osprey-dcs/Quartz/Quartz Design.xlsx

Boost Supply +12V -> +15V
Vin | 12
Vout | 15
Fosc | 1500000
DC |  | 0.2302631579
L1 | Ltyp | 1.796052632e-06 | Picked 6.8uH
 | Lmin | -3.215686275e-06 | 6.8e-06
 | Lmax | 9.978070175e-06
I ripple |  |  | 0.26413
I_OUT |  |  | 2.207557006
D1 |  |  | Using PDS360Q-13; 60V 3A
Cout | 2.400509402e-06 | Using 10uF | RDSon for PMOS is 8mOhm
Cin | 5.203495872e-07 | Using 10uF
Rfbx | 165618.2473 | Using 165kOhm
Rt | 53.4 | Using 53.6kOhm
Inverting Supply +12V -> -15V
Vin | 12
Vout | -15
Fosc | 1500000
DC |  | 0.5698529412
L1 | Ltyp | 4.444852941e-06 | Picked 15uH
 | Lmin | 1.490196078e-06 | 1.5e-05
 | Lmax | 2.469362745e-05
I ripple |  |  | 0.29632
I_OUT |  |  | 1.226709829
D1 |  |  | Using PD3S230H; 30V 2A
C1 |  |  | Using 2.2uF ; 50V | GCJ31CR71H225KA12L
Cout | 3.29248366e-07 | Using 10uF
Cin | 7.914624183e-07 | Using 10uF
Rfbx | 180156.0624 | Using 180kOhm
Rt | 53.4 | Using 53.6kOhm
