osprey-dcs/Quartz/Models/3dModels/c-5747847-06-o-3d.igs

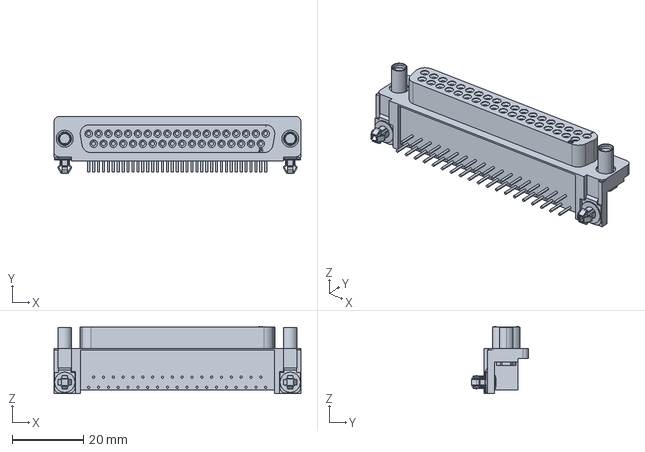
[picture p1: CAD file, 2024-01-31]
Models/3dModels/c-5747847-06-o-3d.igs
69.5 x 16.1 x 18.9 mm
