osprey-dcs/Quartz/Models/3dModels/EE2-3TNU-L.stp

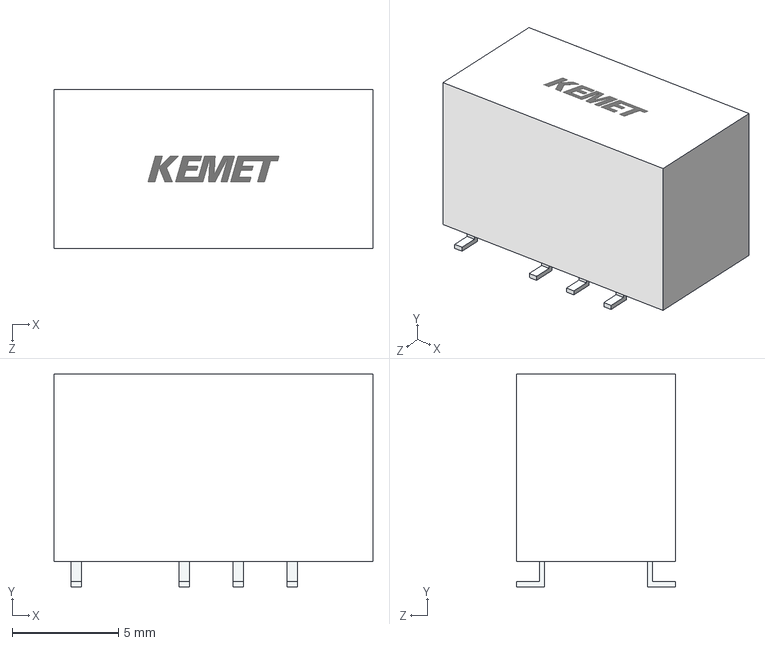
[picture p2: CAD file, 2024-01-31]
Models/3dModels/EE2-3TNU-L.stp
15.0 x 10.0 x 7.50 mm
