osprey-dcs/Quartz/Models/3dModels/901-144-8RFX.stp

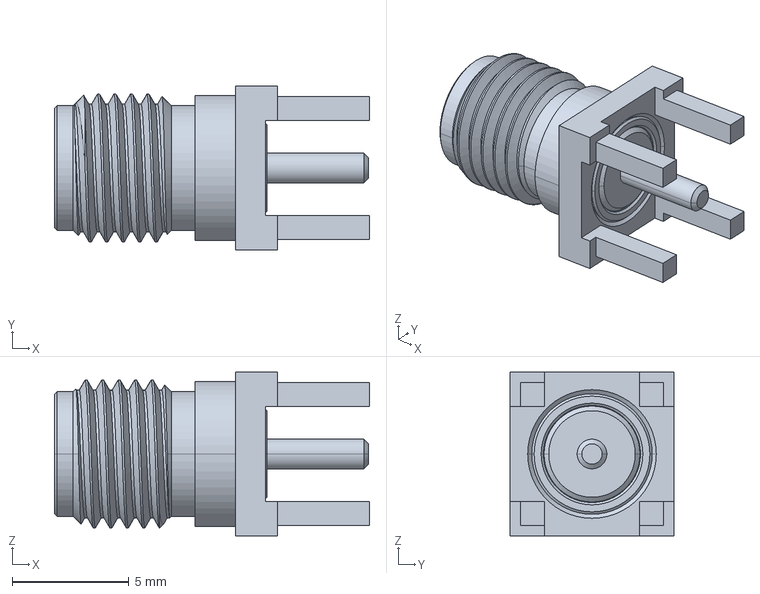
[picture p3: CAD file, 2024-01-31]
Models/3dModels/901-144-8RFX.stp
13.5 x 7.00 x 7.00 mm
