osprey-dcs/Quartz/Models/3dModels/EE2-12TNU-L.step

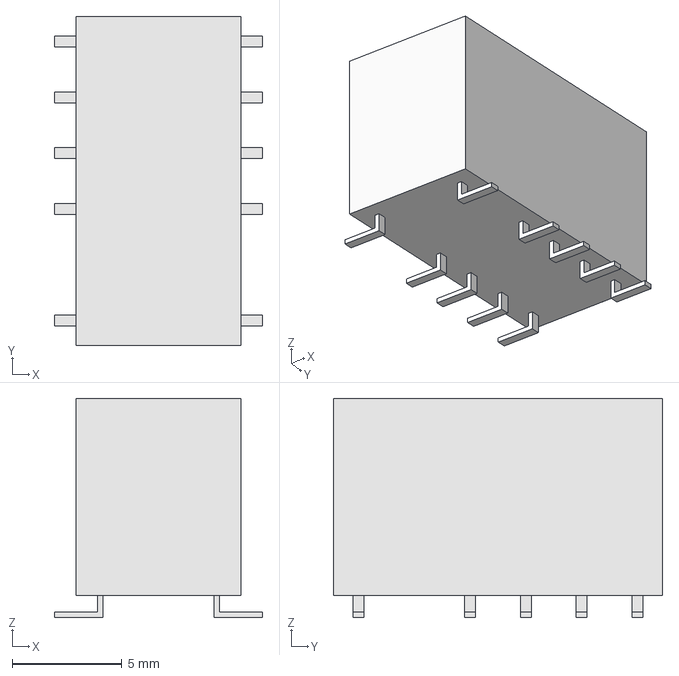
[picture p4: CAD file, 2024-01-31]
Models/3dModels/EE2-12TNU-L.step
9.50 x 15.0 x 10.0 mm
