osprey-dcs/Quartz/Models/3dModels/FDMC510P.stp

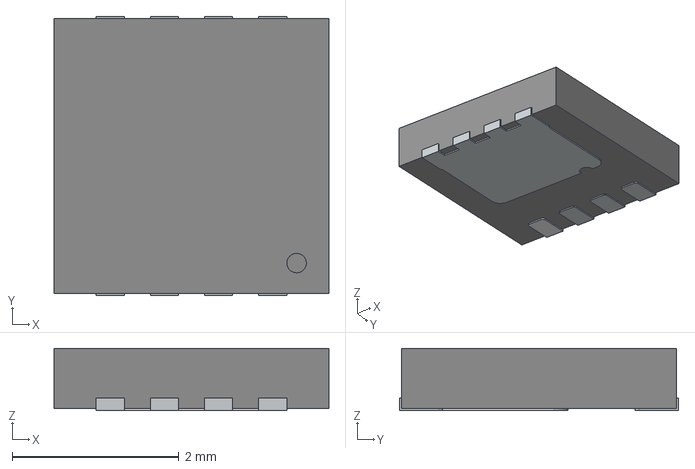
[picture p5: CAD file, 2024-01-31]
Models/3dModels/FDMC510P.stp
3.30 x 3.35 x 0.75 mm
