osprey-dcs/Quartz/Models/3dModels/Coilcraft-MSD1260-DEFAULT.IGS

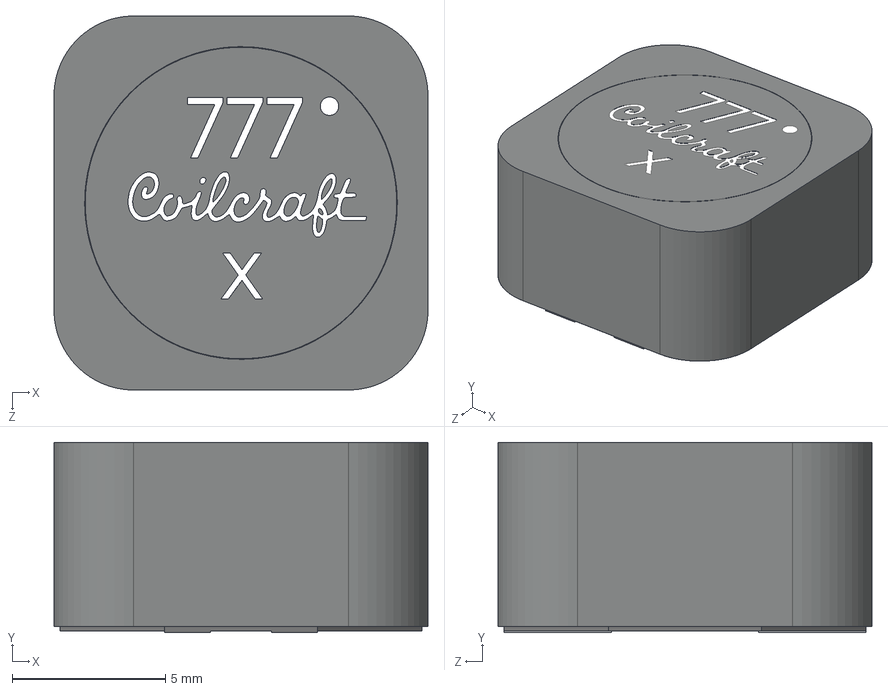
[picture p6: CAD file, 2024-01-31]
Models/3dModels/Coilcraft-MSD1260-DEFAULT.IGS
12.2 x 6.20 x 12.2 mm
