osprey-dcs/Quartz/Models/3dModels/LT3097ADJC.step

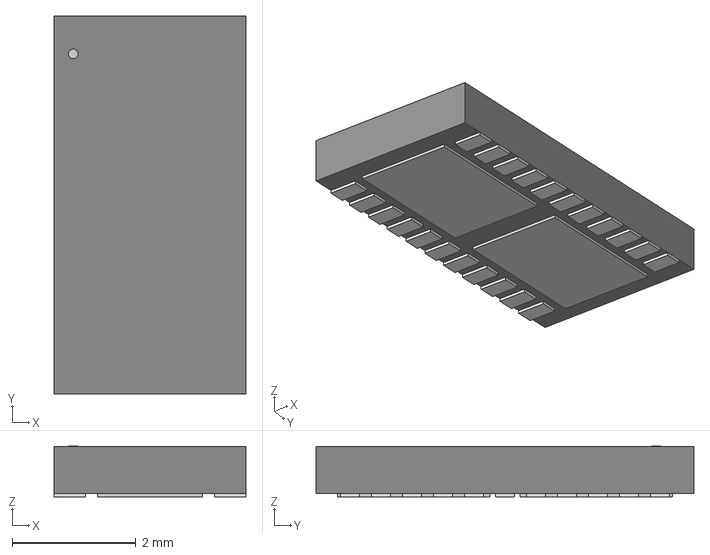
[picture p7: CAD file, 2024-01-31]
Models/3dModels/LT3097ADJC.step
3.10 x 6.10 x 0.815 mm
