osprey-dcs/Quartz/Models/3dModels/SIL0008D.stp

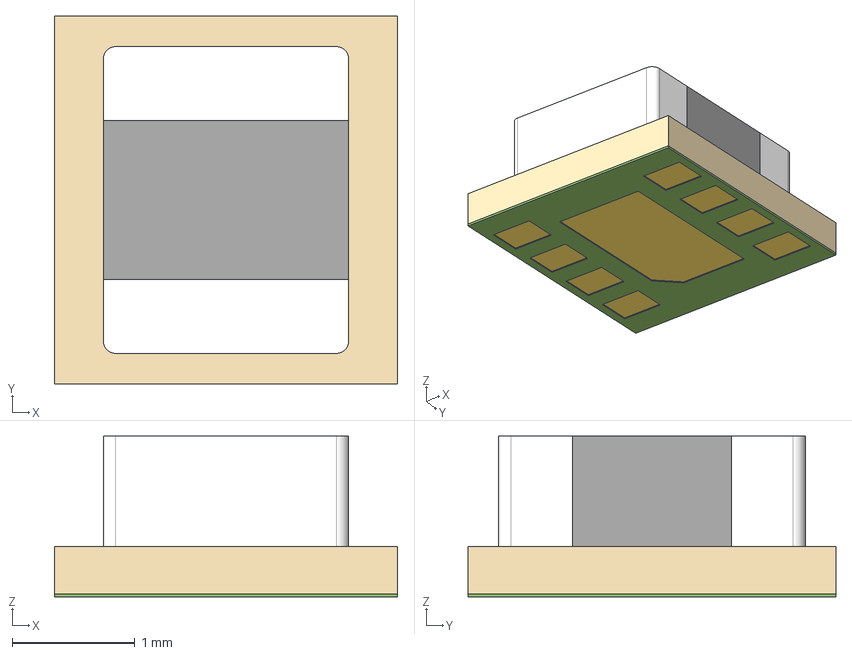
[picture p8: CAD file, 2024-01-31]
Models/3dModels/SIL0008D.stp
2.80 x 3.00 x 1.31 mm
SOLDERMASK-SIP
METAL-SIL0008D
SUBSTRATE-SIP
INDUCTOR-BODY-MLV
INDUCTOR-TERMNL-MLV x 2
