osprey-dcs/Quartz/Models/3dModels/PDS360Q-13.stp

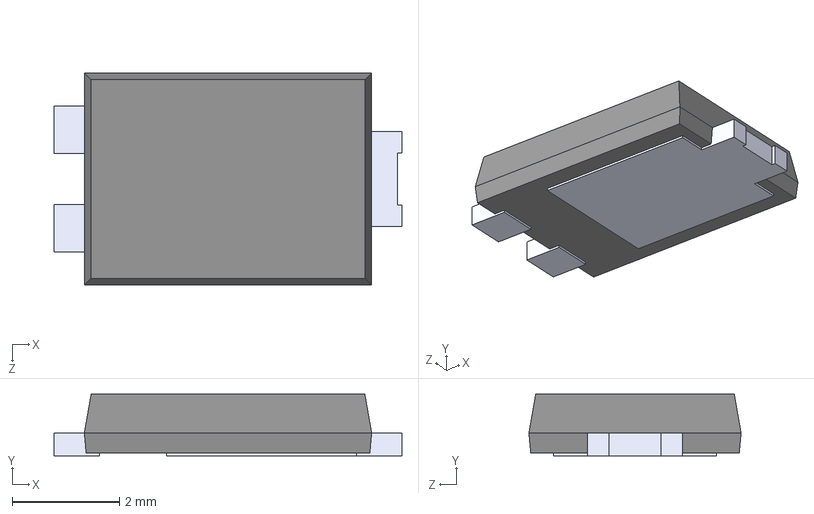
[picture p9: CAD file, 2024-01-31]
Models/3dModels/PDS360Q-13.stp
6.50 x 1.15 x 3.97 mm
