osprey-dcs/Quartz/Models/3dModels/ASP-134604-01.stp

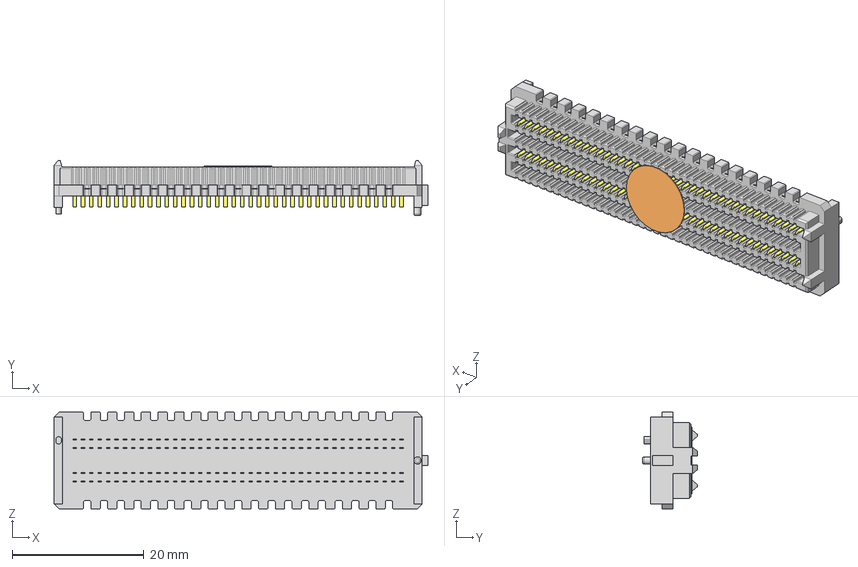
[picture p10: CAD file, 2024-01-31]
Models/3dModels/ASP-134604-01.stp
56.7 x 8.38 x 14.7 mm
K_Pad_0.404
SEAM-LPC-40-03.5-S-10-1-A_PINS
SEAM-40-03.5-10-A_BODY_
