osprey-dcs/Quartz/Models/3dModels/Coilcraft-XAL6060.IGS

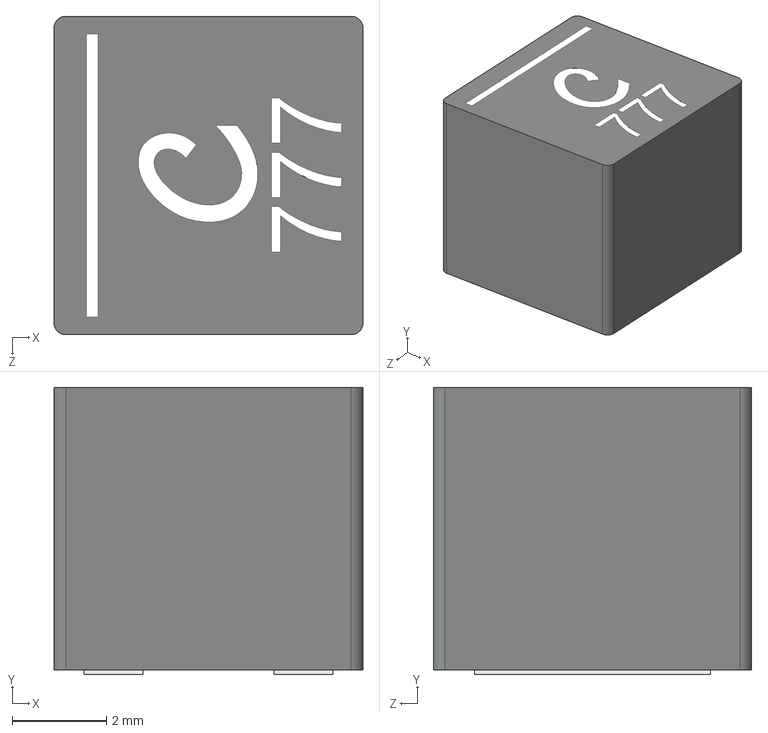
[picture p11: CAD file, 2024-01-31]
Models/3dModels/Coilcraft-XAL6060.IGS
6.56 x 6.10 x 6.76 mm
