osprey-dcs/Quartz/Models/3dModels/MSD1260-153MLD.stp

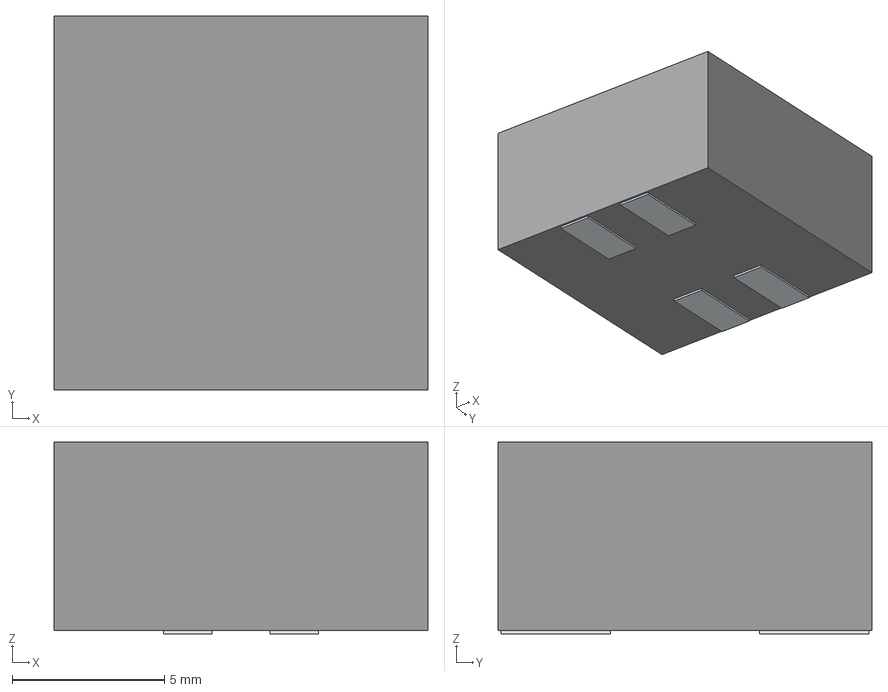
[picture p12: CAD file, 2024-01-31]
Models/3dModels/MSD1260-153MLD.stp
12.3 x 12.3 x 6.30 mm
Pins
