osprey-dcs/Quartz/(list of files, cad)

Other CAD files:
Models/3dModels/5747847-06-o-3d.stp
Models/3dModels/ASP-134604-01.stl
Models/3dModels/LT3097ADJC.iges
Models/3dModels/LT3097ADJC.stl
