osprey-dcs/Quartz/Documentation/Quartz Test Points.pdf

# Quartz Testing Points

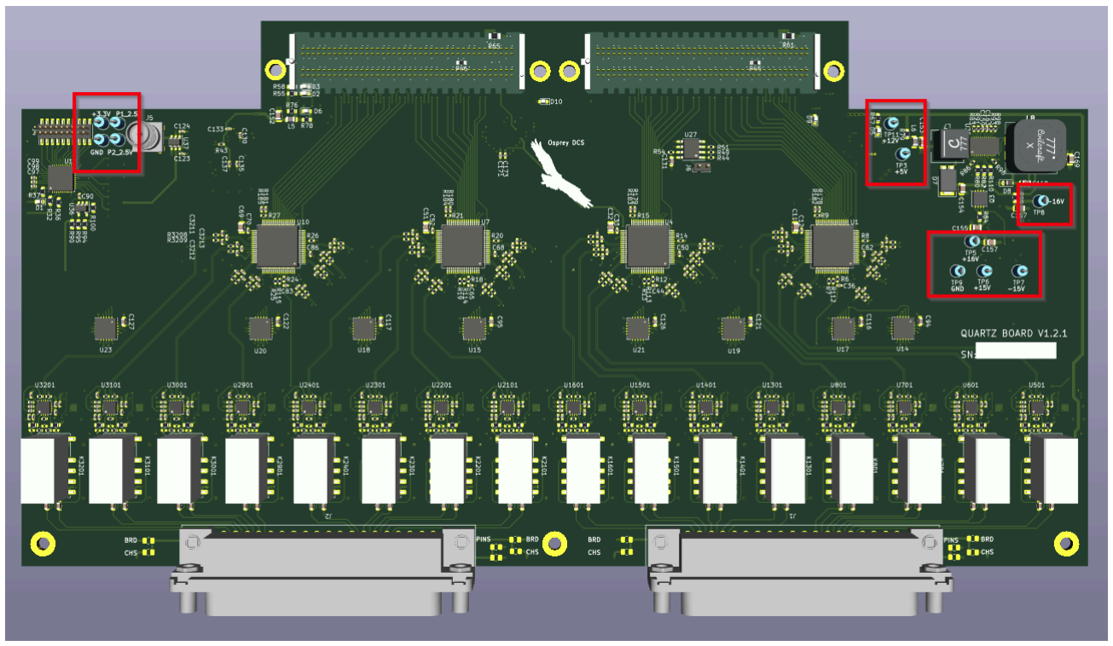
[picture p13: figure]

Image 1: 3D render of Quartz Boards with test points called out

Test Point Reference | Silkscreened Label | Nominal Voltage
TP 1 | P1_2P5V | +2.5V
TP 2 | P2_2P5V | +2.5V
TP 3 | +5V | +5V
TP 4 | +3.3V | +3.3V
TP 5 | +16V | +16V
TP 6 | +15V | +15V
TP 7 | -15V | -15V
TP 8 | -16V | -16V
TP 9 | GND | 0V
TP 10 | GND | 0V
TP 11 | +12V | +12V
Table 1:Test Point Names
