osprey-dcs/Quartz/Quartz.kicad_pcb

## KiCad design Quartz.kicad_pcb (2025-04-18)

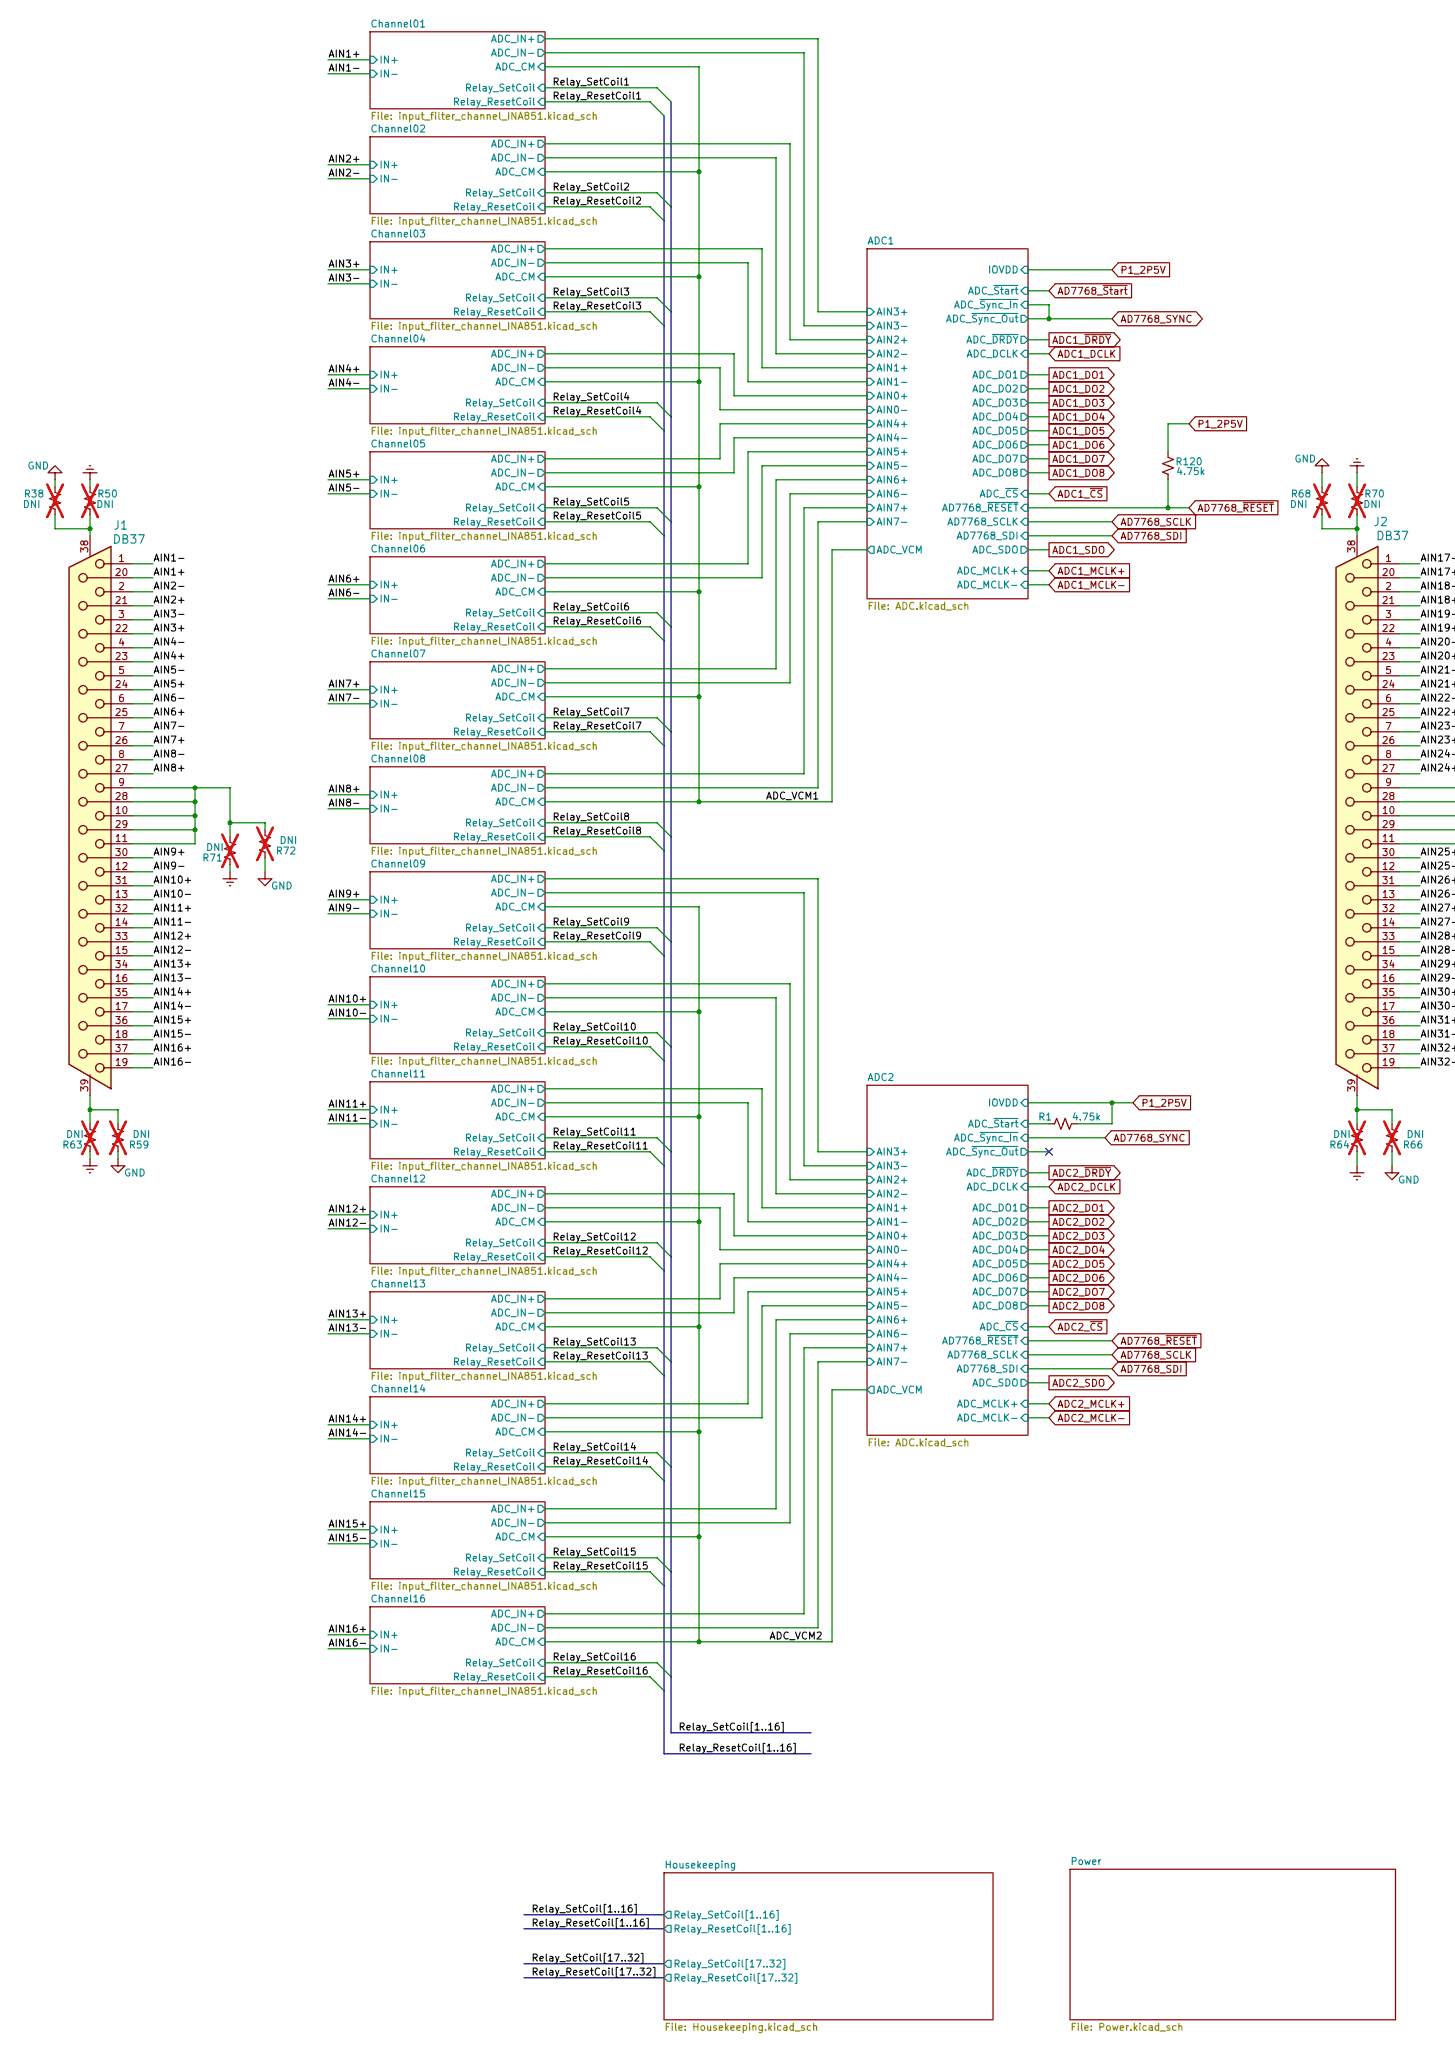
[picture p14: schematic Quartz.kicad_sch, part in row 1, column 1]

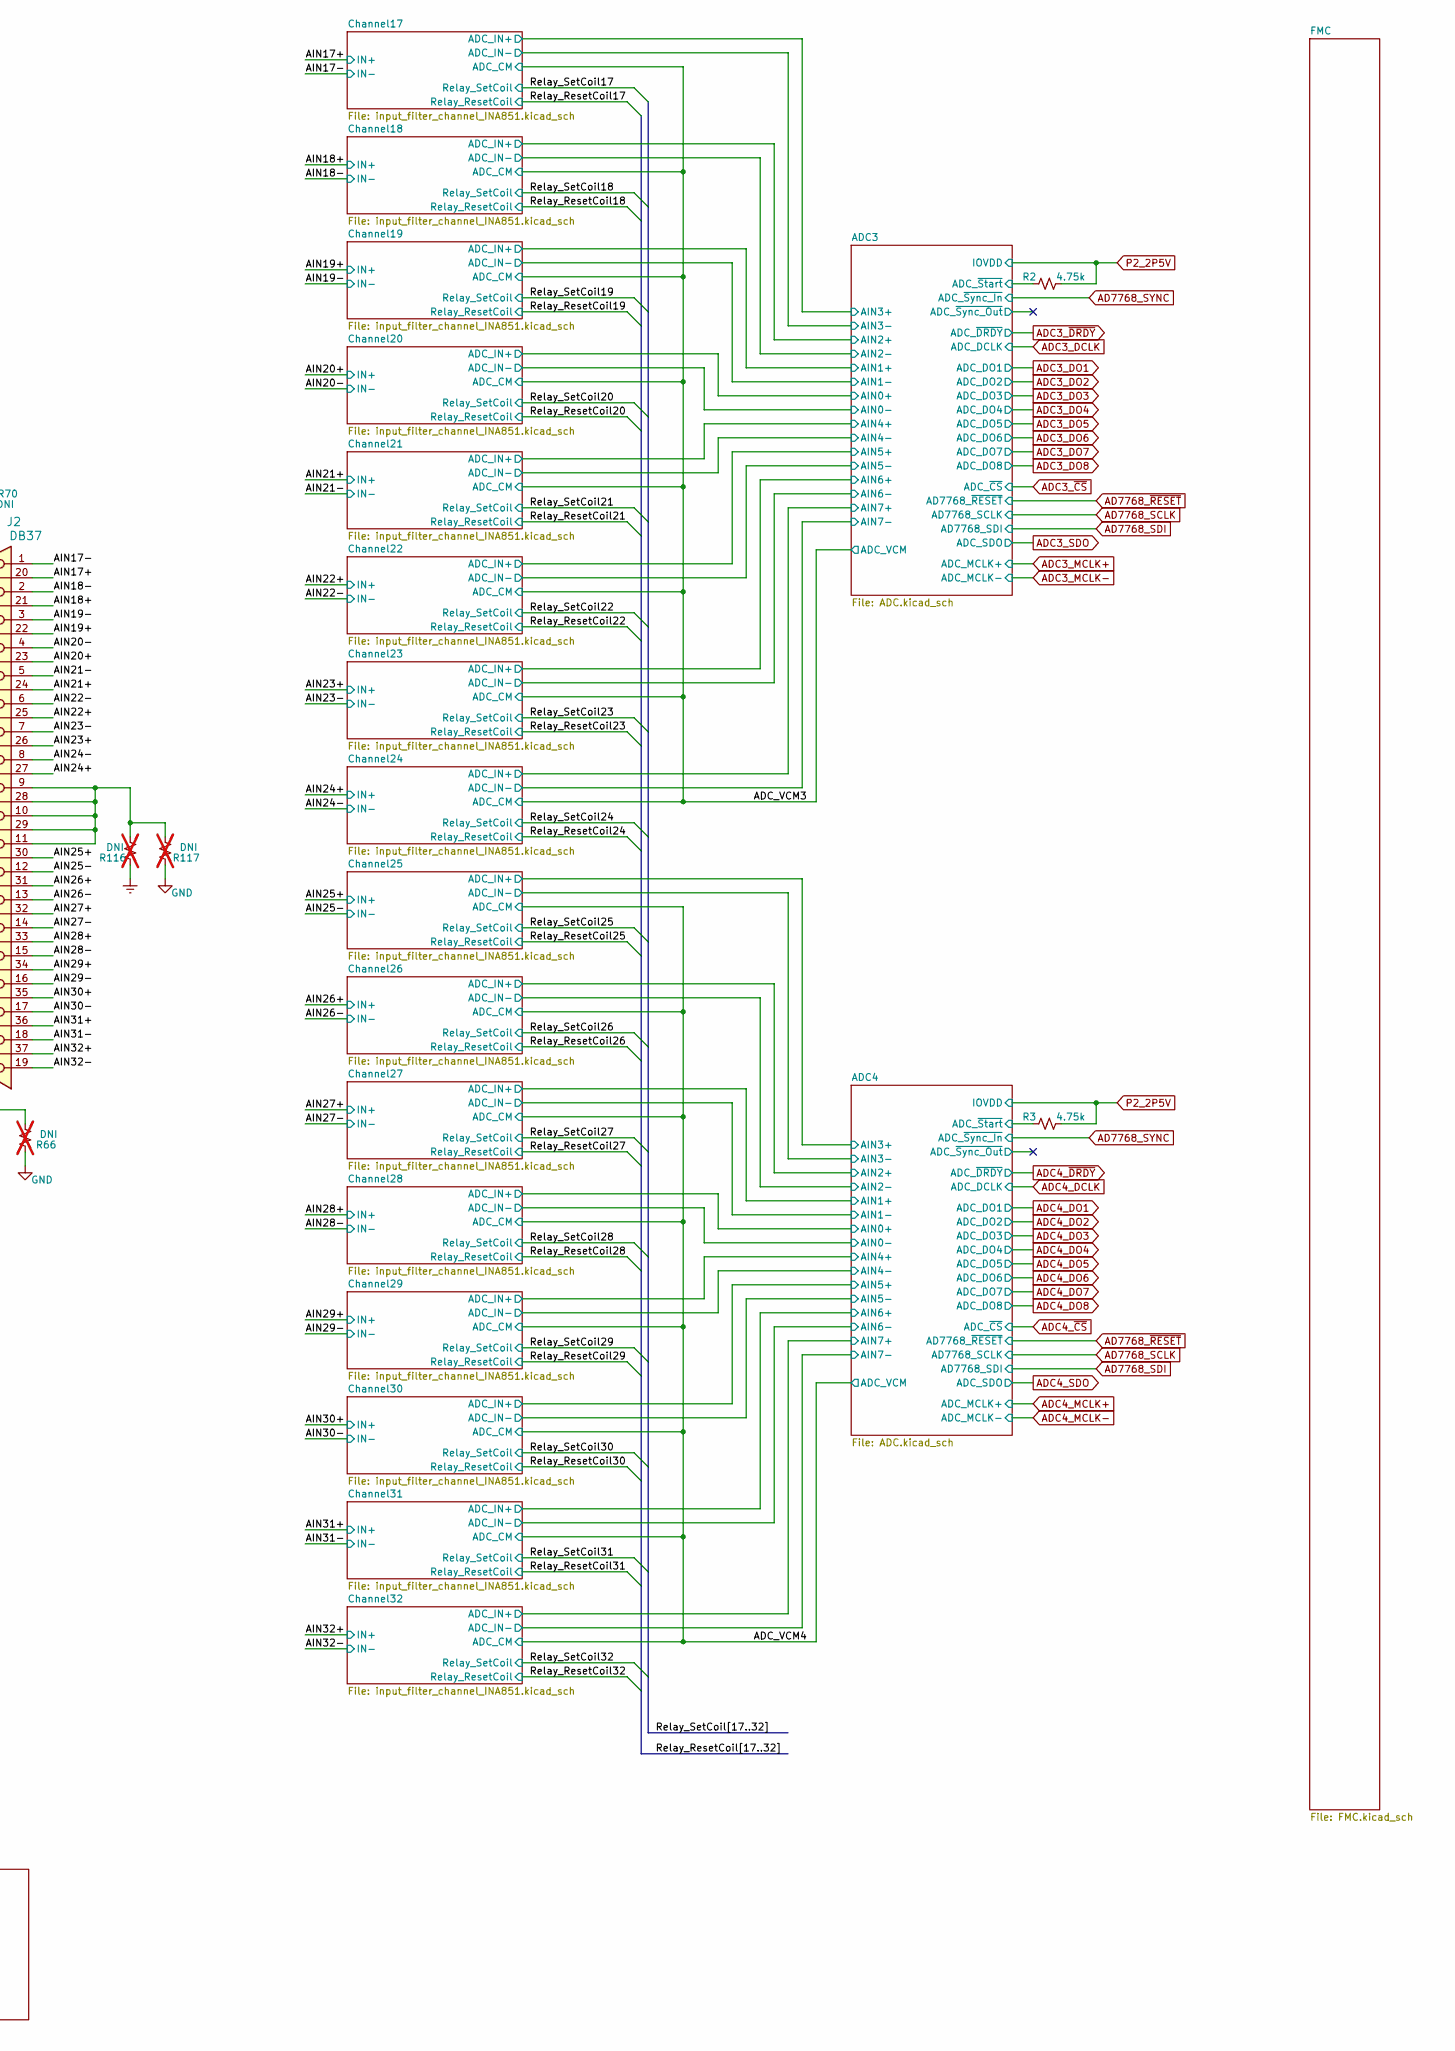
[picture p15: schematic Quartz.kicad_sch, part in row 1, column 2]

Parts:
J1, J2: DB37; CONN_5747847-6_TYC; MPN 5747847-6
R1, R2, R3, R120: 4.75k; R_0402_1005Metric; MPN RC0402FR-074K75L
R38, R50, R59, R63, R64, R66, R68, R70, R71, R72, R116, R117: DNI; R_0805_2012Metric; MPN DNI; not fitted

Connections:
/ADC2/ADC_~Start: R1.1; also elsewhere on the board
/ADC3/ADC_~Start: R2.1; also elsewhere on the board
/ADC4/ADC_~Start: R3.1; also elsewhere on the board
/AIN1+: J1.20; also elsewhere on the board
/AIN1-: J1.1; also elsewhere on the board
/AIN2+: J1.21; also elsewhere on the board
/AIN2-: J1.2; also elsewhere on the board
/AIN3+: J1.22; also elsewhere on the board
/AIN3-: J1.3; also elsewhere on the board
/AIN4+: J1.23; also elsewhere on the board
/AIN4-: J1.4; also elsewhere on the board
/AIN5+: J1.24; also elsewhere on the board
/AIN5-: J1.5; also elsewhere on the board
/AIN6+: J1.25; also elsewhere on the board
/AIN6-: J1.6; also elsewhere on the board
/AIN7+: J1.26; also elsewhere on the board
/AIN7-: J1.7; also elsewhere on the board
/AIN8+: J1.27; also elsewhere on the board
/AIN8-: J1.8; also elsewhere on the board
/AIN9+: J1.30; also elsewhere on the board
/AIN9-: J1.12; also elsewhere on the board
/AIN10+: J1.31; also elsewhere on the board
/AIN10-: J1.13; also elsewhere on the board
/AIN11+: J1.32; also elsewhere on the board
/AIN11-: J1.14; also elsewhere on the board
/AIN12+: J1.33; also elsewhere on the board
/AIN12-: J1.15; also elsewhere on the board
/AIN13+: J1.34; also elsewhere on the board
/AIN13-: J1.16; also elsewhere on the board
/AIN14+: J1.35; also elsewhere on the board
/AIN14-: J1.17; also elsewhere on the board
/AIN15+: J1.36; also elsewhere on the board
/AIN15-: J1.18; also elsewhere on the board
/AIN16+: J1.37; also elsewhere on the board
/AIN16-: J1.19; also elsewhere on the board
/AIN17+: J2.20; also elsewhere on the board
/AIN17-: J2.1; also elsewhere on the board
/AIN18+: J2.21; also elsewhere on the board
/AIN18-: J2.2; also elsewhere on the board
/AIN19+: J2.22; also elsewhere on the board
/AIN19-: J2.3; also elsewhere on the board
/AIN20+: J2.23; also elsewhere on the board
/AIN20-: J2.4; also elsewhere on the board
/AIN21+: J2.24; also elsewhere on the board
/AIN21-: J2.5; also elsewhere on the board
/AIN22+: J2.25; also elsewhere on the board
/AIN22-: J2.6; also elsewhere on the board
/AIN23+: J2.26; also elsewhere on the board
/AIN23-: J2.7; also elsewhere on the board
/AIN24+: J2.27; also elsewhere on the board
/AIN24-: J2.8; also elsewhere on the board
/AIN25+: J2.30; also elsewhere on the board
/AIN25-: J2.12; also elsewhere on the board
/AIN26+: J2.31; also elsewhere on the board
/AIN26-: J2.13; also elsewhere on the board
/AIN27+: J2.32; also elsewhere on the board
/AIN27-: J2.14; also elsewhere on the board
/AIN28+: J2.33; also elsewhere on the board
/AIN28-: J2.15; also elsewhere on the board
/AIN29+: J2.34; also elsewhere on the board
/AIN29-: J2.16; also elsewhere on the board
/AIN30+: J2.35; also elsewhere on the board
/AIN30-: J2.17; also elsewhere on the board
/AIN31+: J2.36; also elsewhere on the board
/AIN31-: J2.18; also elsewhere on the board
/AIN32+: J2.37; also elsewhere on the board
/AIN32-: J2.19; also elsewhere on the board
AD7768_~RESET: R120.1; also elsewhere on the board
Earth: R50.1, R63.1, R64.1, R70.1, R71.1, R116.1; also elsewhere on the board
GND: R38.1, R59.1, R66.1, R68.1, R72.1, R117.1; also elsewhere on the board
unnamed: J1.9, J1.10, J1.11, J1.28, J1.29, R71.2, R72.2
unnamed: J1.38, R38.2, R50.2
unnamed: J1.39, R59.2, R63.2
unnamed: J2.9, J2.10, J2.11, J2.28, J2.29, R116.2, R117.2
unnamed: J2.38, R68.2, R70.2
unnamed: J2.39, R64.2, R66.2
P1_2P5V: R1.2, R120.2; also elsewhere on the board
P2_2P5V: R2.2, R3.2; also elsewhere on the board
