osprey-dcs/Quartz/Quartz.kicad_pcb

## KiCad design Quartz.kicad_pcb (continued)

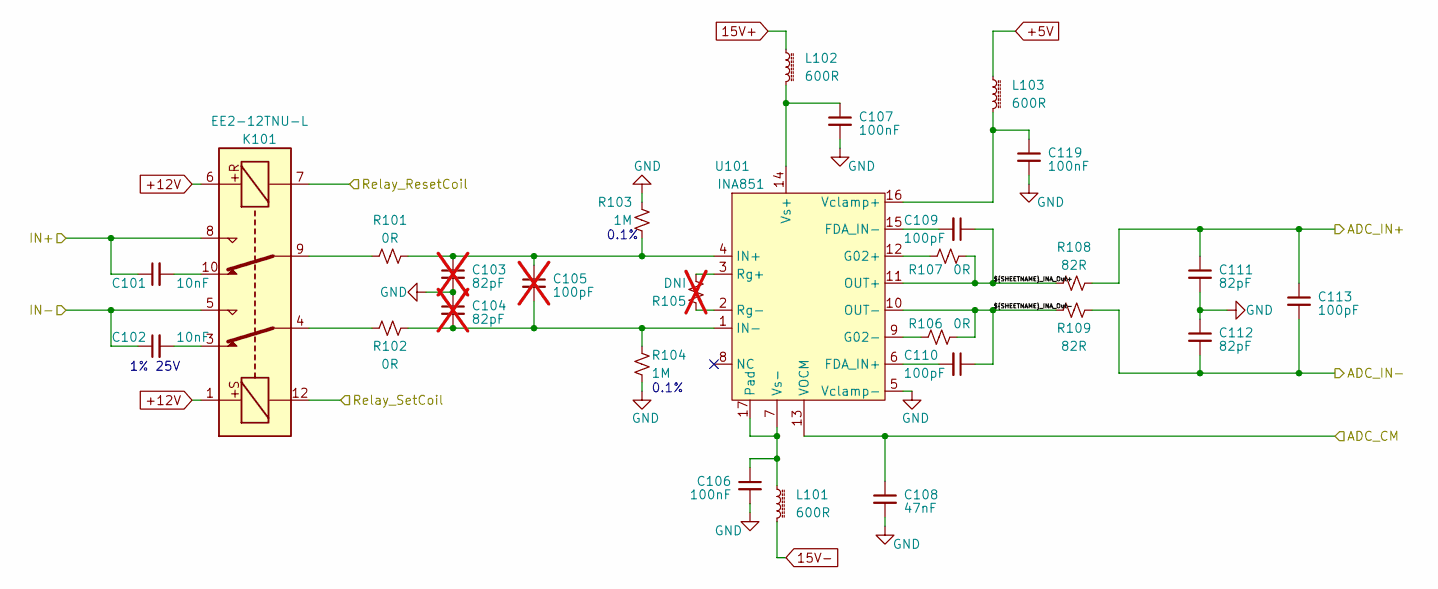
[picture p16: schematic input_filter_channel_INA851.kicad_sch, Quartz]

Parts:
C101, C102: 10nF; C_0603_1608Metric; MPN C0603C103F3GAC7867
C103, C104: 82pF; C_0402_1005Metric; MPN DNI; not fitted
C105: 100pF; C_0402_1005Metric; MPN DNI; not fitted
C106, C107, C119: 100nF; C_0402_1005Metric; MPN CL05A104KA5NNNC
C108: 47nF; C_0402_1005Metric; MPN CGA2B3X7R1H473K050BB
C109, C110, C113: 100pF; C_0402_1005Metric; MPN GRM1555C1H101JA01D
C111, C112: 82pF; C_0402_1005Metric; MPN CC0402JRNPO9BN820
K101: EE2-12TNU-L; Relay_DPDT_Kemet_EE2_NU_DoubleCoil; MPN EE2-12TNU-L
L101, L102, L103: 600R; L_0402_1005Metric; MPN BLM15AX601SN1D
R101, R102, R106, R107: 0R; R_0603_1608Metric; MPN ERJ-2GE0R00X
R103, R104: 1M; R_0603_1608Metric; MPN CPF0603B1M0E1
R105: DNI; R_0402_1005Metric; MPN TNPW040211K8BEED; not fitted
R108, R109: 82R; R_0402_1005Metric; MPN RC0402FR-0782RL
U101: INA851; QFN-16-1EP_3x3mm_P0.5mm_EP1.75x1.75mm_ThermalVias; MPN INA851RGTR

Connections:
15V+: L102.1; also elsewhere on the board
15V-: L101.2; also elsewhere on the board
+5V: L103.1; also elsewhere on the board
+12V: K101.1, K101.6; also elsewhere on the board
/ADC1/AIN3+: C111.1, C113.1, R108.2; also elsewhere on the board
/ADC1/AIN3-: C112.2, C113.2, R109.2; also elsewhere on the board
/ADC_VCM1: C108.1, U101.13 (VOCM); also elsewhere on the board
/AIN1+: C101.1, K101.8; also elsewhere on the board
/AIN1-: C102.1, K101.5; also elsewhere on the board
/Channel01/Channel01_INA_Out+: C109.1, R107.2, R108.1, U101.11 (OUT+)
/Channel01/Channel01_INA_Out-: C110.1, R106.2, R109.1, U101.10 (OUT-)
/Relay_ResetCoil1: K101.7; also elsewhere on the board
/Relay_SetCoil1: K101.12; also elsewhere on the board
GND: C103.2, C104.1, C106.2, C107.2, C108.2, C111.2, C112.1, C119.2, R103.1, R104.1, U101.5 (Vclamp-); also elsewhere on the board
unnamed: C101.2, K101.10
unnamed: C102.2, K101.3
unnamed: K101.4, R102.1
unnamed: K101.9, R101.1
unnamed: C110.2, U101.6 (FDA_IN+)
unnamed: C109.2, U101.15 (FDA_IN-)
unnamed: R107.1, U101.12 (G02+)
unnamed: R106.1, U101.9 (G02-)
unnamed: C103.1, C105.1, R101.2, R103.2, U101.4 (IN+)
unnamed: C104.2, C105.2, R102.2, R104.2, U101.1 (IN-)
unnamed: R105.1, U101.3 (Rg+)
unnamed: R105.2, U101.2 (Rg-)
unnamed: C119.1, L103.2, U101.16 (Vclamp+)
unnamed: C107.1, L102.2, U101.14 (Vs+)
unnamed: C106.1, L101.1, U101.7 (Vs-), U101.17 (Pad)

Parts of its further copies:
C201, C202, C301, C302, C401, C402, C501, C502, C601, C602, C701, C702, C801, C802, C901, C902, C1001, C1002, C1101, C1102, C1201, C1202, C1301, C1302, C1401, C1402, C1501, C1502, C1601, C1602, C1701, C1702, C1801, C1802, C1901, C1902, C2001, C2002, C2101, C2102, C2201, C2202, C2301, C2302, C2401, C2402, C2501, C2502, C2601, C2602, C2701, C2702, C2801, C2802, C2901, C2902, C3001, C3002, C3101, C3102, C3201, C3202: 10nF; C_0603_1608Metric; MPN C0603C103F3GAC7867
C203, C204, C303, C304, C403, C404, C503, C504, C603, C604, C703, C704, C803, C804, C903, C904, C1003, C1004, C1103, C1104, C1203, C1204, C1303, C1304, C1403, C1404, C1503, C1504, C1603, C1604, C1703, C1704, C1803, C1804, C1903, C1904, C2003, C2004, C2103, C2104, C2203, C2204, C2303, C2304, C2403, C2404, C2503, C2504, C2603, C2604, C2703, C2704, C2803, C2804, C2903, C2904, C3003, C3004, C3103, C3104, C3203, C3204: 82pF; C_0402_1005Metric; MPN DNI; not fitted
C205, C305, C405, C505, C605, C705, C805, C905, C1005, C1105, C1205, C1305, C1405, C1505, C1605, C1705, C1805, C1905, C2005, C2105, C2205, C2305, C2405, C2505, C2605, C2705, C2805, C2905, C3005, C3105, C3205: 100pF; C_0402_1005Metric; MPN DNI; not fitted
C206, C207, C214, C306, C307, C314, C406, C407, C414, C506, C507, C514, C606, C607, C614, C706, C707, C714, C806, C807, C814, C906, C907, C914, C1006, C1007, C1014, C1106, C1107, C1114, C1206, C1207, C1214, C1306, C1307, C1314, C1406, C1407, C1414, C1506, C1507, C1514, C1606, C1607, C1614, C1706, C1707, C1714, C1806, C1807, C1814, C1906, C1907, C1914, C2006, C2007, C2014, C2106, C2107, C2114, C2206, C2207, C2214, C2306, C2307, C2314, C2406, C2407, C2414, C2506, C2507, C2514, C2606, C2607, C2614, C2706, C2707, C2714, C2806, C2807, C2814, C2906, C2907, C2914, C3006, C3007, C3014, C3106, C3107, C3114, C3206, C3207, C3214: 100nF; C_0402_1005Metric; MPN CL05A104KA5NNNC
C208, C308, C408, C508, C608, C708, C808, C908, C1008, C1108, C1208, C1308, C1408, C1508, C1608, C1708, C1808, C1908, C2008, C2108, C2208, C2308, C2408, C2508, C2608, C2708, C2808, C2908, C3008, C3108, C3208: 47nF; C_0402_1005Metric; MPN CGA2B3X7R1H473K050BB
C209, C210, C213, C309, C310, C313, C409, C410, C413, C509, C510, C513, C609, C610, C613, C709, C710, C713, C809, C810, C813, C909, C910, C913, C1009, C1010, C1013, C1109, C1110, C1113, C1209, C1210, C1213, C1309, C1310, C1313, C1409, C1410, C1413, C1509, C1510, C1513, C1609, C1610, C1613, C1709, C1710, C1713, C1809, C1810, C1813, C1909, C1910, C1913, C2009, C2010, C2013, C2109, C2110, C2113, C2209, C2210, C2213, C2309, C2310, C2313, C2409, C2410, C2413, C2509, C2510, C2513, C2609, C2610, C2613, C2709, C2710, C2713, C2809, C2810, C2813, C2909, C2910, C2913, C3009, C3010, C3013, C3109, C3110, C3113, C3209, C3210, C3213: 100pF; C_0402_1005Metric; MPN GRM1555C1H101JA01D
C211, C212, C311, C312, C411, C412, C511, C512, C611, C612, C711, C712, C811, C812, C911, C912, C1011, C1012, C1111, C1112, C1211, C1212, C1311, C1312, C1411, C1412, C1511, C1512, C1611, C1612, C1711, C1712, C1811, C1812, C1911, C1912, C2011, C2012, C2111, C2112, C2211, C2212, C2311, C2312, C2411, C2412, C2511, C2512, C2611, C2612, C2711, C2712, C2811, C2812, C2911, C2912, C3011, C3012, C3111, C3112, C3211, C3212: 82pF; C_0402_1005Metric; MPN CC0402JRNPO9BN820
K201, K301, K401, K501, K601, K701, K801, K901, K1001, K1101, K1201, K1301, K1401, K1501, K1601, K1701, K1801, K1901, K2001, K2101, K2201, K2301, K2401, K2501, K2601, K2701, K2801, K2901, K3001, K3101, K3201: EE2-12TNU-L; Relay_DPDT_Kemet_EE2_NU_DoubleCoil; MPN EE2-12TNU-L
L201, L202, L203, L301, L302, L303, L401, L402, L403, L501, L502, L503, L601, L602, L603, L701, L702, L703, L801, L802, L803, L901, L902, L903, L1001, L1002, L1003, L1101, L1102, L1103, L1201, L1202, L1203, L1301, L1302, L1303, L1401, L1402, L1403, L1501, L1502, L1503, L1601, L1602, L1603, L1701, L1702, L1703, L1801, L1802, L1803, L1901, L1902, L1903, L2001, L2002, L2003, L2101, L2102, L2103, L2201, L2202, L2203, L2301, L2302, L2303, L2401, L2402, L2403, L2501, L2502, L2503, L2601, L2602, L2603, L2701, L2702, L2703, L2801, L2802, L2803, L2901, L2902, L2903, L3001, L3002, L3003, L3101, L3102, L3103, L3201, L3202, L3203: 600R; L_0402_1005Metric; MPN BLM15AX601SN1D
R201, R202, R206, R207, R301, R302, R306, R307, R401, R402, R406, R407, R501, R502, R506, R507, R601, R602, R606, R607, R701, R702, R706, R707, R801, R802, R806, R807, R901, R902, R906, R907, R1001, R1002, R1006, R1007, R1101, R1102, R1106, R1107, R1201, R1202, R1206, R1207, R1301, R1302, R1306, R1307, R1401, R1402, R1406, R1407, R1501, R1502, R1506, R1507, R1601, R1602, R1606, R1607, R1701, R1702, R1706, R1707, R1801, R1802, R1806, R1807, R1901, R1902, R1906, R1907, R2001, R2002, R2006, R2007, R2101, R2102, R2106, R2107, R2201, R2202, R2206, R2207, R2301, R2302, R2306, R2307, R2401, R2402, R2406, R2407, R2501, R2502, R2506, R2507, R2601, R2602, R2606, R2607, R2701, R2702, R2706, R2707, R2801, R2802, R2806, R2807, R2901, R2902, R2906, R2907, R3001, R3002, R3006, R3007, R3101, R3102, R3106, R3107, R3201, R3202, R3206, R3207: 0R; R_0603_1608Metric; MPN ERJ-2GE0R00X
R203, R204, R303, R304, R403, R404, R503, R504, R603, R604, R703, R704, R803, R804, R903, R904, R1003, R1004, R1103, R1104, R1203, R1204, R1303, R1304, R1403, R1404, R1503, R1504, R1603, R1604, R1703, R1704, R1803, R1804, R1903, R1904, R2003, R2004, R2103, R2104, R2203, R2204, R2303, R2304, R2403, R2404, R2503, R2504, R2603, R2604, R2703, R2704, R2803, R2804, R2903, R2904, R3003, R3004, R3103, R3104, R3203, R3204: 1M; R_0603_1608Metric; MPN CPF0603B1M0E1
R205, R305, R405, R505, R605, R705, R805, R905, R1005, R1105, R1205, R1305, R1405, R1505, R1605, R1705, R1805, R1905, R2005, R2105, R2205, R2305, R2405, R2505, R2605, R2705, R2805, R2905, R3005, R3105, R3205: DNI; R_0402_1005Metric; MPN TNPW040211K8BEED; not fitted
R208, R209, R308, R309, R408, R409, R508, R509, R608, R609, R708, R709, R808, R809, R908, R909, R1008, R1009, R1108, R1109, R1208, R1209, R1308, R1309, R1408, R1409, R1508, R1509, R1608, R1609, R1708, R1709, R1808, R1809, R1908, R1909, R2008, R2009, R2108, R2109, R2208, R2209, R2308, R2309, R2408, R2409, R2508, R2509, R2608, R2609, R2708, R2709, R2808, R2809, R2908, R2909, R3008, R3009, R3108, R3109, R3208, R3209: 82R; R_0402_1005Metric; MPN RC0402FR-0782RL
U201, U301, U401, U501, U601, U701, U801, U901, U1001, U1101, U1201, U1301, U1401, U1501, U1601, U1701, U1801, U1901, U2001, U2101, U2201, U2301, U2401, U2501, U2601, U2701, U2801, U2901, U3001, U3101, U3201: INA851; QFN-16-1EP_3x3mm_P0.5mm_EP1.75x1.75mm_ThermalVias; MPN INA851RGTR

Connections of its further copies:
15V+: L202.1, L302.1, L402.1, L502.1, L602.1, L702.1, L802.1, L902.1, L1002.1, L1102.1, L1202.1, L1302.1, L1402.1, L1502.1, L1602.1, L1702.1, L1802.1, L1902.1, L2002.1, L2102.1, L2202.1, L2302.1, L2402.1, L2502.1, L2602.1, L2702.1, L2802.1, L2902.1, L3002.1, L3102.1, L3202.1; also elsewhere on the board
15V-: L201.2, L301.2, L401.2, L501.2, L601.2, L701.2, L801.2, L901.2, L1001.2, L1101.2, L1201.2, L1301.2, L1401.2, L1501.2, L1601.2, L1701.2, L1801.2, L1901.2, L2001.2, L2101.2, L2201.2, L2301.2, L2401.2, L2501.2, L2601.2, L2701.2, L2801.2, L2901.2, L3001.2, L3101.2, L3201.2; also elsewhere on the board
+5V: L203.1, L303.1, L403.1, L503.1, L603.1, L703.1, L803.1, L903.1, L1003.1, L1103.1, L1203.1, L1303.1, L1403.1, L1503.1, L1603.1, L1703.1, L1803.1, L1903.1, L2003.1, L2103.1, L2203.1, L2303.1, L2403.1, L2503.1, L2603.1, L2703.1, L2803.1, L2903.1, L3003.1, L3103.1, L3203.1; also elsewhere on the board
+12V: K201.1, K201.6, K301.1, K301.6, K401.1, K401.6, K501.1, K501.6, K601.1, K601.6, K701.1, K701.6, K801.1, K801.6, K901.1, K901.6, K1001.1, K1001.6, K1101.1, K1101.6, K1201.1, K1201.6, K1301.1, K1301.6, K1401.1, K1401.6, K1501.1, K1501.6, K1601.1, K1601.6, K1701.1, K1701.6, K1801.1, K1801.6, K1901.1, K1901.6, K2001.1, K2001.6, K2101.1, K2101.6, K2201.1, K2201.6, K2301.1, K2301.6, K2401.1, K2401.6, K2501.1, K2501.6, K2601.1, K2601.6, K2701.1, K2701.6, K2801.1, K2801.6, K2901.1, K2901.6, K3001.1, K3001.6, K3101.1, K3101.6, K3201.1, K3201.6; also elsewhere on the board
/ADC1/AIN0+: C411.1, C413.1, R408.2; also elsewhere on the board
/ADC1/AIN0-: C412.2, C413.2, R409.2; also elsewhere on the board
/ADC1/AIN1+: C311.1, C313.1, R308.2; also elsewhere on the board
/ADC1/AIN1-: C312.2, C313.2, R309.2; also elsewhere on the board
/ADC1/AIN2+: C211.1, C213.1, R208.2; also elsewhere on the board
/ADC1/AIN2-: C212.2, C213.2, R209.2; also elsewhere on the board
/ADC1/AIN4+: C511.1, C513.1, R508.2; also elsewhere on the board
/ADC1/AIN4-: C512.2, C513.2, R509.2; also elsewhere on the board
/ADC1/AIN5+: C611.1, C613.1, R608.2; also elsewhere on the board
/ADC1/AIN5-: C612.2, C613.2, R609.2; also elsewhere on the board
/ADC1/AIN6+: C711.1, C713.1, R708.2; also elsewhere on the board
/ADC1/AIN6-: C712.2, C713.2, R709.2; also elsewhere on the board
/ADC1/AIN7+: C811.1, C813.1, R808.2; also elsewhere on the board
/ADC1/AIN7-: C812.2, C813.2, R809.2; also elsewhere on the board
/ADC2/AIN0+: C1211.1, C1213.1, R1208.2; also elsewhere on the board
/ADC2/AIN0-: C1212.2, C1213.2, R1209.2; also elsewhere on the board
/ADC2/AIN1+: C1111.1, C1113.1, R1108.2; also elsewhere on the board
/ADC2/AIN1-: C1112.2, C1113.2, R1109.2; also elsewhere on the board
/ADC2/AIN2+: C1011.1, C1013.1, R1008.2; also elsewhere on the board
/ADC2/AIN2-: C1012.2, C1013.2, R1009.2; also elsewhere on the board
/ADC2/AIN3+: C911.1, C913.1, R908.2; also elsewhere on the board
/ADC2/AIN3-: C912.2, C913.2, R909.2; also elsewhere on the board
/ADC2/AIN4+: C1311.1, C1313.1, R1308.2; also elsewhere on the board
/ADC2/AIN4-: C1312.2, C1313.2, R1309.2; also elsewhere on the board
/ADC2/AIN5+: C1411.1, C1413.1, R1408.2; also elsewhere on the board
/ADC2/AIN5-: C1412.2, C1413.2, R1409.2; also elsewhere on the board
/ADC2/AIN6+: C1511.1, C1513.1, R1508.2; also elsewhere on the board
/ADC2/AIN6-: C1512.2, C1513.2, R1509.2; also elsewhere on the board
/ADC2/AIN7+: C1611.1, C1613.1, R1608.2; also elsewhere on the board
/ADC2/AIN7-: C1612.2, C1613.2, R1609.2; also elsewhere on the board
/ADC3/AIN0+: C2011.1, C2013.1, R2008.2; also elsewhere on the board
/ADC3/AIN0-: C2012.2, C2013.2, R2009.2; also elsewhere on the board
/ADC3/AIN1+: C1911.1, C1913.1, R1908.2; also elsewhere on the board
/ADC3/AIN1-: C1912.2, C1913.2, R1909.2; also elsewhere on the board
/ADC3/AIN2+: C1811.1, C1813.1, R1808.2; also elsewhere on the board
/ADC3/AIN2-: C1812.2, C1813.2, R1809.2; also elsewhere on the board
/ADC3/AIN3+: C1711.1, C1713.1, R1708.2; also elsewhere on the board
/ADC3/AIN3-: C1712.2, C1713.2, R1709.2; also elsewhere on the board
/ADC3/AIN4+: C2111.1, C2113.1, R2108.2; also elsewhere on the board
/ADC3/AIN4-: C2112.2, C2113.2, R2109.2; also elsewhere on the board
/ADC3/AIN5+: C2211.1, C2213.1, R2208.2; also elsewhere on the board
/ADC3/AIN5-: C2212.2, C2213.2, R2209.2; also elsewhere on the board
/ADC3/AIN6+: C2311.1, C2313.1, R2308.2; also elsewhere on the board
/ADC3/AIN6-: C2312.2, C2313.2, R2309.2; also elsewhere on the board
/ADC3/AIN7+: C2411.1, C2413.1, R2408.2; also elsewhere on the board
/ADC3/AIN7-: C2412.2, C2413.2, R2409.2; also elsewhere on the board
/ADC4/AIN0+: C2811.1, C2813.1, R2808.2; also elsewhere on the board
/ADC4/AIN0-: C2812.2, C2813.2, R2809.2; also elsewhere on the board
/ADC4/AIN1+: C2711.1, C2713.1, R2708.2; also elsewhere on the board
/ADC4/AIN1-: C2712.2, C2713.2, R2709.2; also elsewhere on the board
/ADC4/AIN2+: C2611.1, C2613.1, R2608.2; also elsewhere on the board
/ADC4/AIN2-: C2612.2, C2613.2, R2609.2; also elsewhere on the board
/ADC4/AIN3+: C2511.1, C2513.1, R2508.2; also elsewhere on the board
/ADC4/AIN3-: C2512.2, C2513.2, R2509.2; also elsewhere on the board
/ADC4/AIN4+: C2911.1, C2913.1, R2908.2; also elsewhere on the board
/ADC4/AIN4-: C2912.2, C2913.2, R2909.2; also elsewhere on the board
/ADC4/AIN5+: C3011.1, C3013.1, R3008.2; also elsewhere on the board
/ADC4/AIN5-: C3012.2, C3013.2, R3009.2; also elsewhere on the board
/ADC4/AIN6+: C3111.1, C3113.1, R3108.2; also elsewhere on the board
/ADC4/AIN6-: C3112.2, C3113.2, R3109.2; also elsewhere on the board
/ADC4/AIN7+: C3211.1, C3213.1, R3208.2; also elsewhere on the board
/ADC4/AIN7-: C3212.2, C3213.2, R3209.2; also elsewhere on the board
/ADC_VCM1: C208.1, C308.1, C408.1, C508.1, C608.1, C708.1, C808.1, U201.13 (VOCM), U301.13 (VOCM), U401.13 (VOCM), U501.13 (VOCM), U601.13 (VOCM), U701.13 (VOCM), U801.13 (VOCM); also elsewhere on the board
/ADC_VCM2: C908.1, C1008.1, C1108.1, C1208.1, C1308.1, C1408.1, C1508.1, C1608.1, U901.13 (VOCM), U1001.13 (VOCM), U1101.13 (VOCM), U1201.13 (VOCM), U1301.13 (VOCM), U1401.13 (VOCM), U1501.13 (VOCM), U1601.13 (VOCM); also elsewhere on the board
/ADC_VCM3: C1708.1, C1808.1, C1908.1, C2008.1, C2108.1, C2208.1, C2308.1, C2408.1, U1701.13 (VOCM), U1801.13 (VOCM), U1901.13 (VOCM), U2001.13 (VOCM), U2101.13 (VOCM), U2201.13 (VOCM), U2301.13 (VOCM), U2401.13 (VOCM); also elsewhere on the board
/ADC_VCM4: C2508.1, C2608.1, C2708.1, C2808.1, C2908.1, C3008.1, C3108.1, C3208.1, U2501.13 (VOCM), U2601.13 (VOCM), U2701.13 (VOCM), U2801.13 (VOCM), U2901.13 (VOCM), U3001.13 (VOCM), U3101.13 (VOCM), U3201.13 (VOCM); also elsewhere on the board
/AIN2+: C201.1, K201.8; also elsewhere on the board
/AIN2-: C202.1, K201.5; also elsewhere on the board
/AIN3+: C301.1, K301.8; also elsewhere on the board
/AIN3-: C302.1, K301.5; also elsewhere on the board
/AIN4+: C401.1, K401.8; also elsewhere on the board
/AIN4-: C402.1, K401.5; also elsewhere on the board
/AIN5+: C501.1, K501.8; also elsewhere on the board
/AIN5-: C502.1, K501.5; also elsewhere on the board
/AIN6+: C601.1, K601.8; also elsewhere on the board
/AIN6-: C602.1, K601.5; also elsewhere on the board
/AIN7+: C701.1, K701.8; also elsewhere on the board
/AIN7-: C702.1, K701.5; also elsewhere on the board
/AIN8+: C801.1, K801.8; also elsewhere on the board
/AIN8-: C802.1, K801.5; also elsewhere on the board
/AIN9+: C901.1, K901.8; also elsewhere on the board
/AIN9-: C902.1, K901.5; also elsewhere on the board
/AIN10+: C1001.1, K1001.8; also elsewhere on the board
/AIN10-: C1002.1, K1001.5; also elsewhere on the board
/AIN11+: C1101.1, K1101.8; also elsewhere on the board
/AIN11-: C1102.1, K1101.5; also elsewhere on the board
/AIN12+: C1201.1, K1201.8; also elsewhere on the board
/AIN12-: C1202.1, K1201.5; also elsewhere on the board
/AIN13+: C1301.1, K1301.8; also elsewhere on the board
/AIN13-: C1302.1, K1301.5; also elsewhere on the board
/AIN14+: C1401.1, K1401.8; also elsewhere on the board
/AIN14-: C1402.1, K1401.5; also elsewhere on the board
/AIN15+: C1501.1, K1501.8; also elsewhere on the board
/AIN15-: C1502.1, K1501.5; also elsewhere on the board
/AIN16+: C1601.1, K1601.8; also elsewhere on the board
/AIN16-: C1602.1, K1601.5; also elsewhere on the board
/AIN17+: C1701.1, K1701.8; also elsewhere on the board
/AIN17-: C1702.1, K1701.5; also elsewhere on the board
/AIN18+: C1801.1, K1801.8; also elsewhere on the board
/AIN18-: C1802.1, K1801.5; also elsewhere on the board
/AIN19+: C1901.1, K1901.8; also elsewhere on the board
/AIN19-: C1902.1, K1901.5; also elsewhere on the board
/AIN20+: C2001.1, K2001.8; also elsewhere on the board
/AIN20-: C2002.1, K2001.5; also elsewhere on the board
/AIN21+: C2101.1, K2101.8; also elsewhere on the board
/AIN21-: C2102.1, K2101.5; also elsewhere on the board
/AIN22+: C2201.1, K2201.8; also elsewhere on the board
/AIN22-: C2202.1, K2201.5; also elsewhere on the board
/AIN23+: C2301.1, K2301.8; also elsewhere on the board
/AIN23-: C2302.1, K2301.5; also elsewhere on the board
/AIN24+: C2401.1, K2401.8; also elsewhere on the board
/AIN24-: C2402.1, K2401.5; also elsewhere on the board
/AIN25+: C2501.1, K2501.8; also elsewhere on the board
/AIN25-: C2502.1, K2501.5; also elsewhere on the board
/AIN26+: C2601.1, K2601.8; also elsewhere on the board
/AIN26-: C2602.1, K2601.5; also elsewhere on the board
/AIN27+: C2701.1, K2701.8; also elsewhere on the board
/AIN27-: C2702.1, K2701.5; also elsewhere on the board
/AIN28+: C2801.1, K2801.8; also elsewhere on the board
/AIN28-: C2802.1, K2801.5; also elsewhere on the board
/AIN29+: C2901.1, K2901.8; also elsewhere on the board
/AIN29-: C2902.1, K2901.5; also elsewhere on the board
/AIN30+: C3001.1, K3001.8; also elsewhere on the board
/AIN30-: C3002.1, K3001.5; also elsewhere on the board
/AIN31+: C3101.1, K3101.8; also elsewhere on the board
/AIN31-: C3102.1, K3101.5; also elsewhere on the board
/AIN32+: C3201.1, K3201.8; also elsewhere on the board
/AIN32-: C3202.1, K3201.5; also elsewhere on the board
/Channel02/Channel02_INA_Out+: C209.1, R207.2, R208.1, U201.11 (OUT+)
/Channel02/Channel02_INA_Out-: C210.1, R206.2, R209.1, U201.10 (OUT-)
/Channel03/Channel03_INA_Out+: C309.1, R307.2, R308.1, U301.11 (OUT+)
/Channel03/Channel03_INA_Out-: C310.1, R306.2, R309.1, U301.10 (OUT-)
/Channel04/Channel04_INA_Out+: C409.1, R407.2, R408.1, U401.11 (OUT+)
/Channel04/Channel04_INA_Out-: C410.1, R406.2, R409.1, U401.10 (OUT-)
/Channel05/Channel05_INA_Out+: C509.1, R507.2, R508.1, U501.11 (OUT+)
/Channel05/Channel05_INA_Out-: C510.1, R506.2, R509.1, U501.10 (OUT-)
/Channel06/Channel06_INA_Out+: C609.1, R607.2, R608.1, U601.11 (OUT+)
/Channel06/Channel06_INA_Out-: C610.1, R606.2, R609.1, U601.10 (OUT-)
/Channel07/Channel07_INA_Out+: C709.1, R707.2, R708.1, U701.11 (OUT+)
/Channel07/Channel07_INA_Out-: C710.1, R706.2, R709.1, U701.10 (OUT-)
/Channel08/Channel08_INA_Out+: C809.1, R807.2, R808.1, U801.11 (OUT+)
/Channel08/Channel08_INA_Out-: C810.1, R806.2, R809.1, U801.10 (OUT-)
/Channel09/Channel09_INA_Out+: C909.1, R907.2, R908.1, U901.11 (OUT+)
/Channel09/Channel09_INA_Out-: C910.1, R906.2, R909.1, U901.10 (OUT-)
/Channel10/Channel10_INA_Out+: C1009.1, R1007.2, R1008.1, U1001.11 (OUT+)
/Channel10/Channel10_INA_Out-: C1010.1, R1006.2, R1009.1, U1001.10 (OUT-)
/Channel11/Channel11_INA_Out+: C1109.1, R1107.2, R1108.1, U1101.11 (OUT+)
/Channel11/Channel11_INA_Out-: C1110.1, R1106.2, R1109.1, U1101.10 (OUT-)
/Channel12/Channel12_INA_Out+: C1209.1, R1207.2, R1208.1, U1201.11 (OUT+)
/Channel12/Channel12_INA_Out-: C1210.1, R1206.2, R1209.1, U1201.10 (OUT-)
/Channel13/Channel13_INA_Out+: C1309.1, R1307.2, R1308.1, U1301.11 (OUT+)
/Channel13/Channel13_INA_Out-: C1310.1, R1306.2, R1309.1, U1301.10 (OUT-)
/Channel14/Channel14_INA_Out+: C1409.1, R1407.2, R1408.1, U1401.11 (OUT+)
/Channel14/Channel14_INA_Out-: C1410.1, R1406.2, R1409.1, U1401.10 (OUT-)
/Channel15/Channel15_INA_Out+: C1509.1, R1507.2, R1508.1, U1501.11 (OUT+)
/Channel15/Channel15_INA_Out-: C1510.1, R1506.2, R1509.1, U1501.10 (OUT-)
/Channel16/Channel16_INA_Out+: C1609.1, R1607.2, R1608.1, U1601.11 (OUT+)
/Channel16/Channel16_INA_Out-: C1610.1, R1606.2, R1609.1, U1601.10 (OUT-)
/Channel17/Channel17_INA_Out+: C1709.1, R1707.2, R1708.1, U1701.11 (OUT+)
/Channel17/Channel17_INA_Out-: C1710.1, R1706.2, R1709.1, U1701.10 (OUT-)
/Channel18/Channel18_INA_Out+: C1809.1, R1807.2, R1808.1, U1801.11 (OUT+)
/Channel18/Channel18_INA_Out-: C1810.1, R1806.2, R1809.1, U1801.10 (OUT-)
/Channel19/Channel19_INA_Out+: C1909.1, R1907.2, R1908.1, U1901.11 (OUT+)
/Channel19/Channel19_INA_Out-: C1910.1, R1906.2, R1909.1, U1901.10 (OUT-)
/Channel20/Channel20_INA_Out+: C2009.1, R2007.2, R2008.1, U2001.11 (OUT+)
/Channel20/Channel20_INA_Out-: C2010.1, R2006.2, R2009.1, U2001.10 (OUT-)
/Channel21/Channel21_INA_Out+: C2109.1, R2107.2, R2108.1, U2101.11 (OUT+)
/Channel21/Channel21_INA_Out-: C2110.1, R2106.2, R2109.1, U2101.10 (OUT-)
/Channel22/Channel22_INA_Out+: C2209.1, R2207.2, R2208.1, U2201.11 (OUT+)
/Channel22/Channel22_INA_Out-: C2210.1, R2206.2, R2209.1, U2201.10 (OUT-)
/Channel23/Channel23_INA_Out+: C2309.1, R2307.2, R2308.1, U2301.11 (OUT+)
/Channel23/Channel23_INA_Out-: C2310.1, R2306.2, R2309.1, U2301.10 (OUT-)
/Channel24/Channel24_INA_Out+: C2409.1, R2407.2, R2408.1, U2401.11 (OUT+)
/Channel24/Channel24_INA_Out-: C2410.1, R2406.2, R2409.1, U2401.10 (OUT-)
/Channel25/Channel25_INA_Out+: C2509.1, R2507.2, R2508.1, U2501.11 (OUT+)
/Channel25/Channel25_INA_Out-: C2510.1, R2506.2, R2509.1, U2501.10 (OUT-)
/Channel26/Channel26_INA_Out+: C2609.1, R2607.2, R2608.1, U2601.11 (OUT+)
/Channel26/Channel26_INA_Out-: C2610.1, R2606.2, R2609.1, U2601.10 (OUT-)
/Channel27/Channel27_INA_Out+: C2709.1, R2707.2, R2708.1, U2701.11 (OUT+)
/Channel27/Channel27_INA_Out-: C2710.1, R2706.2, R2709.1, U2701.10 (OUT-)
/Channel28/Channel28_INA_Out+: C2809.1, R2807.2, R2808.1, U2801.11 (OUT+)
/Channel28/Channel28_INA_Out-: C2810.1, R2806.2, R2809.1, U2801.10 (OUT-)
/Channel29/Channel29_INA_Out+: C2909.1, R2907.2, R2908.1, U2901.11 (OUT+)
/Channel29/Channel29_INA_Out-: C2910.1, R2906.2, R2909.1, U2901.10 (OUT-)
/Channel30/Channel30_INA_Out+: C3009.1, R3007.2, R3008.1, U3001.11 (OUT+)
/Channel30/Channel30_INA_Out-: C3010.1, R3006.2, R3009.1, U3001.10 (OUT-)
/Channel31/Channel31_INA_Out+: C3109.1, R3107.2, R3108.1, U3101.11 (OUT+)
/Channel31/Channel31_INA_Out-: C3110.1, R3106.2, R3109.1, U3101.10 (OUT-)
/Channel32/Channel32_INA_Out+: C3209.1, R3207.2, R3208.1, U3201.11 (OUT+)
/Channel32/Channel32_INA_Out-: C3210.1, R3206.2, R3209.1, U3201.10 (OUT-)
/Relay_ResetCoil2: K201.7; also elsewhere on the board
/Relay_ResetCoil3: K301.7; also elsewhere on the board
/Relay_ResetCoil4: K401.7; also elsewhere on the board
/Relay_ResetCoil5: K501.7; also elsewhere on the board
/Relay_ResetCoil6: K601.7; also elsewhere on the board
/Relay_ResetCoil7: K701.7; also elsewhere on the board
/Relay_ResetCoil8: K801.7; also elsewhere on the board
/Relay_ResetCoil9: K901.7; also elsewhere on the board
/Relay_ResetCoil10: K1001.7; also elsewhere on the board
/Relay_ResetCoil11: K1101.7; also elsewhere on the board
/Relay_ResetCoil12: K1201.7; also elsewhere on the board
/Relay_ResetCoil13: K1301.7; also elsewhere on the board
/Relay_ResetCoil14: K1401.7; also elsewhere on the board
/Relay_ResetCoil15: K1501.7; also elsewhere on the board
/Relay_ResetCoil16: K1601.7; also elsewhere on the board
/Relay_ResetCoil17: K1701.7; also elsewhere on the board
/Relay_ResetCoil18: K1801.7; also elsewhere on the board
/Relay_ResetCoil19: K1901.7; also elsewhere on the board
/Relay_ResetCoil20: K2001.7; also elsewhere on the board
/Relay_ResetCoil21: K2101.7; also elsewhere on the board
/Relay_ResetCoil22: K2201.7; also elsewhere on the board
/Relay_ResetCoil23: K2301.7; also elsewhere on the board
/Relay_ResetCoil24: K2401.7; also elsewhere on the board
/Relay_ResetCoil25: K2501.7; also elsewhere on the board
/Relay_ResetCoil26: K2601.7; also elsewhere on the board
/Relay_ResetCoil27: K2701.7; also elsewhere on the board
/Relay_ResetCoil28: K2801.7; also elsewhere on the board
/Relay_ResetCoil29: K2901.7; also elsewhere on the board
/Relay_ResetCoil30: K3001.7; also elsewhere on the board
/Relay_ResetCoil31: K3101.7; also elsewhere on the board
/Relay_ResetCoil32: K3201.7; also elsewhere on the board
/Relay_SetCoil2: K201.12; also elsewhere on the board
/Relay_SetCoil3: K301.12; also elsewhere on the board
/Relay_SetCoil4: K401.12; also elsewhere on the board
/Relay_SetCoil5: K501.12; also elsewhere on the board
/Relay_SetCoil6: K601.12; also elsewhere on the board
/Relay_SetCoil7: K701.12; also elsewhere on the board
/Relay_SetCoil8: K801.12; also elsewhere on the board
/Relay_SetCoil9: K901.12; also elsewhere on the board
/Relay_SetCoil10: K1001.12; also elsewhere on the board
/Relay_SetCoil11: K1101.12; also elsewhere on the board
/Relay_SetCoil12: K1201.12; also elsewhere on the board
/Relay_SetCoil13: K1301.12; also elsewhere on the board
/Relay_SetCoil14: K1401.12; also elsewhere on the board
/Relay_SetCoil15: K1501.12; also elsewhere on the board
/Relay_SetCoil16: K1601.12; also elsewhere on the board
/Relay_SetCoil17: K1701.12; also elsewhere on the board
/Relay_SetCoil18: K1801.12; also elsewhere on the board
/Relay_SetCoil19: K1901.12; also elsewhere on the board
/Relay_SetCoil20: K2001.12; also elsewhere on the board
/Relay_SetCoil21: K2101.12; also elsewhere on the board
/Relay_SetCoil22: K2201.12; also elsewhere on the board
/Relay_SetCoil23: K2301.12; also elsewhere on the board
/Relay_SetCoil24: K2401.12; also elsewhere on the board
/Relay_SetCoil25: K2501.12; also elsewhere on the board
/Relay_SetCoil26: K2601.12; also elsewhere on the board
/Relay_SetCoil27: K2701.12; also elsewhere on the board
/Relay_SetCoil28: K2801.12; also elsewhere on the board
/Relay_SetCoil29: K2901.12; also elsewhere on the board
/Relay_SetCoil30: K3001.12; also elsewhere on the board
/Relay_SetCoil31: K3101.12; also elsewhere on the board
/Relay_SetCoil32: K3201.12; also elsewhere on the board
GND: C203.2, C204.1, C206.2, C207.2, C208.2, C211.2, C212.1, C214.2, C303.2, C304.1, C306.2, C307.2, C308.2, C311.2, C312.1, C314.2, C403.2, C404.1, C406.2, C407.2, C408.2, C411.2, C412.1, C414.2, C503.2, C504.1, C506.2, C507.2, C508.2, C511.2, C512.1, C514.2, C603.2, C604.1, C606.2, C607.2, C608.2, C611.2, C612.1, C614.2, C703.2, C704.1, C706.2, C707.2, C708.2, C711.2, C712.1, C714.2, C803.2, C804.1, C806.2, C807.2, C808.2, C811.2, C812.1, C814.2, C903.2, C904.1, C906.2, C907.2, C908.2, C911.2, C912.1, C914.2, C1003.2, C1004.1, C1006.2, C1007.2, C1008.2, C1011.2, C1012.1, C1014.2, C1103.2, C1104.1, C1106.2, C1107.2, C1108.2, C1111.2, C1112.1, C1114.2, C1203.2, C1204.1, C1206.2, C1207.2, C1208.2, C1211.2, C1212.1, C1214.2, C1303.2, C1304.1, C1306.2, C1307.2, C1308.2, C1311.2, C1312.1, C1314.2, C1403.2, C1404.1, C1406.2, C1407.2, C1408.2, C1411.2, C1412.1, C1414.2, C1503.2, C1504.1, C1506.2, C1507.2, C1508.2, C1511.2, C1512.1, C1514.2, C1603.2, C1604.1, C1606.2, C1607.2, C1608.2, C1611.2, C1612.1, C1614.2, C1703.2, C1704.1, C1706.2, C1707.2, C1708.2, C1711.2, C1712.1, C1714.2, C1803.2, C1804.1, C1806.2, C1807.2, C1808.2, C1811.2, C1812.1, C1814.2, C1903.2, C1904.1, C1906.2, C1907.2, C1908.2, C1911.2, C1912.1, C1914.2, C2003.2, C2004.1, C2006.2, C2007.2, C2008.2, C2011.2, C2012.1, C2014.2, C2103.2, C2104.1, C2106.2, C2107.2, C2108.2, C2111.2, C2112.1, C2114.2, C2203.2, C2204.1, C2206.2, C2207.2, C2208.2, C2211.2, C2212.1, C2214.2, C2303.2, C2304.1, C2306.2, C2307.2, C2308.2, C2311.2, C2312.1, C2314.2, C2403.2, C2404.1, C2406.2, C2407.2, C2408.2, C2411.2, C2412.1, C2414.2, C2503.2, C2504.1, C2506.2, C2507.2, C2508.2, C2511.2, C2512.1, C2514.2, C2603.2, C2604.1, C2606.2, C2607.2, C2608.2, C2611.2, C2612.1, C2614.2, C2703.2, C2704.1, C2706.2, C2707.2, C2708.2, C2711.2, C2712.1, C2714.2, C2803.2, C2804.1, C2806.2, C2807.2, C2808.2, C2811.2, C2812.1, C2814.2, C2903.2, C2904.1, C2906.2, C2907.2, C2908.2, C2911.2, C2912.1, C2914.2, C3003.2, C3004.1, C3006.2, C3007.2, C3008.2, C3011.2, C3012.1, C3014.2, C3103.2, C3104.1, C3106.2, C3107.2, C3108.2, C3111.2, C3112.1, C3114.2, C3203.2, C3204.1, C3206.2, C3207.2, C3208.2, C3211.2, C3212.1, C3214.2, R203.1, R204.1, R303.1, R304.1, R403.1, R404.1, R503.1, R504.1, R603.1, R604.1, R703.1, R704.1, R803.1, R804.1, R903.1, R904.1, R1003.1, R1004.1, R1103.1, R1104.1, R1203.1, R1204.1, R1303.1, R1304.1, R1403.1, R1404.1, R1503.1, R1504.1, R1603.1, R1604.1, R1703.1, R1704.1, R1803.1, R1804.1, R1903.1, R1904.1, R2003.1, R2004.1, R2103.1, R2104.1, R2203.1, R2204.1, R2303.1, R2304.1, R2403.1, R2404.1, R2503.1, R2504.1, R2603.1, R2604.1, R2703.1, R2704.1, R2803.1, R2804.1, R2903.1, R2904.1, R3003.1, R3004.1, R3103.1, R3104.1, R3203.1, R3204.1, U201.5 (Vclamp-), U301.5 (Vclamp-), U401.5 (Vclamp-), U501.5 (Vclamp-), U601.5 (Vclamp-), U701.5 (Vclamp-), U801.5 (Vclamp-), U901.5 (Vclamp-), U1001.5 (Vclamp-), U1101.5 (Vclamp-), U1201.5 (Vclamp-), U1301.5 (Vclamp-), U1401.5 (Vclamp-), U1501.5 (Vclamp-), U1601.5 (Vclamp-), U1701.5 (Vclamp-), U1801.5 (Vclamp-), U1901.5 (Vclamp-), U2001.5 (Vclamp-), U2101.5 (Vclamp-), U2201.5 (Vclamp-), U2301.5 (Vclamp-), U2401.5 (Vclamp-), U2501.5 (Vclamp-), U2601.5 (Vclamp-), U2701.5 (Vclamp-), U2801.5 (Vclamp-), U2901.5 (Vclamp-), U3001.5 (Vclamp-), U3101.5 (Vclamp-), U3201.5 (Vclamp-); also elsewhere on the board
unnamed: C201.2, K201.10
unnamed: C202.2, K201.3
unnamed: C301.2, K301.10
unnamed: C302.2, K301.3
unnamed: C401.2, K401.10
unnamed: C402.2, K401.3
unnamed: C501.2, K501.10
unnamed: C502.2, K501.3
unnamed: C601.2, K601.10
unnamed: C602.2, K601.3
unnamed: C701.2, K701.10
unnamed: C702.2, K701.3
unnamed: C801.2, K801.10
unnamed: C802.2, K801.3
unnamed: C901.2, K901.10
unnamed: C902.2, K901.3
unnamed: C1001.2, K1001.10
unnamed: C1002.2, K1001.3
unnamed: C1101.2, K1101.10
unnamed: C1102.2, K1101.3
unnamed: C1201.2, K1201.10
unnamed: C1202.2, K1201.3
unnamed: C1301.2, K1301.10
unnamed: C1302.2, K1301.3
unnamed: C1401.2, K1401.10
unnamed: C1402.2, K1401.3
unnamed: C1501.2, K1501.10
unnamed: C1502.2, K1501.3
unnamed: C1601.2, K1601.10
unnamed: C1602.2, K1601.3
unnamed: C1701.2, K1701.10
unnamed: C1702.2, K1701.3
unnamed: C1801.2, K1801.10
unnamed: C1802.2, K1801.3
unnamed: C1901.2, K1901.10
unnamed: C1902.2, K1901.3
unnamed: C2001.2, K2001.10
unnamed: C2002.2, K2001.3
unnamed: C2101.2, K2101.10
unnamed: C2102.2, K2101.3
unnamed: C2201.2, K2201.10
unnamed: C2202.2, K2201.3
unnamed: C2301.2, K2301.10
unnamed: C2302.2, K2301.3
unnamed: C2401.2, K2401.10
unnamed: C2402.2, K2401.3
unnamed: C2501.2, K2501.10
unnamed: C2502.2, K2501.3
unnamed: C2601.2, K2601.10
unnamed: C2602.2, K2601.3
unnamed: C2701.2, K2701.10
unnamed: C2702.2, K2701.3
unnamed: C2801.2, K2801.10
unnamed: C2802.2, K2801.3
unnamed: C2901.2, K2901.10
unnamed: C2902.2, K2901.3
unnamed: C3001.2, K3001.10
unnamed: C3002.2, K3001.3
unnamed: C3101.2, K3101.10
unnamed: C3102.2, K3101.3
unnamed: C3201.2, K3201.10
unnamed: C3202.2, K3201.3
unnamed: K201.4, R202.1
unnamed: K201.9, R201.1
unnamed: K301.4, R302.1
unnamed: K301.9, R301.1
unnamed: K401.4, R402.1
unnamed: K401.9, R401.1
unnamed: K501.4, R502.1
unnamed: K501.9, R501.1
unnamed: K601.4, R602.1
unnamed: K601.9, R601.1
unnamed: K701.4, R702.1
unnamed: K701.9, R701.1
unnamed: K801.4, R802.1
unnamed: K801.9, R801.1
unnamed: K901.4, R902.1
unnamed: K901.9, R901.1
unnamed: K1001.4, R1002.1
unnamed: K1001.9, R1001.1
unnamed: K1101.4, R1102.1
unnamed: K1101.9, R1101.1
unnamed: K1201.4, R1202.1
unnamed: K1201.9, R1201.1
unnamed: K1301.4, R1302.1
unnamed: K1301.9, R1301.1
unnamed: K1401.4, R1402.1
unnamed: K1401.9, R1401.1
unnamed: K1501.4, R1502.1
unnamed: K1501.9, R1501.1
unnamed: K1601.4, R1602.1
unnamed: K1601.9, R1601.1
unnamed: K1701.4, R1702.1
unnamed: K1701.9, R1701.1
unnamed: K1801.4, R1802.1
unnamed: K1801.9, R1801.1
unnamed: K1901.4, R1902.1
unnamed: K1901.9, R1901.1
unnamed: K2001.4, R2002.1
unnamed: K2001.9, R2001.1
unnamed: K2101.4, R2102.1
unnamed: K2101.9, R2101.1
unnamed: K2201.4, R2202.1
unnamed: K2201.9, R2201.1
unnamed: K2301.4, R2302.1
unnamed: K2301.9, R2301.1
unnamed: K2401.4, R2402.1
unnamed: K2401.9, R2401.1
unnamed: K2501.4, R2502.1
unnamed: K2501.9, R2501.1
unnamed: K2601.4, R2602.1
unnamed: K2601.9, R2601.1
unnamed: K2701.4, R2702.1
unnamed: K2701.9, R2701.1
unnamed: K2801.4, R2802.1
unnamed: K2801.9, R2801.1
unnamed: K2901.4, R2902.1
unnamed: K2901.9, R2901.1
unnamed: K3001.4, R3002.1
unnamed: K3001.9, R3001.1
unnamed: K3101.4, R3102.1
unnamed: K3101.9, R3101.1
unnamed: K3201.4, R3202.1
unnamed: K3201.9, R3201.1
unnamed: C210.2, U201.6 (FDA_IN+)
unnamed: C209.2, U201.15 (FDA_IN-)
unnamed: R207.1, U201.12 (G02+)
unnamed: R206.1, U201.9 (G02-)
unnamed: C203.1, C205.1, R201.2, R203.2, U201.4 (IN+)
unnamed: C204.2, C205.2, R202.2, R204.2, U201.1 (IN-)
unnamed: R205.1, U201.3 (Rg+)
unnamed: R205.2, U201.2 (Rg-)
unnamed: C214.1, L203.2, U201.16 (Vclamp+)
unnamed: C207.1, L202.2, U201.14 (Vs+)
unnamed: C206.1, L201.1, U201.7 (Vs-), U201.17 (Pad)
unnamed: C310.2, U301.6 (FDA_IN+)
unnamed: C309.2, U301.15 (FDA_IN-)
unnamed: R307.1, U301.12 (G02+)
unnamed: R306.1, U301.9 (G02-)
unnamed: C303.1, C305.1, R301.2, R303.2, U301.4 (IN+)
unnamed: C304.2, C305.2, R302.2, R304.2, U301.1 (IN-)
unnamed: R305.1, U301.3 (Rg+)
unnamed: R305.2, U301.2 (Rg-)
unnamed: C314.1, L303.2, U301.16 (Vclamp+)
unnamed: C307.1, L302.2, U301.14 (Vs+)
unnamed: C306.1, L301.1, U301.7 (Vs-), U301.17 (Pad)
unnamed: C410.2, U401.6 (FDA_IN+)
unnamed: C409.2, U401.15 (FDA_IN-)
unnamed: R407.1, U401.12 (G02+)
unnamed: R406.1, U401.9 (G02-)
unnamed: C403.1, C405.1, R401.2, R403.2, U401.4 (IN+)
unnamed: C404.2, C405.2, R402.2, R404.2, U401.1 (IN-)
unnamed: R405.1, U401.3 (Rg+)
unnamed: R405.2, U401.2 (Rg-)
unnamed: C414.1, L403.2, U401.16 (Vclamp+)
unnamed: C407.1, L402.2, U401.14 (Vs+)
unnamed: C406.1, L401.1, U401.7 (Vs-), U401.17 (Pad)
unnamed: C510.2, U501.6 (FDA_IN+)
unnamed: C509.2, U501.15 (FDA_IN-)
unnamed: R507.1, U501.12 (G02+)
unnamed: R506.1, U501.9 (G02-)
unnamed: C503.1, C505.1, R501.2, R503.2, U501.4 (IN+)
unnamed: C504.2, C505.2, R502.2, R504.2, U501.1 (IN-)
unnamed: R505.1, U501.3 (Rg+)
unnamed: R505.2, U501.2 (Rg-)
unnamed: C514.1, L503.2, U501.16 (Vclamp+)
unnamed: C507.1, L502.2, U501.14 (Vs+)
unnamed: C506.1, L501.1, U501.7 (Vs-), U501.17 (Pad)
unnamed: C610.2, U601.6 (FDA_IN+)
unnamed: C609.2, U601.15 (FDA_IN-)
unnamed: R607.1, U601.12 (G02+)
unnamed: R606.1, U601.9 (G02-)
unnamed: C603.1, C605.1, R601.2, R603.2, U601.4 (IN+)
unnamed: C604.2, C605.2, R602.2, R604.2, U601.1 (IN-)
unnamed: R605.1, U601.3 (Rg+)
unnamed: R605.2, U601.2 (Rg-)
unnamed: C614.1, L603.2, U601.16 (Vclamp+)
unnamed: C607.1, L602.2, U601.14 (Vs+)
unnamed: C606.1, L601.1, U601.7 (Vs-), U601.17 (Pad)
unnamed: C710.2, U701.6 (FDA_IN+)
unnamed: C709.2, U701.15 (FDA_IN-)
unnamed: R707.1, U701.12 (G02+)
unnamed: R706.1, U701.9 (G02-)
unnamed: C703.1, C705.1, R701.2, R703.2, U701.4 (IN+)
unnamed: C704.2, C705.2, R702.2, R704.2, U701.1 (IN-)
unnamed: R705.1, U701.3 (Rg+)
unnamed: R705.2, U701.2 (Rg-)
unnamed: C714.1, L703.2, U701.16 (Vclamp+)
unnamed: C707.1, L702.2, U701.14 (Vs+)
unnamed: C706.1, L701.1, U701.7 (Vs-), U701.17 (Pad)
unnamed: C810.2, U801.6 (FDA_IN+)
unnamed: C809.2, U801.15 (FDA_IN-)
unnamed: R807.1, U801.12 (G02+)
unnamed: R806.1, U801.9 (G02-)
unnamed: C803.1, C805.1, R801.2, R803.2, U801.4 (IN+)
unnamed: C804.2, C805.2, R802.2, R804.2, U801.1 (IN-)
unnamed: R805.1, U801.3 (Rg+)
unnamed: R805.2, U801.2 (Rg-)
unnamed: C814.1, L803.2, U801.16 (Vclamp+)
unnamed: C807.1, L802.2, U801.14 (Vs+)
unnamed: C806.1, L801.1, U801.7 (Vs-), U801.17 (Pad)
unnamed: C910.2, U901.6 (FDA_IN+)
unnamed: C909.2, U901.15 (FDA_IN-)
unnamed: R907.1, U901.12 (G02+)
unnamed: R906.1, U901.9 (G02-)
unnamed: C903.1, C905.1, R901.2, R903.2, U901.4 (IN+)
unnamed: C904.2, C905.2, R902.2, R904.2, U901.1 (IN-)
unnamed: R905.1, U901.3 (Rg+)
unnamed: R905.2, U901.2 (Rg-)
unnamed: C914.1, L903.2, U901.16 (Vclamp+)
unnamed: C907.1, L902.2, U901.14 (Vs+)
unnamed: C906.1, L901.1, U901.7 (Vs-), U901.17 (Pad)
unnamed: C1010.2, U1001.6 (FDA_IN+)
unnamed: C1009.2, U1001.15 (FDA_IN-)
unnamed: R1007.1, U1001.12 (G02+)
unnamed: R1006.1, U1001.9 (G02-)
unnamed: C1003.1, C1005.1, R1001.2, R1003.2, U1001.4 (IN+)
unnamed: C1004.2, C1005.2, R1002.2, R1004.2, U1001.1 (IN-)
unnamed: R1005.1, U1001.3 (Rg+)
unnamed: R1005.2, U1001.2 (Rg-)
unnamed: C1014.1, L1003.2, U1001.16 (Vclamp+)
unnamed: C1007.1, L1002.2, U1001.14 (Vs+)
unnamed: C1006.1, L1001.1, U1001.7 (Vs-), U1001.17 (Pad)
unnamed: C1110.2, U1101.6 (FDA_IN+)
unnamed: C1109.2, U1101.15 (FDA_IN-)
unnamed: R1107.1, U1101.12 (G02+)
unnamed: R1106.1, U1101.9 (G02-)
unnamed: C1103.1, C1105.1, R1101.2, R1103.2, U1101.4 (IN+)
unnamed: C1104.2, C1105.2, R1102.2, R1104.2, U1101.1 (IN-)
unnamed: R1105.1, U1101.3 (Rg+)
unnamed: R1105.2, U1101.2 (Rg-)
unnamed: C1114.1, L1103.2, U1101.16 (Vclamp+)
unnamed: C1107.1, L1102.2, U1101.14 (Vs+)
unnamed: C1106.1, L1101.1, U1101.7 (Vs-), U1101.17 (Pad)
unnamed: C1210.2, U1201.6 (FDA_IN+)
unnamed: C1209.2, U1201.15 (FDA_IN-)
unnamed: R1207.1, U1201.12 (G02+)
unnamed: R1206.1, U1201.9 (G02-)
unnamed: C1203.1, C1205.1, R1201.2, R1203.2, U1201.4 (IN+)
unnamed: C1204.2, C1205.2, R1202.2, R1204.2, U1201.1 (IN-)
unnamed: R1205.1, U1201.3 (Rg+)
unnamed: R1205.2, U1201.2 (Rg-)
unnamed: C1214.1, L1203.2, U1201.16 (Vclamp+)
unnamed: C1207.1, L1202.2, U1201.14 (Vs+)
unnamed: C1206.1, L1201.1, U1201.7 (Vs-), U1201.17 (Pad)
unnamed: C1310.2, U1301.6 (FDA_IN+)
unnamed: C1309.2, U1301.15 (FDA_IN-)
unnamed: R1307.1, U1301.12 (G02+)
unnamed: R1306.1, U1301.9 (G02-)
unnamed: C1303.1, C1305.1, R1301.2, R1303.2, U1301.4 (IN+)
unnamed: C1304.2, C1305.2, R1302.2, R1304.2, U1301.1 (IN-)
unnamed: R1305.1, U1301.3 (Rg+)
unnamed: R1305.2, U1301.2 (Rg-)
unnamed: C1314.1, L1303.2, U1301.16 (Vclamp+)
unnamed: C1307.1, L1302.2, U1301.14 (Vs+)
unnamed: C1306.1, L1301.1, U1301.7 (Vs-), U1301.17 (Pad)
unnamed: C1410.2, U1401.6 (FDA_IN+)
unnamed: C1409.2, U1401.15 (FDA_IN-)
unnamed: R1407.1, U1401.12 (G02+)
unnamed: R1406.1, U1401.9 (G02-)
unnamed: C1403.1, C1405.1, R1401.2, R1403.2, U1401.4 (IN+)
unnamed: C1404.2, C1405.2, R1402.2, R1404.2, U1401.1 (IN-)
unnamed: R1405.1, U1401.3 (Rg+)
unnamed: R1405.2, U1401.2 (Rg-)
unnamed: C1414.1, L1403.2, U1401.16 (Vclamp+)
unnamed: C1407.1, L1402.2, U1401.14 (Vs+)
unnamed: C1406.1, L1401.1, U1401.7 (Vs-), U1401.17 (Pad)
unnamed: C1510.2, U1501.6 (FDA_IN+)
unnamed: C1509.2, U1501.15 (FDA_IN-)
unnamed: R1507.1, U1501.12 (G02+)
unnamed: R1506.1, U1501.9 (G02-)
unnamed: C1503.1, C1505.1, R1501.2, R1503.2, U1501.4 (IN+)
unnamed: C1504.2, C1505.2, R1502.2, R1504.2, U1501.1 (IN-)
unnamed: R1505.1, U1501.3 (Rg+)
unnamed: R1505.2, U1501.2 (Rg-)
unnamed: C1514.1, L1503.2, U1501.16 (Vclamp+)
unnamed: C1507.1, L1502.2, U1501.14 (Vs+)
unnamed: C1506.1, L1501.1, U1501.7 (Vs-), U1501.17 (Pad)
unnamed: C1610.2, U1601.6 (FDA_IN+)
unnamed: C1609.2, U1601.15 (FDA_IN-)
unnamed: R1607.1, U1601.12 (G02+)
unnamed: R1606.1, U1601.9 (G02-)
unnamed: C1603.1, C1605.1, R1601.2, R1603.2, U1601.4 (IN+)
unnamed: C1604.2, C1605.2, R1602.2, R1604.2, U1601.1 (IN-)
unnamed: R1605.1, U1601.3 (Rg+)
unnamed: R1605.2, U1601.2 (Rg-)
unnamed: C1614.1, L1603.2, U1601.16 (Vclamp+)
unnamed: C1607.1, L1602.2, U1601.14 (Vs+)
unnamed: C1606.1, L1601.1, U1601.7 (Vs-), U1601.17 (Pad)
unnamed: C1710.2, U1701.6 (FDA_IN+)
unnamed: C1709.2, U1701.15 (FDA_IN-)
unnamed: R1707.1, U1701.12 (G02+)
unnamed: R1706.1, U1701.9 (G02-)
unnamed: C1703.1, C1705.1, R1701.2, R1703.2, U1701.4 (IN+)
unnamed: C1704.2, C1705.2, R1702.2, R1704.2, U1701.1 (IN-)
unnamed: R1705.1, U1701.3 (Rg+)
unnamed: R1705.2, U1701.2 (Rg-)
unnamed: C1714.1, L1703.2, U1701.16 (Vclamp+)
unnamed: C1707.1, L1702.2, U1701.14 (Vs+)
unnamed: C1706.1, L1701.1, U1701.7 (Vs-), U1701.17 (Pad)
unnamed: C1810.2, U1801.6 (FDA_IN+)
unnamed: C1809.2, U1801.15 (FDA_IN-)
unnamed: R1807.1, U1801.12 (G02+)
unnamed: R1806.1, U1801.9 (G02-)
unnamed: C1803.1, C1805.1, R1801.2, R1803.2, U1801.4 (IN+)
unnamed: C1804.2, C1805.2, R1802.2, R1804.2, U1801.1 (IN-)
unnamed: R1805.1, U1801.3 (Rg+)
unnamed: R1805.2, U1801.2 (Rg-)
unnamed: C1814.1, L1803.2, U1801.16 (Vclamp+)
unnamed: C1807.1, L1802.2, U1801.14 (Vs+)
unnamed: C1806.1, L1801.1, U1801.7 (Vs-), U1801.17 (Pad)
unnamed: C1910.2, U1901.6 (FDA_IN+)
unnamed: C1909.2, U1901.15 (FDA_IN-)
unnamed: R1907.1, U1901.12 (G02+)
unnamed: R1906.1, U1901.9 (G02-)
unnamed: C1903.1, C1905.1, R1901.2, R1903.2, U1901.4 (IN+)
unnamed: C1904.2, C1905.2, R1902.2, R1904.2, U1901.1 (IN-)
unnamed: R1905.1, U1901.3 (Rg+)
unnamed: R1905.2, U1901.2 (Rg-)
unnamed: C1914.1, L1903.2, U1901.16 (Vclamp+)
unnamed: C1907.1, L1902.2, U1901.14 (Vs+)
unnamed: C1906.1, L1901.1, U1901.7 (Vs-), U1901.17 (Pad)
unnamed: C2010.2, U2001.6 (FDA_IN+)
unnamed: C2009.2, U2001.15 (FDA_IN-)
unnamed: R2007.1, U2001.12 (G02+)
unnamed: R2006.1, U2001.9 (G02-)
unnamed: C2003.1, C2005.1, R2001.2, R2003.2, U2001.4 (IN+)
unnamed: C2004.2, C2005.2, R2002.2, R2004.2, U2001.1 (IN-)
unnamed: R2005.1, U2001.3 (Rg+)
unnamed: R2005.2, U2001.2 (Rg-)
unnamed: C2014.1, L2003.2, U2001.16 (Vclamp+)
unnamed: C2007.1, L2002.2, U2001.14 (Vs+)
unnamed: C2006.1, L2001.1, U2001.7 (Vs-), U2001.17 (Pad)
unnamed: C2110.2, U2101.6 (FDA_IN+)
unnamed: C2109.2, U2101.15 (FDA_IN-)
unnamed: R2107.1, U2101.12 (G02+)
unnamed: R2106.1, U2101.9 (G02-)
unnamed: C2103.1, C2105.1, R2101.2, R2103.2, U2101.4 (IN+)
unnamed: C2104.2, C2105.2, R2102.2, R2104.2, U2101.1 (IN-)
unnamed: R2105.1, U2101.3 (Rg+)
unnamed: R2105.2, U2101.2 (Rg-)
unnamed: C2114.1, L2103.2, U2101.16 (Vclamp+)
unnamed: C2107.1, L2102.2, U2101.14 (Vs+)
unnamed: C2106.1, L2101.1, U2101.7 (Vs-), U2101.17 (Pad)
unnamed: C2210.2, U2201.6 (FDA_IN+)
unnamed: C2209.2, U2201.15 (FDA_IN-)
unnamed: R2207.1, U2201.12 (G02+)
unnamed: R2206.1, U2201.9 (G02-)
unnamed: C2203.1, C2205.1, R2201.2, R2203.2, U2201.4 (IN+)
unnamed: C2204.2, C2205.2, R2202.2, R2204.2, U2201.1 (IN-)
unnamed: R2205.1, U2201.3 (Rg+)
unnamed: R2205.2, U2201.2 (Rg-)
unnamed: C2214.1, L2203.2, U2201.16 (Vclamp+)
unnamed: C2207.1, L2202.2, U2201.14 (Vs+)
unnamed: C2206.1, L2201.1, U2201.7 (Vs-), U2201.17 (Pad)
unnamed: C2310.2, U2301.6 (FDA_IN+)
unnamed: C2309.2, U2301.15 (FDA_IN-)
unnamed: R2307.1, U2301.12 (G02+)
unnamed: R2306.1, U2301.9 (G02-)
unnamed: C2303.1, C2305.1, R2301.2, R2303.2, U2301.4 (IN+)
unnamed: C2304.2, C2305.2, R2302.2, R2304.2, U2301.1 (IN-)
unnamed: R2305.1, U2301.3 (Rg+)
unnamed: R2305.2, U2301.2 (Rg-)
unnamed: C2314.1, L2303.2, U2301.16 (Vclamp+)
unnamed: C2307.1, L2302.2, U2301.14 (Vs+)
unnamed: C2306.1, L2301.1, U2301.7 (Vs-), U2301.17 (Pad)
unnamed: C2410.2, U2401.6 (FDA_IN+)
unnamed: C2409.2, U2401.15 (FDA_IN-)
unnamed: R2407.1, U2401.12 (G02+)
unnamed: R2406.1, U2401.9 (G02-)
unnamed: C2403.1, C2405.1, R2401.2, R2403.2, U2401.4 (IN+)
unnamed: C2404.2, C2405.2, R2402.2, R2404.2, U2401.1 (IN-)
unnamed: R2405.1, U2401.3 (Rg+)
unnamed: R2405.2, U2401.2 (Rg-)
unnamed: C2414.1, L2403.2, U2401.16 (Vclamp+)
unnamed: C2407.1, L2402.2, U2401.14 (Vs+)
unnamed: C2406.1, L2401.1, U2401.7 (Vs-), U2401.17 (Pad)
unnamed: C2510.2, U2501.6 (FDA_IN+)
unnamed: C2509.2, U2501.15 (FDA_IN-)
unnamed: R2507.1, U2501.12 (G02+)
unnamed: R2506.1, U2501.9 (G02-)
unnamed: C2503.1, C2505.1, R2501.2, R2503.2, U2501.4 (IN+)
unnamed: C2504.2, C2505.2, R2502.2, R2504.2, U2501.1 (IN-)
unnamed: R2505.1, U2501.3 (Rg+)
unnamed: R2505.2, U2501.2 (Rg-)
unnamed: C2514.1, L2503.2, U2501.16 (Vclamp+)
unnamed: C2507.1, L2502.2, U2501.14 (Vs+)
unnamed: C2506.1, L2501.1, U2501.7 (Vs-), U2501.17 (Pad)
unnamed: C2610.2, U2601.6 (FDA_IN+)
unnamed: C2609.2, U2601.15 (FDA_IN-)
unnamed: R2607.1, U2601.12 (G02+)
unnamed: R2606.1, U2601.9 (G02-)
unnamed: C2603.1, C2605.1, R2601.2, R2603.2, U2601.4 (IN+)
unnamed: C2604.2, C2605.2, R2602.2, R2604.2, U2601.1 (IN-)
unnamed: R2605.1, U2601.3 (Rg+)
unnamed: R2605.2, U2601.2 (Rg-)
unnamed: C2614.1, L2603.2, U2601.16 (Vclamp+)
unnamed: C2607.1, L2602.2, U2601.14 (Vs+)
unnamed: C2606.1, L2601.1, U2601.7 (Vs-), U2601.17 (Pad)
unnamed: C2710.2, U2701.6 (FDA_IN+)
unnamed: C2709.2, U2701.15 (FDA_IN-)
unnamed: R2707.1, U2701.12 (G02+)
unnamed: R2706.1, U2701.9 (G02-)
unnamed: C2703.1, C2705.1, R2701.2, R2703.2, U2701.4 (IN+)
unnamed: C2704.2, C2705.2, R2702.2, R2704.2, U2701.1 (IN-)
unnamed: R2705.1, U2701.3 (Rg+)
unnamed: R2705.2, U2701.2 (Rg-)
unnamed: C2714.1, L2703.2, U2701.16 (Vclamp+)
unnamed: C2707.1, L2702.2, U2701.14 (Vs+)
unnamed: C2706.1, L2701.1, U2701.7 (Vs-), U2701.17 (Pad)
unnamed: C2810.2, U2801.6 (FDA_IN+)
unnamed: C2809.2, U2801.15 (FDA_IN-)
unnamed: R2807.1, U2801.12 (G02+)
unnamed: R2806.1, U2801.9 (G02-)
unnamed: C2803.1, C2805.1, R2801.2, R2803.2, U2801.4 (IN+)
unnamed: C2804.2, C2805.2, R2802.2, R2804.2, U2801.1 (IN-)
unnamed: R2805.1, U2801.3 (Rg+)
unnamed: R2805.2, U2801.2 (Rg-)
unnamed: C2814.1, L2803.2, U2801.16 (Vclamp+)
unnamed: C2807.1, L2802.2, U2801.14 (Vs+)
unnamed: C2806.1, L2801.1, U2801.7 (Vs-), U2801.17 (Pad)
unnamed: C2910.2, U2901.6 (FDA_IN+)
unnamed: C2909.2, U2901.15 (FDA_IN-)
unnamed: R2907.1, U2901.12 (G02+)
unnamed: R2906.1, U2901.9 (G02-)
unnamed: C2903.1, C2905.1, R2901.2, R2903.2, U2901.4 (IN+)
unnamed: C2904.2, C2905.2, R2902.2, R2904.2, U2901.1 (IN-)
unnamed: R2905.1, U2901.3 (Rg+)
unnamed: R2905.2, U2901.2 (Rg-)
unnamed: C2914.1, L2903.2, U2901.16 (Vclamp+)
unnamed: C2907.1, L2902.2, U2901.14 (Vs+)
unnamed: C2906.1, L2901.1, U2901.7 (Vs-), U2901.17 (Pad)
unnamed: C3010.2, U3001.6 (FDA_IN+)
unnamed: C3009.2, U3001.15 (FDA_IN-)
unnamed: R3007.1, U3001.12 (G02+)
unnamed: R3006.1, U3001.9 (G02-)
unnamed: C3003.1, C3005.1, R3001.2, R3003.2, U3001.4 (IN+)
unnamed: C3004.2, C3005.2, R3002.2, R3004.2, U3001.1 (IN-)
unnamed: R3005.1, U3001.3 (Rg+)
unnamed: R3005.2, U3001.2 (Rg-)
unnamed: C3014.1, L3003.2, U3001.16 (Vclamp+)
unnamed: C3007.1, L3002.2, U3001.14 (Vs+)
unnamed: C3006.1, L3001.1, U3001.7 (Vs-), U3001.17 (Pad)
unnamed: C3110.2, U3101.6 (FDA_IN+)
unnamed: C3109.2, U3101.15 (FDA_IN-)
unnamed: R3107.1, U3101.12 (G02+)
unnamed: R3106.1, U3101.9 (G02-)
unnamed: C3103.1, C3105.1, R3101.2, R3103.2, U3101.4 (IN+)
unnamed: C3104.2, C3105.2, R3102.2, R3104.2, U3101.1 (IN-)
unnamed: R3105.1, U3101.3 (Rg+)
unnamed: R3105.2, U3101.2 (Rg-)
unnamed: C3114.1, L3103.2, U3101.16 (Vclamp+)
unnamed: C3107.1, L3102.2, U3101.14 (Vs+)
unnamed: C3106.1, L3101.1, U3101.7 (Vs-), U3101.17 (Pad)
unnamed: C3210.2, U3201.6 (FDA_IN+)
unnamed: C3209.2, U3201.15 (FDA_IN-)
unnamed: R3207.1, U3201.12 (G02+)
unnamed: R3206.1, U3201.9 (G02-)
unnamed: C3203.1, C3205.1, R3201.2, R3203.2, U3201.4 (IN+)
unnamed: C3204.2, C3205.2, R3202.2, R3204.2, U3201.1 (IN-)
unnamed: R3205.1, U3201.3 (Rg+)
unnamed: R3205.2, U3201.2 (Rg-)
unnamed: C3214.1, L3203.2, U3201.16 (Vclamp+)
unnamed: C3207.1, L3202.2, U3201.14 (Vs+)
unnamed: C3206.1, L3201.1, U3201.7 (Vs-), U3201.17 (Pad)

Notes on the sheet:
1% 25V
0.1%
