osprey-dcs/Quartz/Quartz.kicad_pcb

## KiCad design Quartz.kicad_pcb (continued)

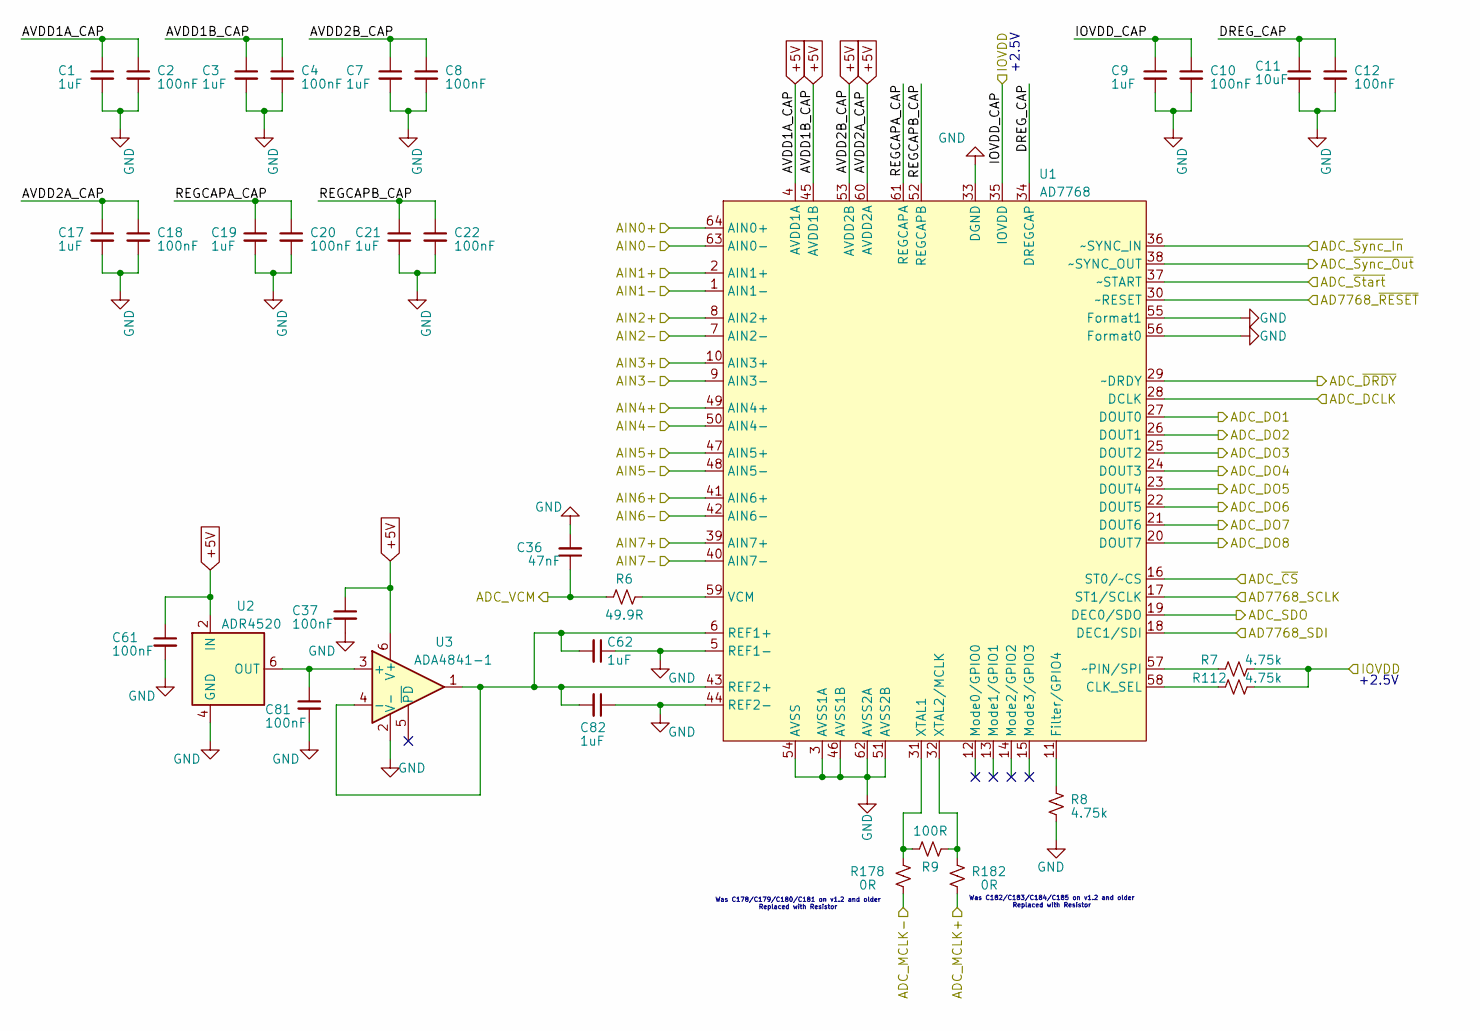
[picture p17: schematic ADC.kicad_sch, Quartz]

Parts:
C1, C3, C7, C9, C17, C19, C21, C62, C82: 1uF; C_0402_1005Metric; MPN CL05X105KP5NNNC
C2, C4, C8, C10, C12, C18, C20, C22, C37, C61, C81: 100nF; C_0402_1005Metric; MPN CL05A104KA5NNNC
C11: 10uF; C_0805_2012Metric; MPN CL21A106KOQNNNE
C36: 47nF; C_0402_1005Metric; MPN CGA2B3X7R1H473K050BB
R6: 49.9R; R_0402_1005Metric; MPN RC0402FR-0749R9L
R7, R8, R112: 4.75k; R_0402_1005Metric; MPN RC0402FR-074K75L
R9: 100R; R_0402_1005Metric; MPN RC0402FR-07100RL
R178, R182: 0R; R_0603_1608Metric; MPN ERJ-2GE0R00X
U1: AD7768; LQFP-64_10x10mm_P0.5mm; MPN AD7768BSTZ
U2: ADR4520; SOIC-8_3.9x4.9mm_P1.27mm; MPN ADR4520BRZ
U3: ADA4841-1; SOT-23-6; MPN ADA4841-1YRJZ-R2

Connections:
+5V: C1.1, C2.1, C3.1, C4.1, C7.1, C8.1, C17.1, C18.1, C37.1, C61.1, U1.4 (AVDD1A), U1.45 (AVDD1B), U1.53 (AVDD2B), U1.60 (AVDD2A), U2.2 (IN), U3.6 (V+); also elsewhere on the board
/ADC1/AIN0+: U1.64 (AIN0+); also elsewhere on the board
/ADC1/AIN0-: U1.63 (AIN0-); also elsewhere on the board
/ADC1/AIN1+: U1.2 (AIN1+); also elsewhere on the board
/ADC1/AIN1-: U1.1 (AIN1-); also elsewhere on the board
/ADC1/AIN2+: U1.8 (AIN2+); also elsewhere on the board
/ADC1/AIN2-: U1.7 (AIN2-); also elsewhere on the board
/ADC1/AIN3+: U1.10 (AIN3+); also elsewhere on the board
/ADC1/AIN3-: U1.9 (AIN3-); also elsewhere on the board
/ADC1/AIN4+: U1.49 (AIN4+); also elsewhere on the board
/ADC1/AIN4-: U1.50 (AIN4-); also elsewhere on the board
/ADC1/AIN5+: U1.47 (AIN5+); also elsewhere on the board
/ADC1/AIN5-: U1.48 (AIN5-); also elsewhere on the board
/ADC1/AIN6+: U1.41 (AIN6+); also elsewhere on the board
/ADC1/AIN6-: U1.42 (AIN6-); also elsewhere on the board
/ADC1/AIN7+: U1.39 (AIN7+); also elsewhere on the board
/ADC1/AIN7-: U1.40 (AIN7-); also elsewhere on the board
/ADC1/DREG_CAP: C11.1, C12.1, U1.34 (DREGCAP)
/ADC1/REGCAPA_CAP: C19.1, C20.1, U1.61 (REGCAPA)
/ADC1/REGCAPB_CAP: C21.1, C22.1, U1.52 (REGCAPB)
/ADC_VCM1: C36.1, R6.1; also elsewhere on the board
AD7768_SCLK: U1.17 (ST1/SCLK); also elsewhere on the board
AD7768_SDI: U1.18 (DEC1/SDI); also elsewhere on the board
AD7768_SYNC: U1.36 (~SYNC_IN), U1.38 (~SYNC_OUT); also elsewhere on the board
AD7768_~RESET: U1.30 (~RESET); also elsewhere on the board
AD7768_~Start: U1.37 (~START); also elsewhere on the board
ADC1_DCLK: U1.28 (DCLK); also elsewhere on the board
ADC1_DO1: U1.27 (DOUT0); also elsewhere on the board
ADC1_DO2: U1.26 (DOUT1); also elsewhere on the board
ADC1_DO3: U1.25 (DOUT2); also elsewhere on the board
ADC1_DO4: U1.24 (DOUT3); also elsewhere on the board
ADC1_DO5: U1.23 (DOUT4); also elsewhere on the board
ADC1_DO6: U1.22 (DOUT5); also elsewhere on the board
ADC1_DO7: U1.21 (DOUT6); also elsewhere on the board
ADC1_DO8: U1.20 (DOUT7); also elsewhere on the board
ADC1_MCLK+: R182.2; also elsewhere on the board
ADC1_MCLK-: R178.2; also elsewhere on the board
ADC1_SDO: U1.19 (DEC0/SDO); also elsewhere on the board
ADC1_~CS: U1.16 (ST0/~CS); also elsewhere on the board
ADC1_~DRDY: U1.29 (~DRDY); also elsewhere on the board
GND: C1.2, C2.2, C3.2, C4.2, C7.2, C8.2, C9.2, C10.2, C11.2, C12.2, C17.2, C18.2, C19.2, C20.2, C21.2, C22.2, C36.2, C37.2, C61.2, C62.1, C81.2, C82.1, R8.2, U1.3 (AVSS1A), U1.5 (REF1-), U1.33 (DGND), U1.44 (REF2-), U1.46 (AVSS1B), U1.51 (AVSS2B), U1.54 (AVSS), U1.55 (Format1), U1.56 (Format0), U1.62 (AVSS2A), U2.4 (GND), U3.2 (V-); also elsewhere on the board
unnamed: R112.2, U1.58 (CLK_SEL)
unnamed: R8.1, U1.11 (Filter/GPIO4)
unnamed: C62.2, C82.2, U1.6 (REF1+), U1.43 (REF2+), U3.1, U3.4 (-)
unnamed: R6.2, U1.59 (VCM)
unnamed: R9.1, R178.1, U1.31 (XTAL1)
unnamed: R9.2, R182.1, U1.32 (XTAL2/MCLK)
unnamed: R7.2, U1.57 (~PIN/SPI)
unnamed: C81.1, U2.6 (OUT), U3.3 (+)
P1_2P5V: C9.1, C10.1, R7.1, R112.1, U1.35 (IOVDD); also elsewhere on the board

Parts of its further copies:
C5, C13, C15, C23, C24, C27, C29, C31, C34, C38, C40, C42, C47, C50, C53, C55, C57, C59, C63, C68, C71, C73, C75, C77, C79, C86, C88: 1uF; C_0402_1005Metric; MPN CL05X105KP5NNNC
C6, C14, C16, C25, C26, C28, C30, C33, C35, C39, C41, C43, C45, C46, C48, C49, C52, C54, C56, C58, C60, C64, C66, C67, C70, C72, C74, C76, C78, C80, C84, C85, C87: 100nF; C_0402_1005Metric; MPN CL05A104KA5NNNC
C32, C51, C69: 10uF; C_0805_2012Metric; MPN CL21A106KOQNNNE
C44, C65, C83: 47nF; C_0402_1005Metric; MPN CGA2B3X7R1H473K050BB
R12, R18, R24: 49.9R; R_0402_1005Metric; MPN RC0402FR-0749R9L
R13, R14, R19, R20, R25, R26, R113, R114, R115: 4.75k; R_0402_1005Metric; MPN RC0402FR-074K75L
R15, R21, R27: 100R; R_0402_1005Metric; MPN RC0402FR-07100RL
R179, R180, R181, R183, R184, R185: 0R; R_0603_1608Metric; MPN ERJ-2GE0R00X
U4, U7, U10: AD7768; LQFP-64_10x10mm_P0.5mm; MPN AD7768BSTZ
U5, U8, U11: ADR4520; SOIC-8_3.9x4.9mm_P1.27mm; MPN ADR4520BRZ
U6, U9, U12: ADA4841-1; SOT-23-6; MPN ADA4841-1YRJZ-R2

Connections of its further copies:
+5V: C5.1, C6.1, C13.1, C14.1, C15.1, C16.1, C23.1, C24.1, C25.1, C26.1, C27.1, C28.1, C31.1, C34.1, C35.1, C38.1, C39.1, C45.1, C46.1, C49.1, C53.1, C54.1, C55.1, C56.1, C66.1, C67.1, C71.1, C72.1, C84.1, C85.1, U4.4 (AVDD1A), U4.45 (AVDD1B), U4.53 (AVDD2B), U4.60 (AVDD2A), U5.2 (IN), U6.6 (V+), U7.4 (AVDD1A), U7.45 (AVDD1B), U7.53 (AVDD2B), U7.60 (AVDD2A), U8.2 (IN), U9.6 (V+), U10.4 (AVDD1A), U10.45 (AVDD1B), U10.53 (AVDD2B), U10.60 (AVDD2A), U11.2 (IN), U12.6 (V+); also elsewhere on the board
/ADC2/ADC_~Start: U4.37 (~START); also elsewhere on the board
/ADC2/ADC_~Sync_Out: U4.38 (~SYNC_OUT)
/ADC2/AIN0+: U4.64 (AIN0+); also elsewhere on the board
/ADC2/AIN0-: U4.63 (AIN0-); also elsewhere on the board
/ADC2/AIN1+: U4.2 (AIN1+); also elsewhere on the board
/ADC2/AIN1-: U4.1 (AIN1-); also elsewhere on the board
/ADC2/AIN2+: U4.8 (AIN2+); also elsewhere on the board
/ADC2/AIN2-: U4.7 (AIN2-); also elsewhere on the board
/ADC2/AIN3+: U4.10 (AIN3+); also elsewhere on the board
/ADC2/AIN3-: U4.9 (AIN3-); also elsewhere on the board
/ADC2/AIN4+: U4.49 (AIN4+); also elsewhere on the board
/ADC2/AIN4-: U4.50 (AIN4-); also elsewhere on the board
/ADC2/AIN5+: U4.47 (AIN5+); also elsewhere on the board
/ADC2/AIN5-: U4.48 (AIN5-); also elsewhere on the board
/ADC2/AIN6+: U4.41 (AIN6+); also elsewhere on the board
/ADC2/AIN6-: U4.42 (AIN6-); also elsewhere on the board
/ADC2/AIN7+: U4.39 (AIN7+); also elsewhere on the board
/ADC2/AIN7-: U4.40 (AIN7-); also elsewhere on the board
/ADC2/DREG_CAP: C32.1, C33.1, U4.34 (DREGCAP)
/ADC2/REGCAPA_CAP: C40.1, C41.1, U4.61 (REGCAPA)
/ADC2/REGCAPB_CAP: C42.1, C43.1, U4.52 (REGCAPB)
/ADC3/ADC_~Start: U7.37 (~START); also elsewhere on the board
/ADC3/ADC_~Sync_Out: U7.38 (~SYNC_OUT)
/ADC3/AIN0+: U7.64 (AIN0+); also elsewhere on the board
/ADC3/AIN0-: U7.63 (AIN0-); also elsewhere on the board
/ADC3/AIN1+: U7.2 (AIN1+); also elsewhere on the board
/ADC3/AIN1-: U7.1 (AIN1-); also elsewhere on the board
/ADC3/AIN2+: U7.8 (AIN2+); also elsewhere on the board
/ADC3/AIN2-: U7.7 (AIN2-); also elsewhere on the board
/ADC3/AIN3+: U7.10 (AIN3+); also elsewhere on the board
/ADC3/AIN3-: U7.9 (AIN3-); also elsewhere on the board
/ADC3/AIN4+: U7.49 (AIN4+); also elsewhere on the board
/ADC3/AIN4-: U7.50 (AIN4-); also elsewhere on the board
/ADC3/AIN5+: U7.47 (AIN5+); also elsewhere on the board
/ADC3/AIN5-: U7.48 (AIN5-); also elsewhere on the board
/ADC3/AIN6+: U7.41 (AIN6+); also elsewhere on the board
/ADC3/AIN6-: U7.42 (AIN6-); also elsewhere on the board
/ADC3/AIN7+: U7.39 (AIN7+); also elsewhere on the board
/ADC3/AIN7-: U7.40 (AIN7-); also elsewhere on the board
/ADC3/DREG_CAP: C51.1, C52.1, U7.34 (DREGCAP)
/ADC3/REGCAPA_CAP: C57.1, C58.1, U7.61 (REGCAPA)
/ADC3/REGCAPB_CAP: C63.1, C64.1, U7.52 (REGCAPB)
/ADC4/ADC_~Start: U10.37 (~START); also elsewhere on the board
/ADC4/ADC_~Sync_Out: U10.38 (~SYNC_OUT)
/ADC4/AIN0+: U10.64 (AIN0+); also elsewhere on the board
/ADC4/AIN0-: U10.63 (AIN0-); also elsewhere on the board
/ADC4/AIN1+: U10.2 (AIN1+); also elsewhere on the board
/ADC4/AIN1-: U10.1 (AIN1-); also elsewhere on the board
/ADC4/AIN2+: U10.8 (AIN2+); also elsewhere on the board
/ADC4/AIN2-: U10.7 (AIN2-); also elsewhere on the board
/ADC4/AIN3+: U10.10 (AIN3+); also elsewhere on the board
/ADC4/AIN3-: U10.9 (AIN3-); also elsewhere on the board
/ADC4/AIN4+: U10.49 (AIN4+); also elsewhere on the board
/ADC4/AIN4-: U10.50 (AIN4-); also elsewhere on the board
/ADC4/AIN5+: U10.47 (AIN5+); also elsewhere on the board
/ADC4/AIN5-: U10.48 (AIN5-); also elsewhere on the board
/ADC4/AIN6+: U10.41 (AIN6+); also elsewhere on the board
/ADC4/AIN6-: U10.42 (AIN6-); also elsewhere on the board
/ADC4/AIN7+: U10.39 (AIN7+); also elsewhere on the board
/ADC4/AIN7-: U10.40 (AIN7-); also elsewhere on the board
/ADC4/DREG_CAP: C69.1, C70.1, U10.34 (DREGCAP)
/ADC4/REGCAPA_CAP: C73.1, C78.1, U10.61 (REGCAPA)
/ADC4/REGCAPB_CAP: C79.1, C80.1, U10.52 (REGCAPB)
/ADC_VCM2: C44.1, R12.1; also elsewhere on the board
/ADC_VCM3: C65.1, R18.1; also elsewhere on the board
/ADC_VCM4: C83.1, R24.1; also elsewhere on the board
AD7768_SCLK: U4.17 (ST1/SCLK), U7.17 (ST1/SCLK), U10.17 (ST1/SCLK); also elsewhere on the board
AD7768_SDI: U4.18 (DEC1/SDI), U7.18 (DEC1/SDI), U10.18 (DEC1/SDI); also elsewhere on the board
AD7768_SYNC: U4.36 (~SYNC_IN), U7.36 (~SYNC_IN), U10.36 (~SYNC_IN); also elsewhere on the board
AD7768_~RESET: U4.30 (~RESET), U7.30 (~RESET), U10.30 (~RESET); also elsewhere on the board
ADC2_DCLK: U4.28 (DCLK); also elsewhere on the board
ADC2_DO1: U4.27 (DOUT0); also elsewhere on the board
ADC2_DO2: U4.26 (DOUT1); also elsewhere on the board
ADC2_DO3: U4.25 (DOUT2); also elsewhere on the board
ADC2_DO4: U4.24 (DOUT3); also elsewhere on the board
ADC2_DO5: U4.23 (DOUT4); also elsewhere on the board
ADC2_DO6: U4.22 (DOUT5); also elsewhere on the board
ADC2_DO7: U4.21 (DOUT6); also elsewhere on the board
ADC2_DO8: U4.20 (DOUT7); also elsewhere on the board
ADC2_MCLK+: R183.2; also elsewhere on the board
ADC2_MCLK-: R179.2; also elsewhere on the board
ADC2_SDO: U4.19 (DEC0/SDO); also elsewhere on the board
ADC2_~CS: U4.16 (ST0/~CS); also elsewhere on the board
ADC2_~DRDY: U4.29 (~DRDY); also elsewhere on the board
ADC3_DCLK: U7.28 (DCLK); also elsewhere on the board
ADC3_DO1: U7.27 (DOUT0); also elsewhere on the board
ADC3_DO2: U7.26 (DOUT1); also elsewhere on the board
ADC3_DO3: U7.25 (DOUT2); also elsewhere on the board
ADC3_DO4: U7.24 (DOUT3); also elsewhere on the board
ADC3_DO5: U7.23 (DOUT4); also elsewhere on the board
ADC3_DO6: U7.22 (DOUT5); also elsewhere on the board
ADC3_DO7: U7.21 (DOUT6); also elsewhere on the board
ADC3_DO8: U7.20 (DOUT7); also elsewhere on the board
ADC3_MCLK+: R184.2; also elsewhere on the board
ADC3_MCLK-: R180.2; also elsewhere on the board
ADC3_SDO: U7.19 (DEC0/SDO); also elsewhere on the board
ADC3_~CS: U7.16 (ST0/~CS); also elsewhere on the board
ADC3_~DRDY: U7.29 (~DRDY); also elsewhere on the board
ADC4_DCLK: U10.28 (DCLK); also elsewhere on the board
ADC4_DO1: U10.27 (DOUT0); also elsewhere on the board
ADC4_DO2: U10.26 (DOUT1); also elsewhere on the board
ADC4_DO3: U10.25 (DOUT2); also elsewhere on the board
ADC4_DO4: U10.24 (DOUT3); also elsewhere on the board
ADC4_DO5: U10.23 (DOUT4); also elsewhere on the board
ADC4_DO6: U10.22 (DOUT5); also elsewhere on the board
ADC4_DO7: U10.21 (DOUT6); also elsewhere on the board
ADC4_DO8: U10.20 (DOUT7); also elsewhere on the board
ADC4_MCLK+: R185.2; also elsewhere on the board
ADC4_MCLK-: R181.2; also elsewhere on the board
ADC4_SDO: U10.19 (DEC0/SDO); also elsewhere on the board
ADC4_~CS: U10.16 (ST0/~CS); also elsewhere on the board
ADC4_~DRDY: U10.29 (~DRDY); also elsewhere on the board
GND: C5.2, C6.2, C13.2, C14.2, C15.2, C16.2, C23.2, C24.2, C25.2, C26.2, C27.2, C28.2, C29.2, C30.2, C31.2, C32.2, C33.2, C34.2, C35.2, C38.2, C39.2, C40.2, C41.2, C42.2, C43.2, C44.2, C45.2, C46.2, C47.2, C48.2, C49.2, C50.1, C51.2, C52.2, C53.2, C54.2, C55.2, C56.2, C57.2, C58.2, C59.2, C60.2, C63.2, C64.2, C65.2, C66.2, C67.2, C68.1, C69.2, C70.2, C71.2, C72.2, C73.2, C74.2, C75.1, C76.2, C77.1, C78.2, C79.2, C80.2, C83.2, C84.2, C85.2, C86.1, C87.2, C88.1, R14.2, R20.2, R26.2, U4.3 (AVSS1A), U4.5 (REF1-), U4.33 (DGND), U4.44 (REF2-), U4.46 (AVSS1B), U4.51 (AVSS2B), U4.54 (AVSS), U4.55 (Format1), U4.56 (Format0), U4.62 (AVSS2A), U5.4 (GND), U6.2 (V-), U7.3 (AVSS1A), U7.5 (REF1-), U7.33 (DGND), U7.44 (REF2-), U7.46 (AVSS1B), U7.51 (AVSS2B), U7.54 (AVSS), U7.55 (Format1), U7.56 (Format0), U7.62 (AVSS2A), U8.4 (GND), U9.2 (V-), U10.3 (AVSS1A), U10.5 (REF1-), U10.33 (DGND), U10.44 (REF2-), U10.46 (AVSS1B), U10.51 (AVSS2B), U10.54 (AVSS), U10.55 (Format1), U10.56 (Format0), U10.62 (AVSS2A), U11.4 (GND), U12.2 (V-); also elsewhere on the board
unnamed: R113.2, U4.58 (CLK_SEL)
unnamed: R14.1, U4.11 (Filter/GPIO4)
unnamed: C50.2, C75.2, U4.6 (REF1+), U4.43 (REF2+), U6.1, U6.4 (-)
unnamed: R12.2, U4.59 (VCM)
unnamed: R15.1, R179.1, U4.31 (XTAL1)
unnamed: R15.2, R183.1, U4.32 (XTAL2/MCLK)
unnamed: R13.2, U4.57 (~PIN/SPI)
unnamed: C74.1, U5.6 (OUT), U6.3 (+)
unnamed: R114.2, U7.58 (CLK_SEL)
unnamed: R20.1, U7.11 (Filter/GPIO4)
unnamed: C68.2, C77.2, U7.6 (REF1+), U7.43 (REF2+), U9.1, U9.4 (-)
unnamed: R18.2, U7.59 (VCM)
unnamed: R21.1, R180.1, U7.31 (XTAL1)
unnamed: R21.2, R184.1, U7.32 (XTAL2/MCLK)
unnamed: R19.2, U7.57 (~PIN/SPI)
unnamed: C76.1, U8.6 (OUT), U9.3 (+)
unnamed: R115.2, U10.58 (CLK_SEL)
unnamed: R26.1, U10.11 (Filter/GPIO4)
unnamed: C86.2, C88.2, U10.6 (REF1+), U10.43 (REF2+), U12.1, U12.4 (-)
unnamed: R24.2, U10.59 (VCM)
unnamed: R27.1, R181.1, U10.31 (XTAL1)
unnamed: R27.2, R185.1, U10.32 (XTAL2/MCLK)
unnamed: R25.2, U10.57 (~PIN/SPI)
unnamed: C87.1, U11.6 (OUT), U12.3 (+)
P1_2P5V: C29.1, C30.1, R13.1, R113.1, U4.35 (IOVDD); also elsewhere on the board
P2_2P5V: C47.1, C48.1, C59.1, C60.1, R19.1, R25.1, R114.1, R115.1, U7.35 (IOVDD), U10.35 (IOVDD); also elsewhere on the board

Notes on the sheet:
+2.5V
Was C178/C179/C180/C181 on v1.2 and older Replaced with Resistor
Was C182/C183/C184/C185 on v1.2 and older Replaced with Resistor

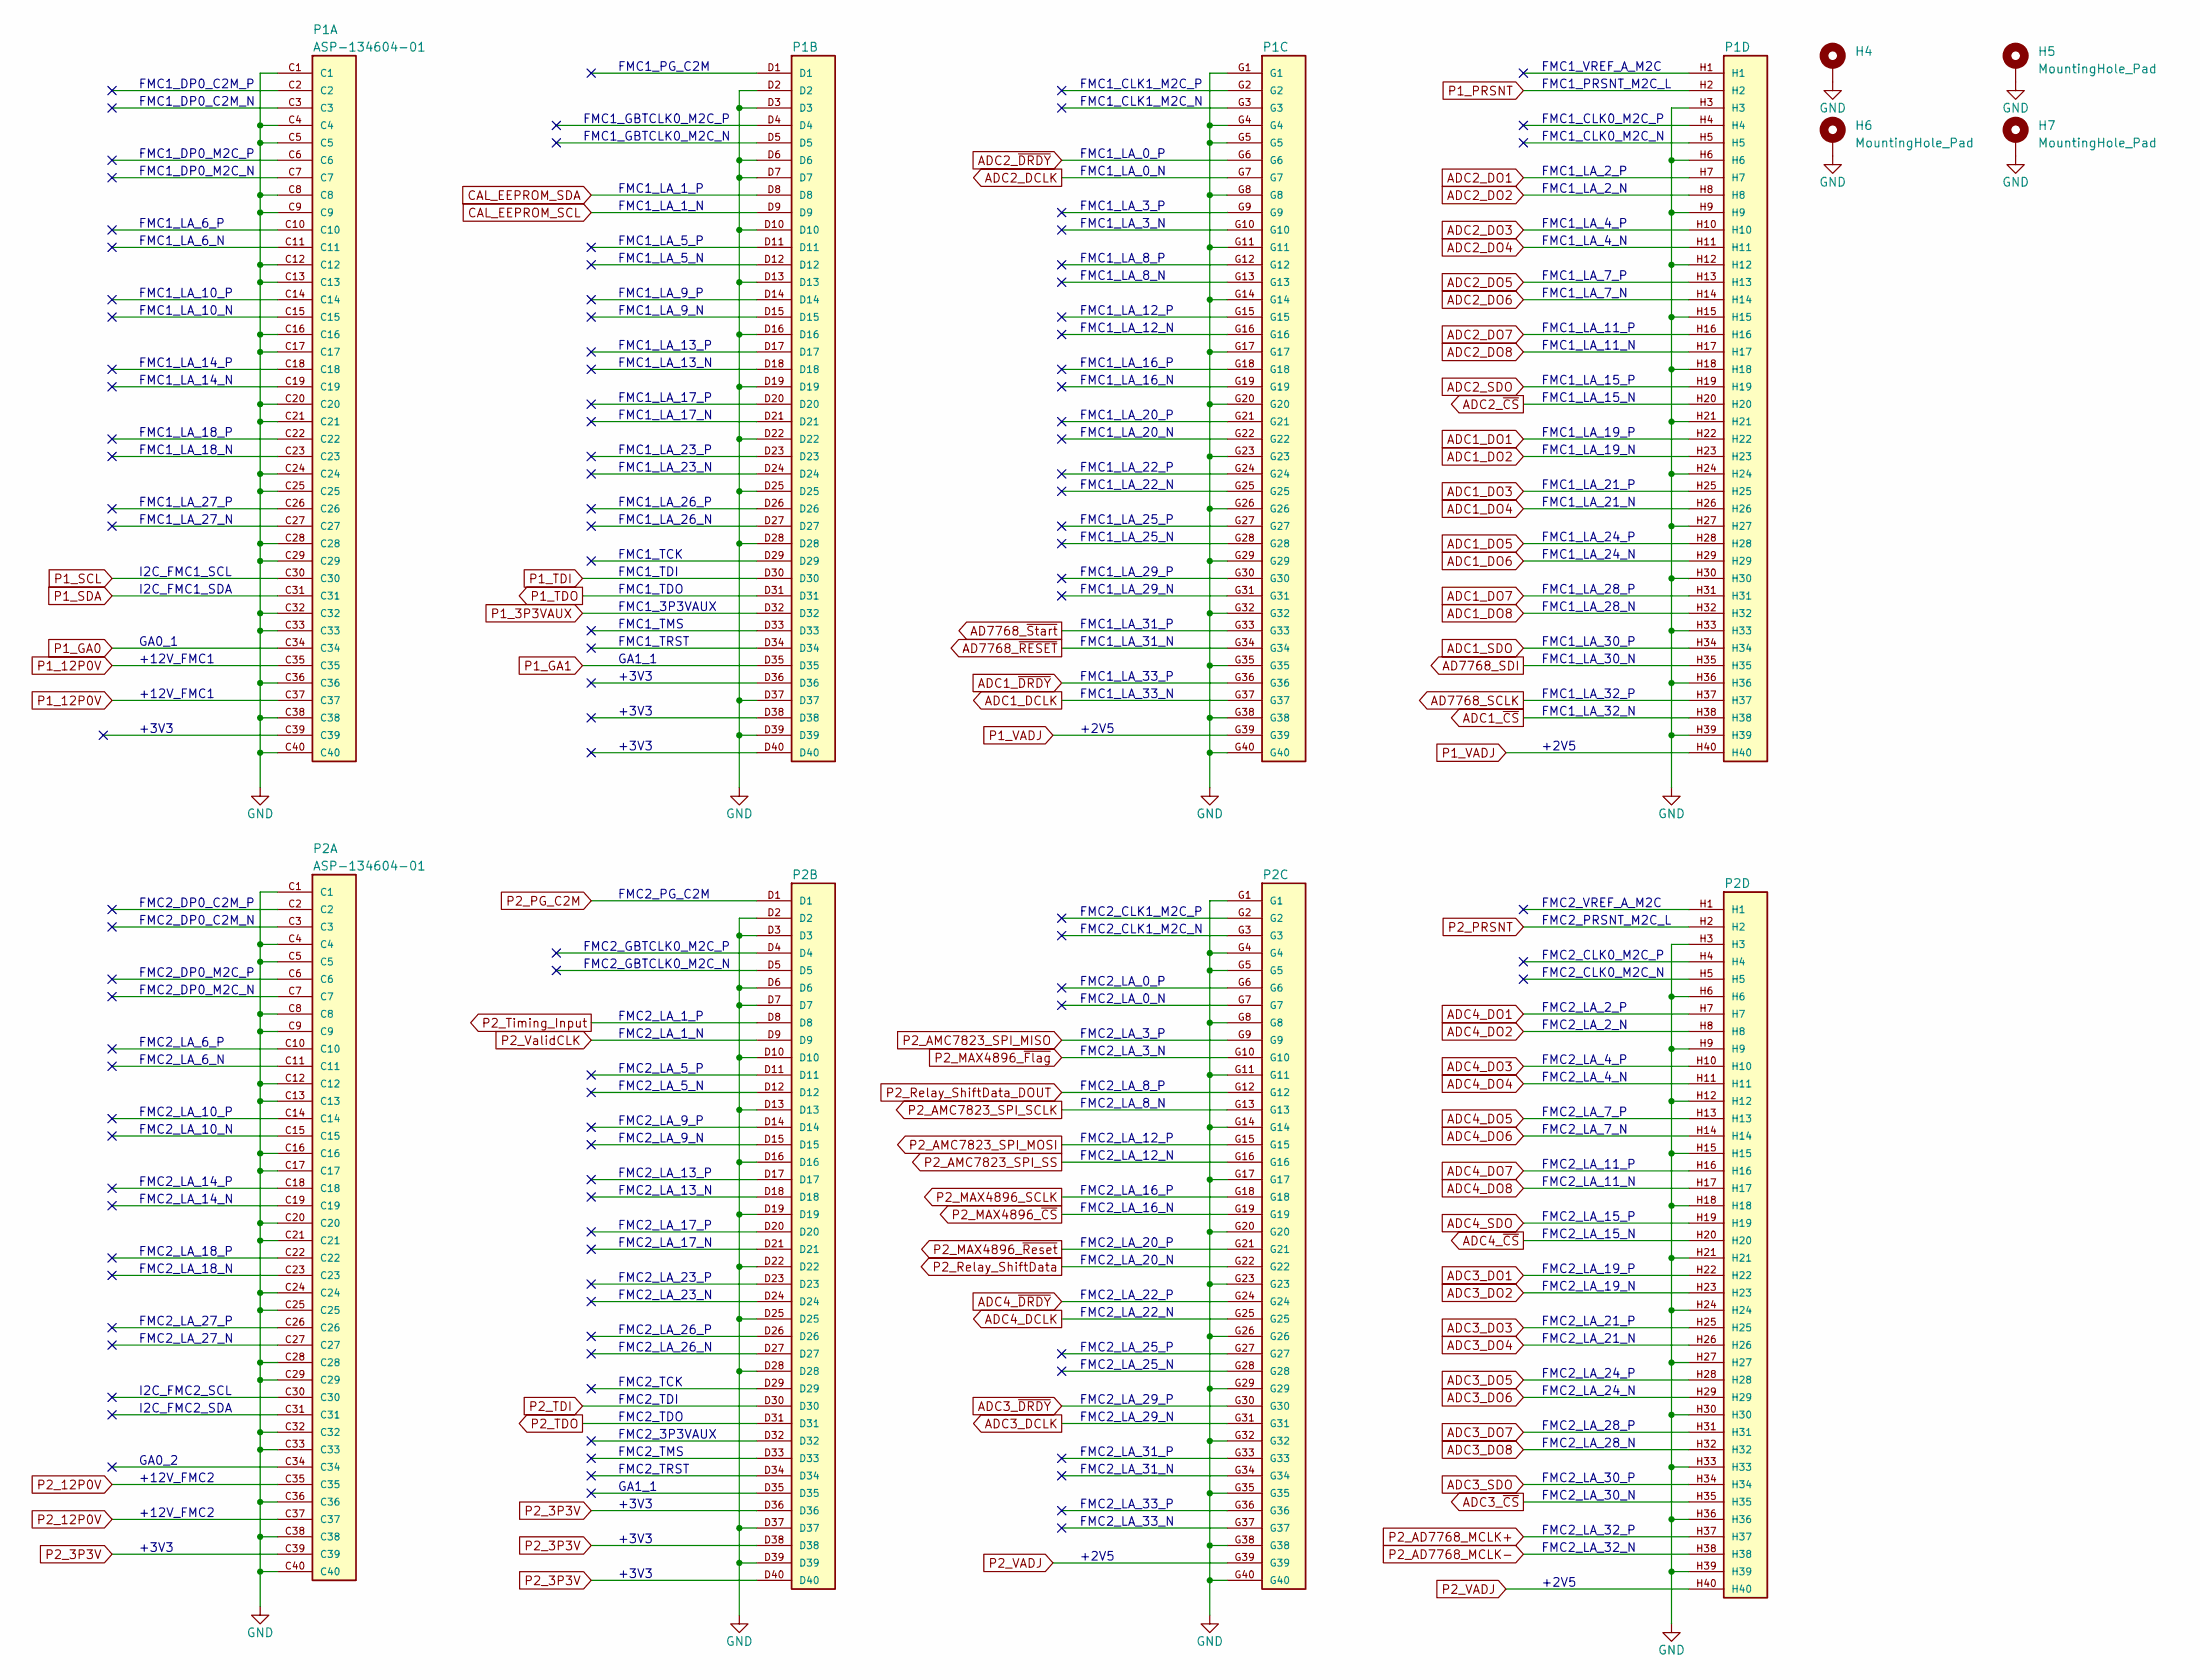
[picture p18: schematic FMC.kicad_sch, Quartz]

Parts:
H4, H5, H6, H7: MountingHole_Pad; Mounting Hole 3mm hole 5mm ring
P1, P2: ASP-134604-01; SAMTEC_ASP-134604-01; MPN ASP-134604-01

Connections:
AD7768_SCLK: P1.H37; also elsewhere on the board
AD7768_SDI: P1.H35; also elsewhere on the board
AD7768_~RESET: P1.G34; also elsewhere on the board
AD7768_~Start: P1.G33; also elsewhere on the board
ADC1_DCLK: P1.G37; also elsewhere on the board
ADC1_DO1: P1.H22; also elsewhere on the board
ADC1_DO2: P1.H23; also elsewhere on the board
ADC1_DO3: P1.H25; also elsewhere on the board
ADC1_DO4: P1.H26; also elsewhere on the board
ADC1_DO5: P1.H28; also elsewhere on the board
ADC1_DO6: P1.H29; also elsewhere on the board
ADC1_DO7: P1.H31; also elsewhere on the board
ADC1_DO8: P1.H32; also elsewhere on the board
ADC1_SDO: P1.H34; also elsewhere on the board
ADC1_~CS: P1.H38; also elsewhere on the board
ADC1_~DRDY: P1.G36; also elsewhere on the board
ADC2_DCLK: P1.G7; also elsewhere on the board
ADC2_DO1: P1.H7; also elsewhere on the board
ADC2_DO2: P1.H8; also elsewhere on the board
ADC2_DO3: P1.H10; also elsewhere on the board
ADC2_DO4: P1.H11; also elsewhere on the board
ADC2_DO5: P1.H13; also elsewhere on the board
ADC2_DO6: P1.H14; also elsewhere on the board
ADC2_DO7: P1.H16; also elsewhere on the board
ADC2_DO8: P1.H17; also elsewhere on the board
ADC2_SDO: P1.H19; also elsewhere on the board
ADC2_~CS: P1.H20; also elsewhere on the board
ADC2_~DRDY: P1.G6; also elsewhere on the board
ADC3_DCLK: P2.G31; also elsewhere on the board
ADC3_DO1: P2.H22; also elsewhere on the board
ADC3_DO2: P2.H23; also elsewhere on the board
ADC3_DO3: P2.H25; also elsewhere on the board
ADC3_DO4: P2.H26; also elsewhere on the board
ADC3_DO5: P2.H28; also elsewhere on the board
ADC3_DO6: P2.H29; also elsewhere on the board
ADC3_DO7: P2.H31; also elsewhere on the board
ADC3_DO8: P2.H32; also elsewhere on the board
ADC3_SDO: P2.H34; also elsewhere on the board
ADC3_~CS: P2.H35; also elsewhere on the board
ADC3_~DRDY: P2.G30; also elsewhere on the board
ADC4_DCLK: P2.G25; also elsewhere on the board
ADC4_DO1: P2.H7; also elsewhere on the board
ADC4_DO2: P2.H8; also elsewhere on the board
ADC4_DO3: P2.H10; also elsewhere on the board
ADC4_DO4: P2.H11; also elsewhere on the board
ADC4_DO5: P2.H13; also elsewhere on the board
ADC4_DO6: P2.H14; also elsewhere on the board
ADC4_DO7: P2.H16; also elsewhere on the board
ADC4_DO8: P2.H17; also elsewhere on the board
ADC4_SDO: P2.H19; also elsewhere on the board
ADC4_~CS: P2.H20; also elsewhere on the board
ADC4_~DRDY: P2.G24; also elsewhere on the board
CAL_EEPROM_SCL: P1.D9; also elsewhere on the board
CAL_EEPROM_SDA: P1.D8; also elsewhere on the board
GND: H4.1, H5.1, H6.1, H7.1, P1.C1, P1.C4, P1.C5, P1.C8, P1.C9, P1.C12, P1.C13, P1.C16, P1.C17, P1.C20, P1.C21, P1.C24, P1.C25, P1.C28, P1.C29, P1.C32, P1.C33, P1.C36, P1.C38, P1.C40, P1.D2, P1.D3, P1.D6, P1.D7, P1.D10, P1.D13, P1.D16, P1.D19, P1.D22, P1.D25, P1.D28, P1.D37, P1.D39, P1.G1, P1.G4, P1.G5, P1.G8, P1.G11, P1.G14, P1.G17, P1.G20, P1.G23, P1.G26, P1.G29, P1.G32, P1.G35, P1.G38, P1.G40, P1.H3, P1.H6, P1.H9, P1.H12, P1.H15, P1.H18, P1.H21, P1.H24, P1.H27, P1.H30, P1.H33, P1.H36, P1.H39, P2.C1, P2.C4, P2.C5, P2.C8, P2.C9, P2.C12, P2.C13, P2.C16, P2.C17, P2.C20, P2.C21, P2.C24, P2.C25, P2.C28, P2.C29, P2.C32, P2.C33, P2.C36, P2.C38, P2.C40, P2.D2, P2.D3, P2.D6, P2.D7, P2.D10, P2.D13, P2.D16, P2.D19, P2.D22, P2.D25, P2.D28, P2.D37, P2.D39, P2.G1, P2.G4, P2.G5, P2.G8, P2.G11, P2.G14, P2.G17, P2.G20, P2.G23, P2.G26, P2.G29, P2.G32, P2.G35, P2.G38, P2.G40, P2.H3, P2.H6, P2.H9, P2.H12, P2.H15, P2.H18, P2.H21, P2.H24, P2.H27, P2.H30, P2.H33, P2.H36, P2.H39; also elsewhere on the board
P1_3P3VAUX: P1.D32; also elsewhere on the board
P1_12P0V: P1.C35, P1.C37; also elsewhere on the board
P1_GA0: P1.C34; also elsewhere on the board
P1_GA1: P1.D35; also elsewhere on the board
P1_PRSNT: P1.H2; also elsewhere on the board
P1_SCL: P1.C30; also elsewhere on the board
P1_SDA: P1.C31; also elsewhere on the board
P1_TDI: P1.D30; also elsewhere on the board
P1_TDO: P1.D31; also elsewhere on the board
P1_VADJ: P1.G39, P1.H40; also elsewhere on the board
P2_3P3V: P2.C39, P2.D36, P2.D38, P2.D40; also elsewhere on the board
P2_12P0V: P2.C35, P2.C37; also elsewhere on the board
P2_AD7768_MCLK+: P2.H37; also elsewhere on the board
P2_AD7768_MCLK-: P2.H38; also elsewhere on the board
P2_AMC7823_SPI_MISO: P2.G9; also elsewhere on the board
P2_AMC7823_SPI_MOSI: P2.G15; also elsewhere on the board
P2_AMC7823_SPI_SCLK: P2.G13; also elsewhere on the board
P2_AMC7823_SPI_SS: P2.G16; also elsewhere on the board
P2_MAX4896_SCLK: P2.G18; also elsewhere on the board
P2_MAX4896_~CS: P2.G19; also elsewhere on the board
P2_MAX4896_~Flag: P2.G10; also elsewhere on the board
P2_MAX4896_~Reset: P2.G21; also elsewhere on the board
P2_PG_C2M: P2.D1; also elsewhere on the board
P2_PRSNT: P2.H2; also elsewhere on the board
P2_Relay_ShiftData: P2.G22; also elsewhere on the board
P2_Relay_ShiftData_DOUT: P2.G12; also elsewhere on the board
P2_TDI: P2.D30; also elsewhere on the board
P2_TDO: P2.D31; also elsewhere on the board
P2_Timing_Input: P2.D8; also elsewhere on the board
P2_VADJ: P2.G39, P2.H40; also elsewhere on the board
P2_ValidCLK: P2.D9; also elsewhere on the board

Notes on the sheet:
FMC1_DP0_C2M_N
FMC1_TDO
FMC2_LA_16_P
FMC2_LA_4_N
FMC2_DP0_M2C_P
FMC1_LA_25_P
FMC2_LA_19_N
FMC1_LA_20_P
FMC2_LA_30_P
FMC1_LA_26_N
FMC1_LA_12_P
FMC1_LA_29_N
FMC1_LA_5_P
FMC1_LA_24_P
FMC1_LA_33_N
FMC2_VREF_A_M2C
FMC2_LA_20_P
FMC1_LA_22_N
FMC2_DP0_M2C_N
FMC1_LA_1_P
+2V5
FMC2_LA_15_P
FMC2_LA_25_P
FMC2_LA_18_N
FMC2_LA_17_P
GA0_1
FMC2_LA_19_P
FMC1_LA_11_N
FMC2_LA_5_P
FMC2_LA_29_N
FMC1_LA_0_P
FMC2_LA_31_N
FMC2_LA_23_P
FMC1_LA_16_N
FMC2_LA_10_P
FMC1_LA_3_N
FMC2_LA_26_P
FMC1_LA_26_P
+3V3
FMC2_LA_14_P
FMC1_LA_22_P
FMC2_DP0_C2M_P
FMC1_LA_12_N
FMC1_LA_7_P
FMC1_LA_30_N
FMC2_LA_28_N
FMC1_LA_6_N
FMC2_LA_31_P
I2C_FMC1_SCL
FMC1_LA_23_N
FMC2_PRSNT_M2C_L
FMC1_LA_0_N
FMC1_GBTCLK0_M2C_P
FMC2_LA_3_P
FMC1_LA_32_P
FMC2_LA_23_N
FMC2_LA_11_N
FMC2_LA_18_P
FMC2_TDI
I2C_FMC1_SDA
FMC1_LA_10_N
FMC2_LA_22_N
FMC1_LA_5_N
FMC1_TMS
FMC1_LA_23_P
FMC2_GBTCLK0_M2C_N
FMC1_LA_15_N
FMC2_LA_9_N
+3V3
FMC1_TRST
FMC1_LA_27_P
FMC1_VREF_A_M2C
FMC1_LA_18_N
+12V_FMC1
+12V_FMC2
FMC2_DP0_C2M_N
FMC2_3P3VAUX
FMC2_LA_2_P
FMC2_LA_0_N
I2C_FMC2_SCL
FMC1_LA_16_P
FMC2_LA_30_N
FMC2_LA_20_N
FMC2_LA_26_N
FMC1_LA_10_P
FMC2_LA_8_N
FMC2_GBTCLK0_M2C_P
FMC1_LA_9_N
FMC1_LA_21_P
FMC1_LA_31_P
FMC1_3P3VAUX
FMC1_LA_8_N
FMC1_LA_2_N
FMC1_LA_4_P
FMC2_LA_9_P
FMC1_LA_31_N
FMC1_PG_C2M
FMC2_LA_25_N
FMC2_TRST
FMC2_LA_7_N
FMC2_LA_22_P
FMC2_TMS
FMC2_LA_24_P
FMC2_LA_4_P
FMC1_LA_29_P
FMC1_LA_6_P
FMC1_LA_9_P
FMC1_LA_19_P
FMC1_LA_14_N
FMC1_CLK0_M2C_N
FMC1_LA_8_P
FMC2_LA_12_N
FMC2_LA_13_N
FMC1_TCK
FMC1_LA_24_N
FMC2_LA_21_N
FMC2_LA_5_N
FMC2_LA_29_P
FMC1_CLK1_M2C_P
FMC1_LA_20_N
FMC2_PG_C2M
FMC1_LA_30_P
FMC1_LA_18_P
FMC1_LA_17_P
FMC1_CLK0_M2C_P
FMC2_LA_33_N
FMC2_LA_27_P
FMC1_DP0_M2C_N
FMC1_LA_3_P
FMC2_LA_16_N
FMC1_LA_17_N
FMC1_LA_11_P
FMC2_LA_27_N
FMC2_LA_33_P
FMC2_LA_21_P
FMC2_LA_13_P
FMC2_LA_3_N
FMC2_TCK
GA1_1
FMC1_DP0_M2C_P
FMC1_LA_21_N
FMC1_LA_28_P
FMC2_LA_10_N
FMC1_LA_1_N
FMC1_PRSNT_M2C_L
FMC1_GBTCLK0_M2C_N
FMC1_LA_28_N
FMC1_LA_19_N
FMC2_LA_1_N
FMC2_CLK0_M2C_P
FMC2_LA_6_P
FMC1_LA_7_N
FMC2_LA_32_N
FMC2_LA_1_P
FMC1_LA_2_P
FMC2_CLK0_M2C_N
FMC1_LA_4_N
FMC1_TDI
FMC2_TDO
FMC2_LA_15_N
FMC2_LA_12_P
FMC1_LA_13_P
FMC1_LA_33_P
FMC1_LA_32_N
FMC1_LA_13_N
FMC2_LA_11_P
FMC2_LA_32_P
FMC2_LA_6_N
FMC2_LA_8_P
FMC2_LA_7_P
FMC2_LA_14_N
FMC2_LA_17_N
FMC2_LA_0_P
FMC1_LA_27_N
FMC1_LA_15_P
FMC1_LA_14_P
FMC1_LA_25_N
FMC2_LA_28_P
GA0_2
FMC1_DP0_C2M_P
FMC1_CLK1_M2C_N
FMC2_CLK1_M2C_P
FMC2_CLK1_M2C_N
I2C_FMC2_SDA
FMC2_LA_24_N
FMC2_LA_2_N
