osprey-dcs/Quartz/Quartz.kicad_pcb

## KiCad design Quartz.kicad_pcb (continued)

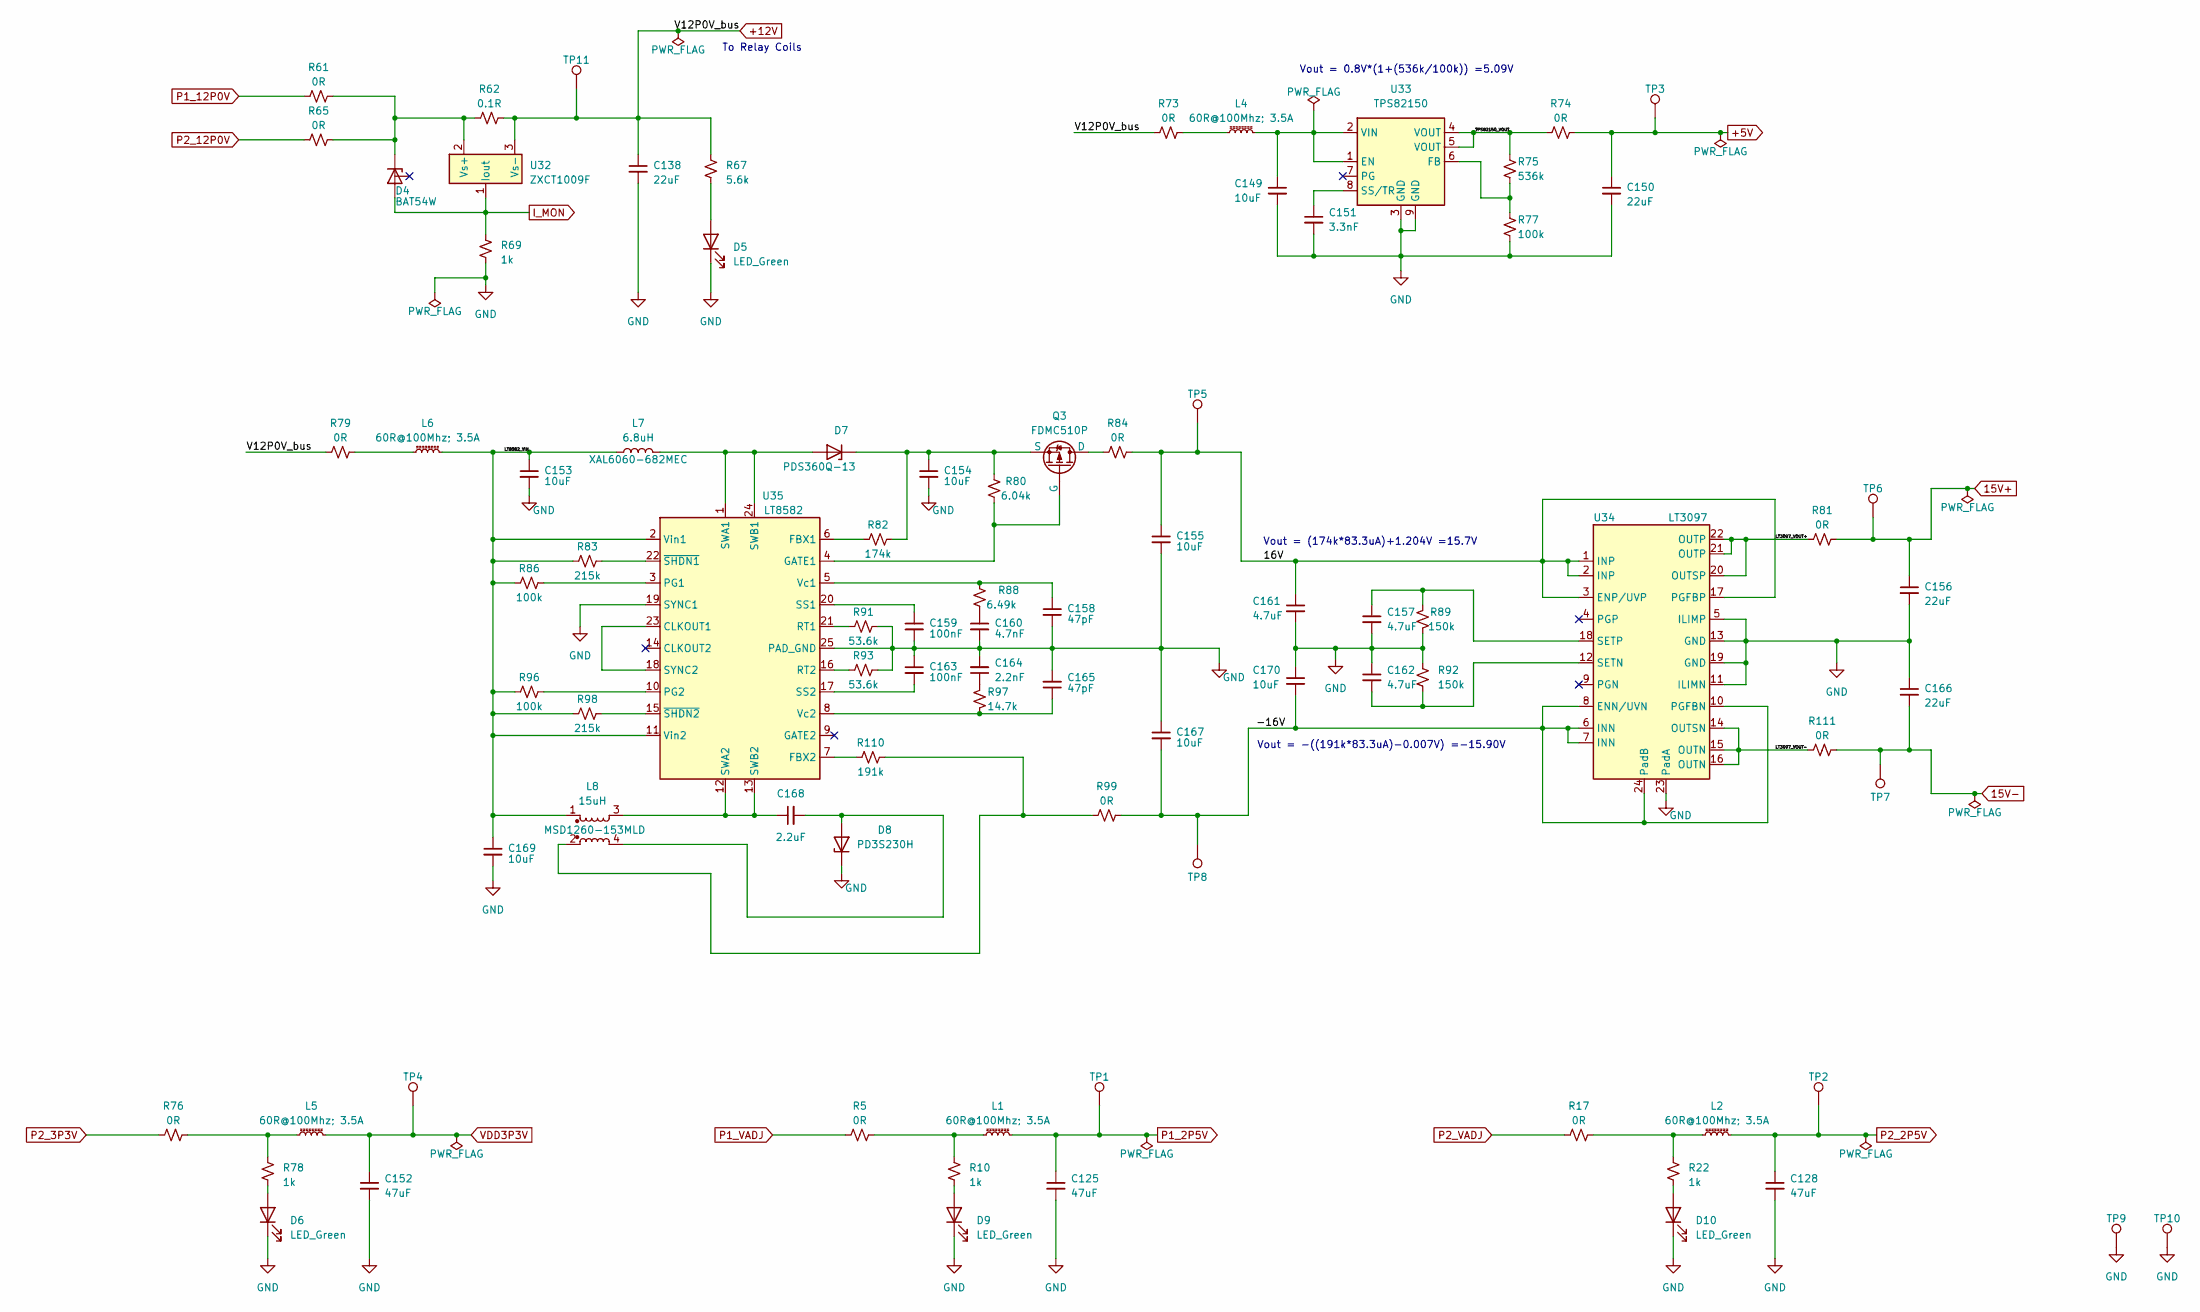
[picture p19: schematic Power.kicad_sch, Quartz]

Parts:
C125, C128, C152: 47uF; C_0805_2012Metric; MPN C2012X5R1A476M125AC
C138, C150, C156, C166: 22uF; C_0805_2012Metric; MPN GRT21BR61E226ME13L
C149, C153, C154, C155, C167, C169, C170: 10uF; C_0805_2012Metric; MPN GRM21BR61E106KA73L
C151: 3.3nF; C_0603_1608Metric; MPN GRM1885C1H332JA01D
C157, C161, C162: 4.7uF; C_0805_2012Metric; MPN TMK212AB7475KG-T
C158, C165: 47pF; C_0603_1608Metric; MPN GRM1885C1H470JA01D
C159, C163: 100nF; C_0402_1005Metric; MPN CL05A104KA5NNNC
C160: 4.7nF; C_0603_1608Metric; MPN CGA3E2C0G1H472J080AA
C164: 2.2nF; C_0603_1608Metric; MPN GCM1885C1H222JA16D
C168: 2.2uF; C_0805_2012Metric; MPN GRM21BR71E225KE11L
D4: BAT54W; SOT-323_SC-70; MPN BAT54W-7-F
D5, D6, D9, D10: LED_Green; LED_0603_1608Metric; MPN APT1608CGCK
D7: PDS360Q-13; D_PowerDI-5; MPN PDS360Q-13
D8: PD3S230H; D_SOD-323_HandSoldering; MPN PD3S230H-7
L1, L2, L4, L5, L6: 60R@100Mhz; 3.5A; L_0805_2012Metric; MPN BLM21PG600SN1D
L7: 6.8uH; IND_7345-WE-PD_WRE; MPN XAL6060-682MEC
L8: 15uH; MSD1260153MLD; MPN MSD1260-153MLD
Q3: FDMC510P; MLP8_3P3X3P3_ONS-M; MPN FDMC510P
R5, R17, R73, R74, R76, R79, R81, R84, R99, R111: 0R; R_0603_1608Metric; MPN ERJ-3GEY0R00V
R10, R22, R78: 1k; R_0603_1608Metric; MPN RC0603FR-071KL
R61, R65: 0R; R_0805_2012Metric; MPN ERJ-6GEY0R00V
R62: 0.1R; R_1206_3216Metric; MPN ERJ-8BWFR100V
R67: 5.6k; R_0603_1608Metric; MPN RC0603FR-075K6L
R69: 1k; R_0805_2012Metric; MPN RC0805FR-071KL
R75: 536k; R_0603_1608Metric; MPN RC0603FR-07536KL
R77: 100k; R_0603_1608Metric; MPN RC0603FR-07100KL
R80: 6.04k; R_0603_1608Metric; MPN RC0603FR-076K04L
R82: 174k; R_0603_1608Metric; MPN RC0603FR-07174KL
R83, R98: 215k; R_0402_1005Metric; MPN RC0402FR-07215KL
R86, R96: 100k; R_0402_1005Metric; MPN RC0402FR-07100KL
R88: 6.49k; R_0603_1608Metric; MPN RC0603FR-076K49L
R89, R92: 150k; R_0603_1608Metric; MPN RC0603FR-07150KL
R91, R93: 53.6k; R_0402_1005Metric; MPN RC0402FR-0753K6L
R97: 14.7k; R_0603_1608Metric; MPN RC0603FR-0714K7L
R110: 191k; R_0603_1608Metric; MPN RC0603FR-07191KL
TP1, TP2, TP3, TP4, TP5, TP6, TP7, TP8, TP11: TestPoint_Loop_D1.80mm_Drill1.0mm_Beaded; MPN 5000
TP9, TP10: TestPoint_Loop_D1.80mm_Drill1.0mm_Beaded; MPN 5001
U32: ZXCT1009F; SOT-23-PinRotate; MPN ZXCT1009FTA
U33: TPS82150; SIL0008D_SMD; MPN TPS82150SILR
U34: LT3097; 05-08-7071_ADI-M; MPN LT3097ADJC#PBF
U35: LT8582; DFN-24-1EP_4x7mm_P0.5mm_EP2.64x6.44mm; MPN LT8582EDKD#TRPBF

Connections:
15V+: C156.1, R81.2, TP6.1; also elsewhere on the board
15V-: C166.2, R111.2, TP7.1; also elsewhere on the board
+5V: C150.1, R74.2, TP3.1; also elsewhere on the board
+12V: C138.1, R62.2, R67.2, R73.1, R79.1, TP11.1, U32.3 (Vs-); also elsewhere on the board
/Power/16V: C155.1, C161.1, R84.2, TP5.1, U34.1 (INP), U34.2 (INP), U34.3 (ENP/UVP), U34.17 (PGFBP)
/Power/-16V: C167.2, C170.2, R99.2, TP8.1, U34.6 (INN), U34.7 (INN), U34.8 (ENN/UVN), U34.10 (PGFBN), U34.24 (PadB)
/Power/LT3097_VOUT+: R81.1, U34.20 (OUTSP), U34.21 (OUTP), U34.22 (OUTP)
/Power/LT3097_VOUT-: R111.1, U34.14 (OUTSN), U34.15 (OUTN), U34.16 (OUTN)
/Power/LT8582_VIN: C153.1, C169.1, L6.2, L7.1, L8.1, R83.1, R86.1, R96.1, R98.1, U35.2 (Vin1), U35.11 (Vin2)
/Power/TPS82150_VOUT: R74.1, R75.1, U33.4 (VOUT), U33.5 (VOUT)
GND: C125.2, C128.2, C138.2, C149.2, C150.2, C151.2, C152.2, C153.2, C154.2, C155.2, C156.2, C157.2, C158.2, C159.2, C160.2, C161.2, C162.1, C163.1, C164.2, C165.2, C166.1, C167.1, C169.2, C170.1, D5.1 (K), D6.1 (K), D8.1 (K), D9.1 (K), D10.1 (K), R69.2, R77.2, R89.2, R91.1, R92.1, R93.1, TP9.1, TP10.1, U33.3 (GND), U33.9 (GND), U34.5 (ILIMP), U34.11 (ILIMN), U34.13 (GND), U34.19 (GND), U34.23 (PadA), U35.19 (SYNC1), U35.25 (PAD_GND); also elsewhere on the board
I_MON: D4.1 (A), R69.1, U32.1 (Iout); also elsewhere on the board
unnamed: C160.1, R88.1
unnamed: C164.1, R97.1
unnamed: D4.3 (K), R61.2, R62.1, R65.2, U32.2 (Vs+)
unnamed: D5.2 (A), R67.1
unnamed: D6.2 (A), R78.1
unnamed: D7.2 (A), L7.2, U35.1 (SWA1), U35.24 (SWB1)
unnamed: C154.1, D7.1 (K), Q3.3 (S), R80.2, R82.2
unnamed: C168.2, D8.2 (A), L8.4
unnamed: D9.2 (A), R10.1
unnamed: D10.2 (A), R22.1
unnamed: L1.1, R5.2, R10.2
unnamed: L2.1, R17.2, R22.2
unnamed: L4.1, R73.2
unnamed: L5.1, R76.2, R78.2
unnamed: L6.1, R79.2
unnamed: L8.2, R99.1, R110.2
unnamed: Q3.1 (D), R84.1
unnamed: Q3.2 (G), R80.1, U35.4 (GATE1)
unnamed: C149.1, L4.2, U33.1 (EN), U33.2 (VIN)
unnamed: R75.2, R77.1, U33.6 (FB)
unnamed: C151.1, U33.8 (SS/TR)
unnamed: C162.2, R92.2, U34.12 (SETN)
unnamed: C157.1, R89.1, U34.18 (SETP)
unnamed: U35.18 (SYNC2), U35.23 (CLKOUT1)
unnamed: R82.1, U35.6 (FBX1)
unnamed: R110.1, U35.7 (FBX2)
unnamed: R86.2, U35.3 (PG1)
unnamed: R96.2, U35.10 (PG2)
unnamed: R91.2, U35.21 (RT1)
unnamed: R93.2, U35.16 (RT2)
unnamed: C159.1, U35.20 (SS1)
unnamed: C163.2, U35.17 (SS2)
unnamed: C168.1, L8.3, U35.12 (SWA2), U35.13 (SWB2)
unnamed: C158.1, R88.2, U35.5 (Vc1)
unnamed: C165.1, R97.2, U35.8 (Vc2)
unnamed: R83.2, U35.22 (~SHDN1)
unnamed: R98.2, U35.15 (~SHDN2)
P1_2P5V: C125.1, L1.2, TP1.1; also elsewhere on the board
P1_12P0V: R61.1; also elsewhere on the board
P1_VADJ: R5.1; also elsewhere on the board
P2_2P5V: C128.1, L2.2, TP2.1; also elsewhere on the board
P2_3P3V: R76.1; also elsewhere on the board
P2_12P0V: R65.1; also elsewhere on the board
P2_VADJ: R17.1; also elsewhere on the board
VDD3P3V: C152.1, L5.2, TP4.1; also elsewhere on the board

Notes on the sheet:
Vout = -((191k*83.3uA)-0.007V) =-15.90V
Vout = 0.8V*(1+(536k/100k)) =5.09V
Vout = (174k*83.3uA)+1.204V =15.7V
To Relay Coils

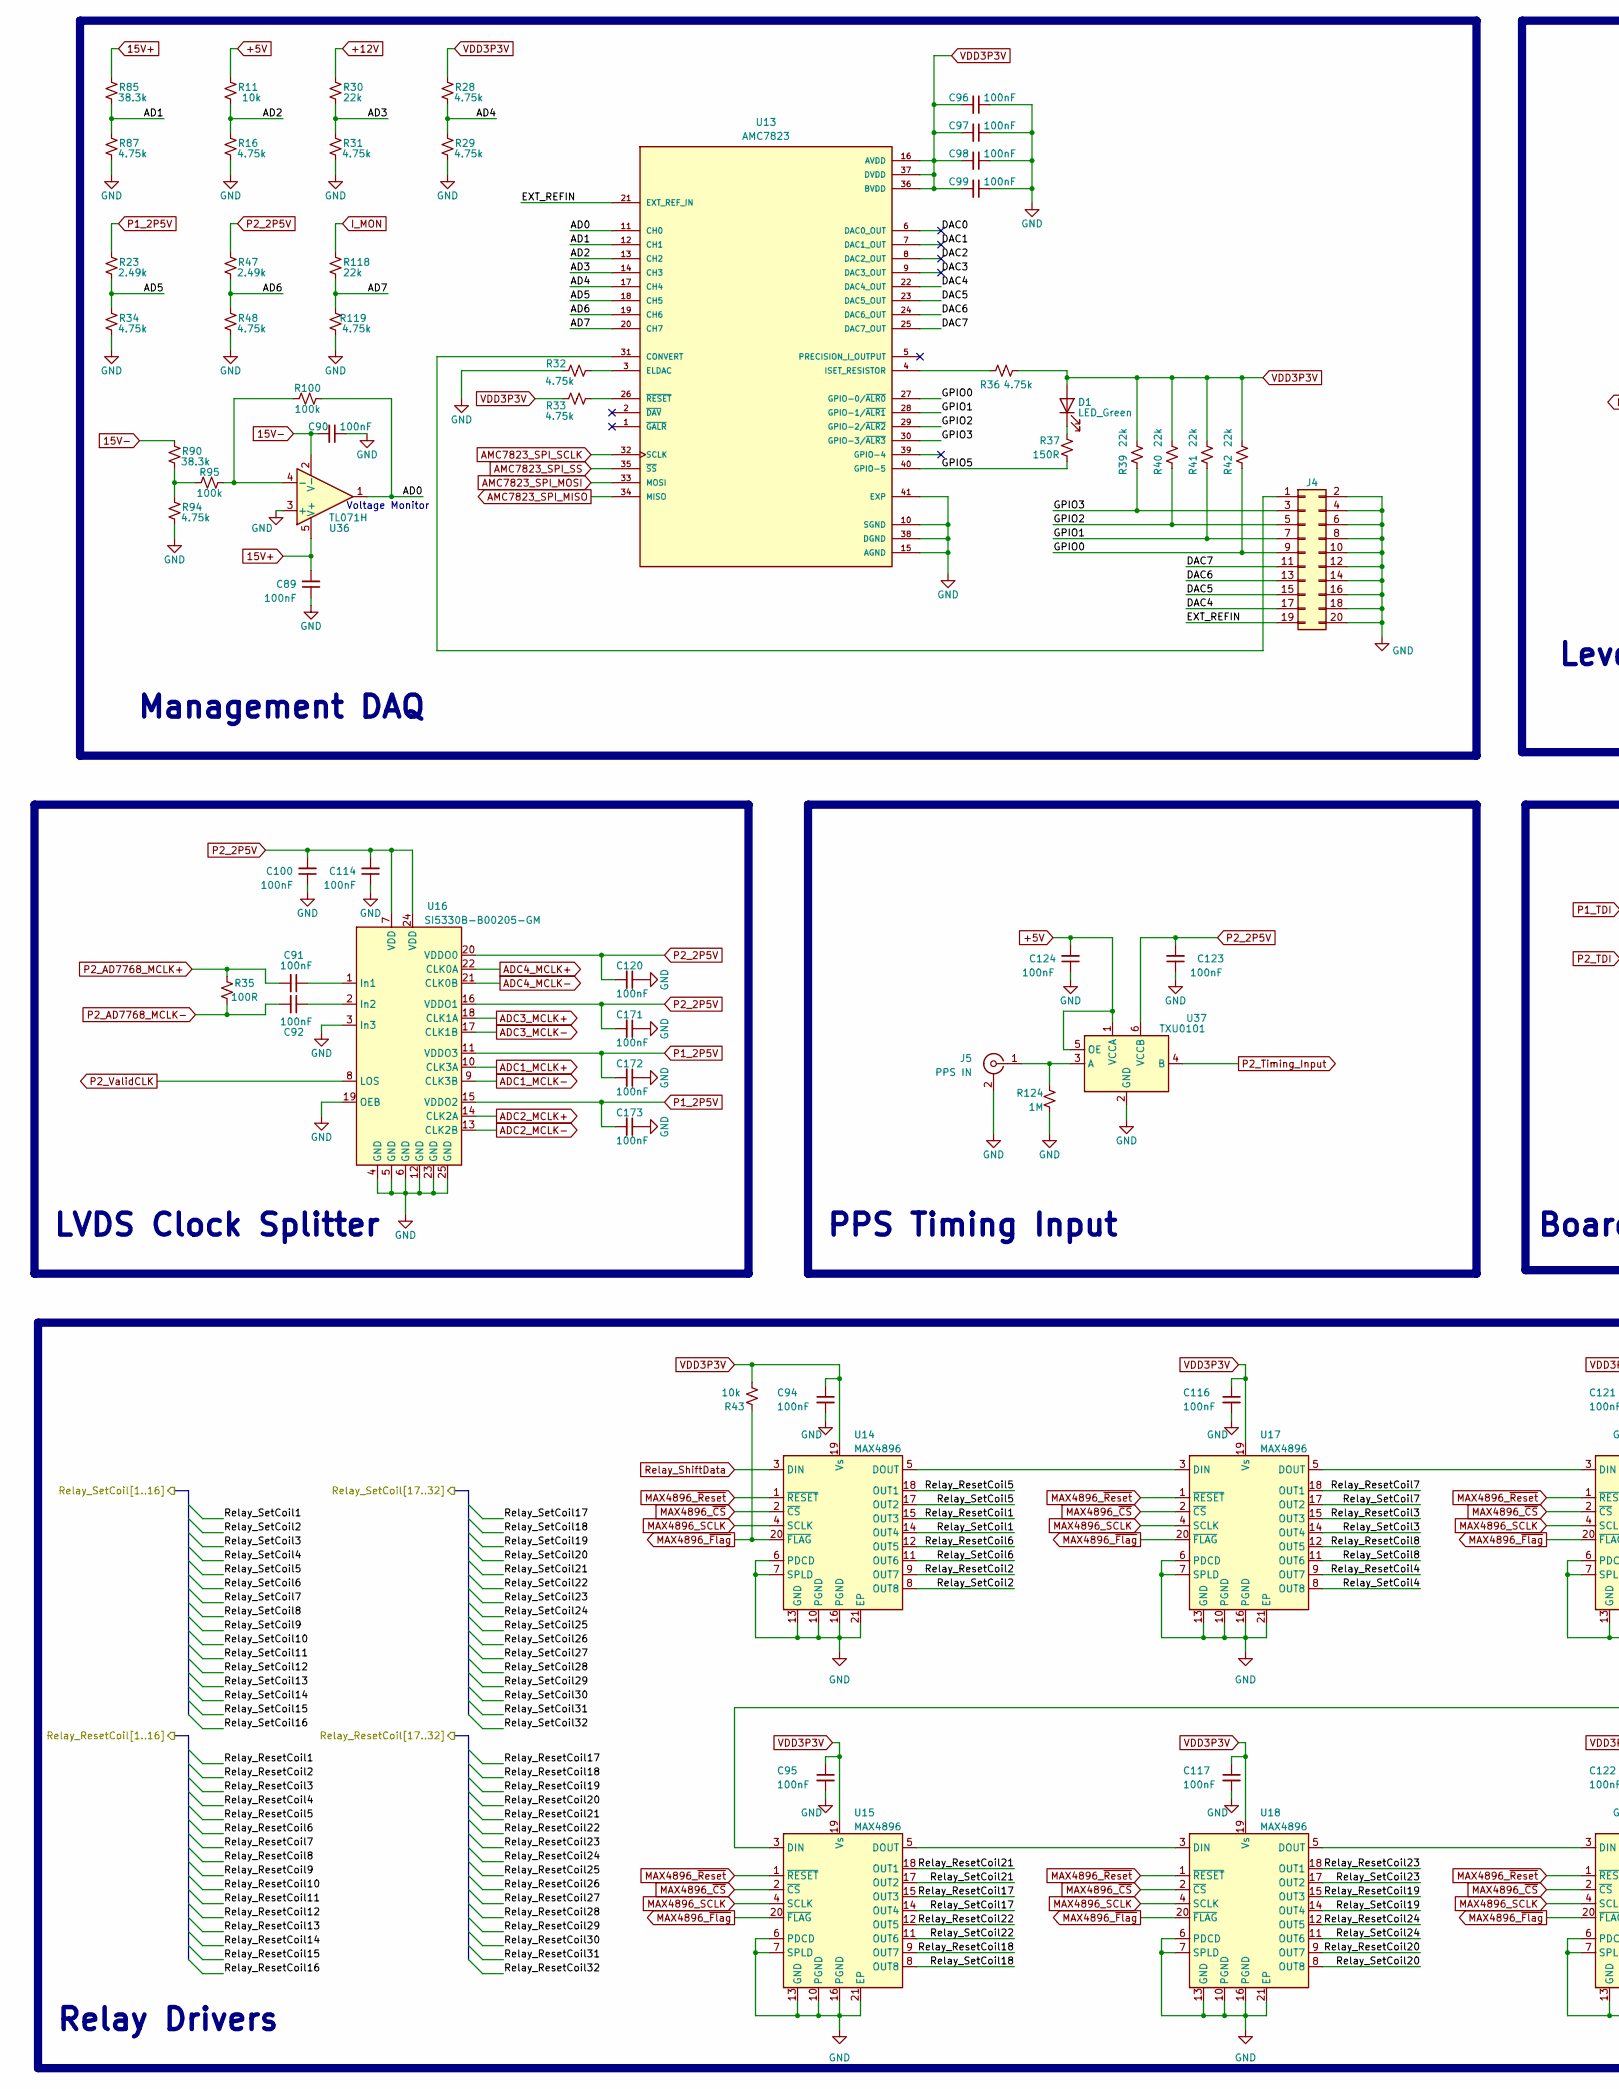
[picture p20: schematic Housekeeping.kicad_sch, Quartz, part in row 1, column 1]

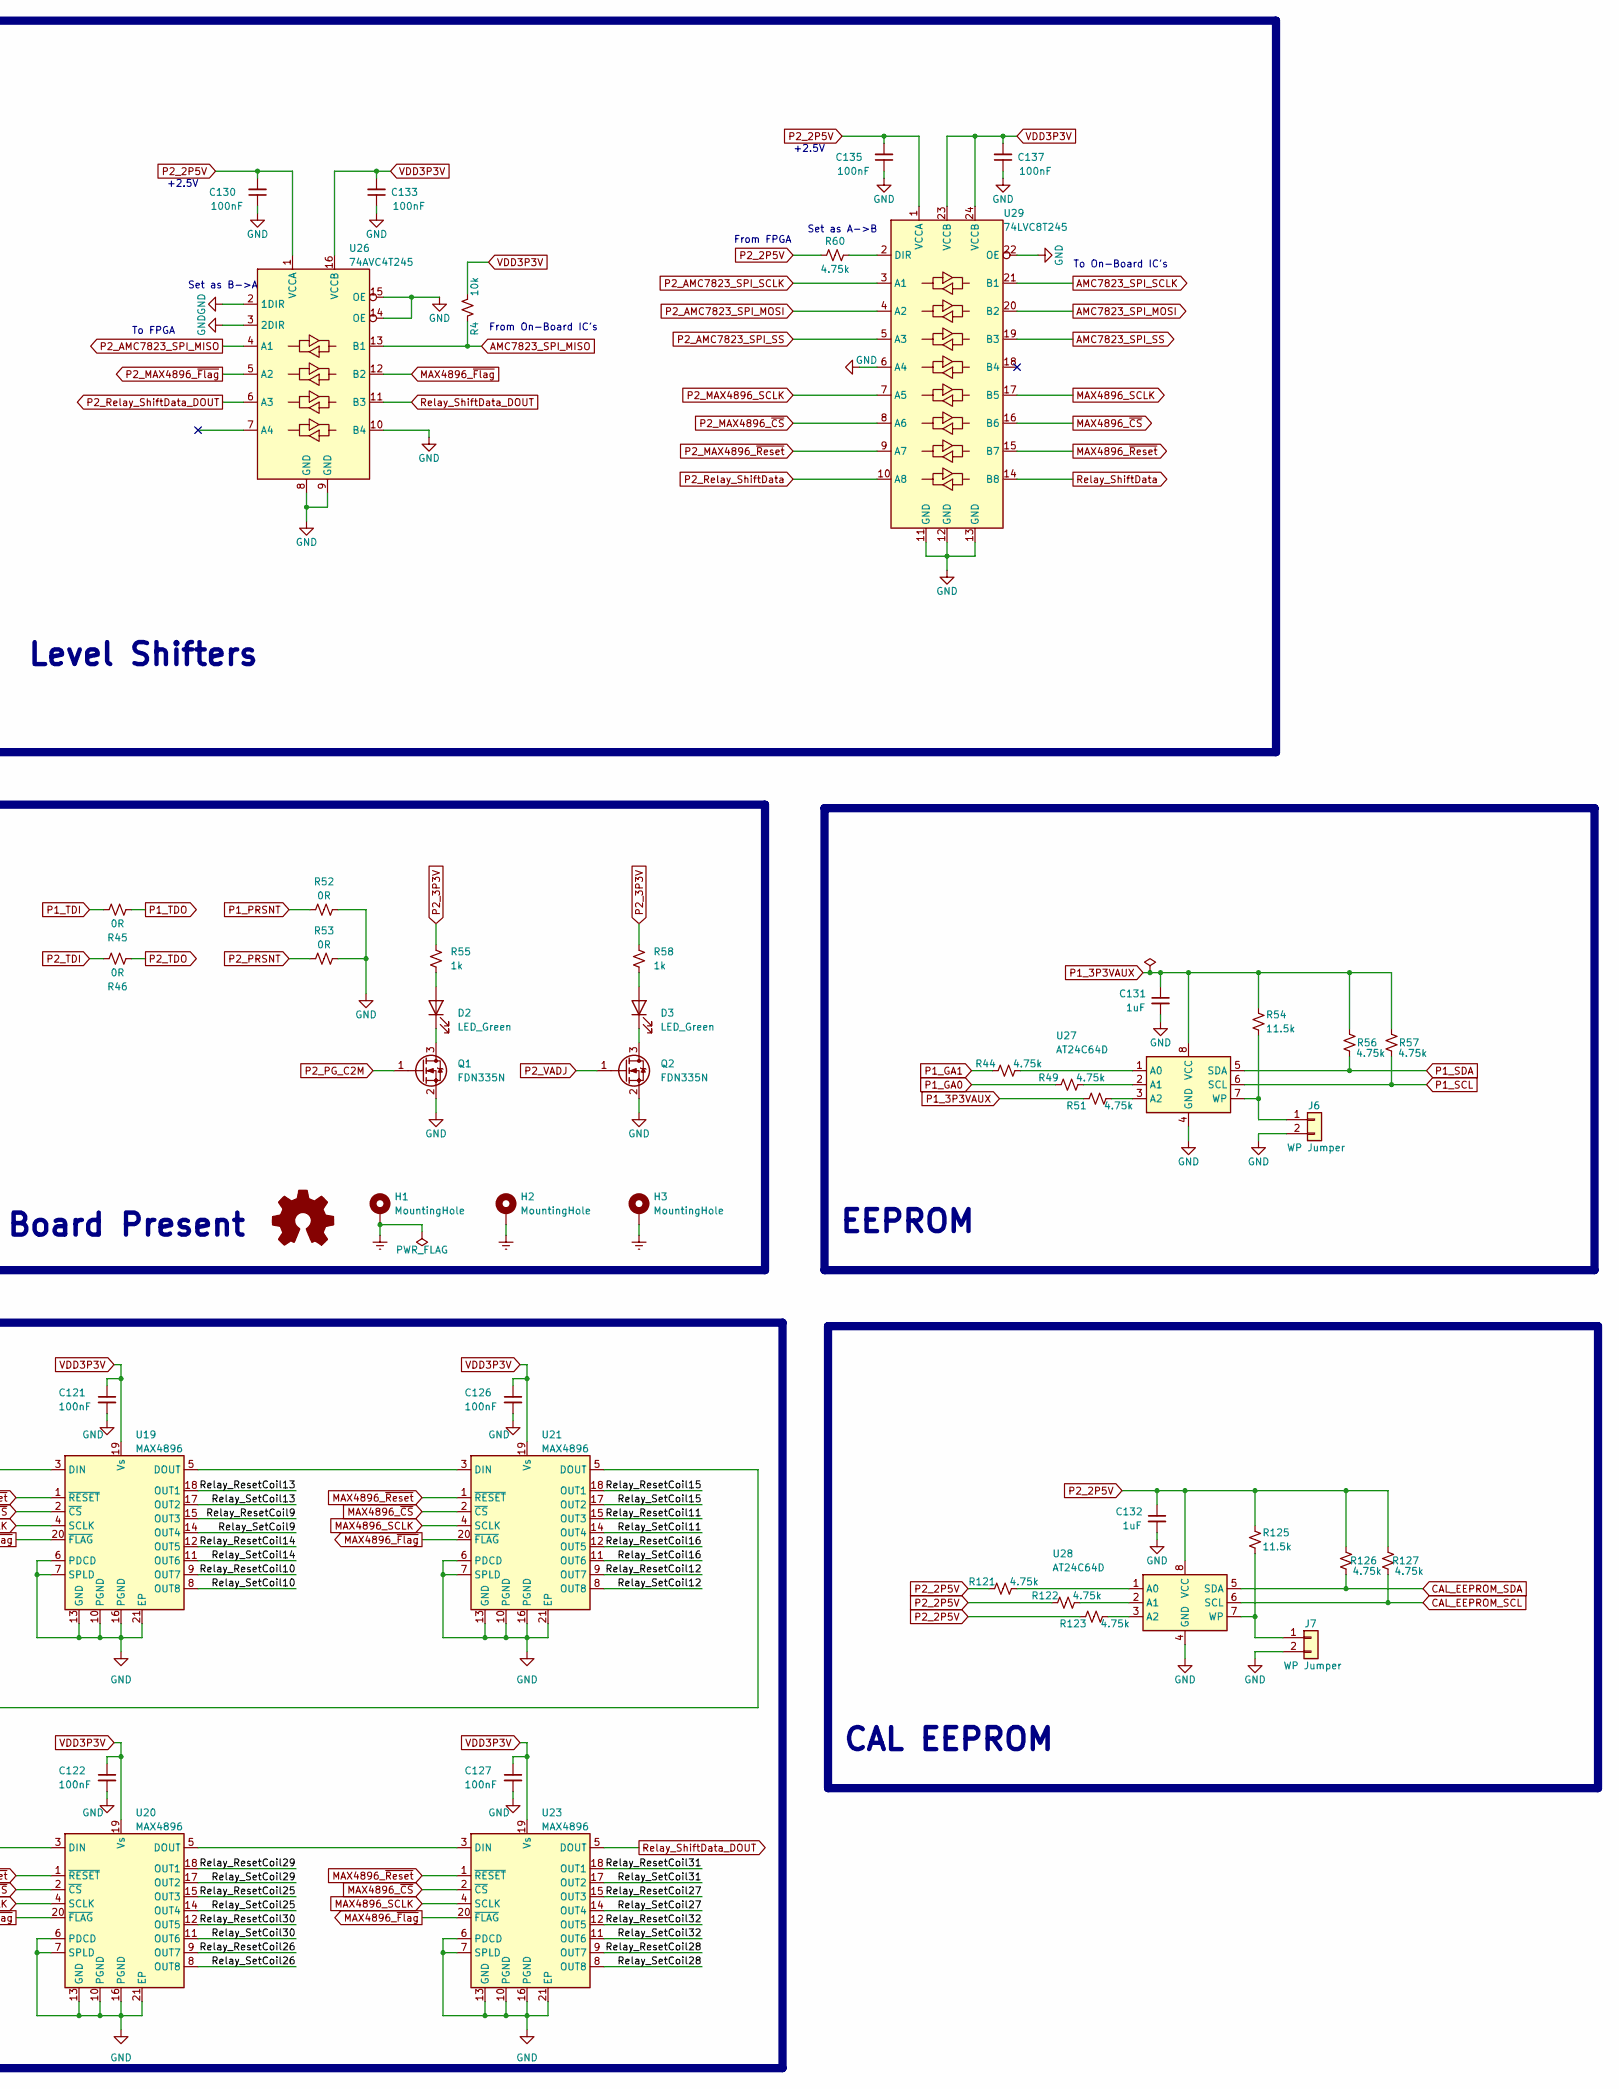
[picture p21: schematic Housekeeping.kicad_sch, Quartz, part in row 1, column 2]

Parts:
C89, C90, C91, C92, C96, C97, C98, C99, C100, C114, C120, C123, C124, C130, C133, C135, C137, C171, C172, C173: 100nF; C_0402_1005Metric; MPN CL05A104KA5NNNC
C94, C95, C116, C117, C121, C122, C126, C127: 100nF; C_0603_1608Metric; MPN CL10B104KB8NNWC
C131, C132: 1uF; C_0603_1608Metric; MPN CC0603KRX7R7BB105
D1, D2, D3: LED_Green; LED_0603_1608Metric; MPN APT1608CGCK
H1, H2, H3: MountingHole; MountingHole_3mm_Pad
J4: Conn_02x10_Odd_Even; PinHeader_2x10_P1.27mm_Vertical_SMD; MPN M50-3601042R
J5: PPS IN; SMA_Amphenol_901-144_Vertical; MPN 901-144-8RFX
J6, J7: WP Jumper; PinHeader_1x02_P2.54mm_Vertical; MPN M20-9990245
Logo1: Logo_Open_Hardware_Small; Logo_2X
Q1, Q2: FDN335N; SOT-23; MPN FDN335N
R4, R43: 10k; R_0402_1005Metric; MPN RC0402FR-0710KL
R11: 10k; R_0603_1608Metric; MPN RC0603FR-0710KL
R16, R28, R29, R31, R32, R33, R34, R36, R48, R87, R94, R119: 4.75k; R_0603_1608Metric; MPN RC0603FR-074K75L
R23, R47: 2.49k; R_0603_1608Metric; MPN RC0603FR-072K49L
R30, R118: 22k; R_0603_1608Metric; MPN RC0603FR-0722KL
R35: 100R; R_0402_1005Metric; MPN RC0402FR-07100RL
R37: 150R; R_0603_1608Metric; MPN RC0603FR-07150RL
R39, R40, R41, R42: 22k; R_0402_1005Metric; MPN RC0402FR-0722KL
R44, R49, R51, R56, R57, R60, R121, R122, R123, R126, R127: 4.75k; R_0402_1005Metric; MPN RC0402FR-074K75L
R45, R46, R52, R53: 0R; R_0603_1608Metric; MPN ERJ-3GEY0R00V
R54, R125: 11.5k; R_0402_1005Metric; MPN RC0402FR-0711K5L
R55, R58: 1k; R_0603_1608Metric; MPN RC0603FR-071KL
R85, R90: 38.3k; R_0603_1608Metric; MPN RC0603FR-0738K3L
R95, R100: 100k; R_0603_1608Metric; MPN RC0603FR-07100KL
R124: 1M; R_0603_1608Metric; MPN CPF0603B1M0E1
U13: AMC7823; QFN-40-1EP_6x6mm_P0.5mm_EP4.6x4.6mm; MPN AMC7823IRTAT
U14, U15, U17, U18, U19, U20, U21, U23: MAX4896; TQFN-20-1EP_5x5mm_P0.65mm_EP3.1x3.1mm; MPN MAX4896ATP+
U16: SI5330B-B00205-GM; QFN-24-1EP_4x4mm_P0.5mm_EP2.6x2.6mm; MPN SI5330B-B00205-GM
U26: 74AVC4T245; TSSOP-16_4.4x5mm_P0.65mm; MPN SN74AVC4T245PWR
U27, U28: AT24C64D; SOIC-8_3.9x4.9mm_P1.27mm; MPN AT24C64D-SSHM-T
U29: 74LVC8T245; TSSOP-24_4.4x7.8mm_P0.65mm; MPN SN74LVC8T245PWR
U36: TL071H; SOT-23-5; MPN TL071HIDBVR
U37: TXU0101; SOT-23-6; MPN TXU0101DBVR

Connections:
15V+: C89.2, R85.1, U36.5 (V+); also elsewhere on the board
15V-: C90.2, R90.1, U36.2 (V-); also elsewhere on the board
+5V: C124.2, R11.1, U37.1 (VCCA), U37.5 (OE); also elsewhere on the board
+12V: R30.1; also elsewhere on the board
/Housekeeping/AD0: R100.2, U13.11 (CH0), U36.1
/Housekeeping/AD1: R85.2, R87.1, U13.12 (CH1)
/Housekeeping/AD2: R11.2, R16.1, U13.13 (CH2)
/Housekeeping/AD3: R30.2, R31.1, U13.14 (CH3)
/Housekeeping/AD4: R28.2, R29.1, U13.17 (CH4)
/Housekeeping/AD5: R23.2, R34.1, U13.18 (CH5)
/Housekeeping/AD6: R47.2, R48.1, U13.19 (CH6)
/Housekeeping/AD7: R118.2, R119.1, U13.20 (CH7)
/Housekeeping/DAC0: U13.6 (DAC0_OUT)
/Housekeeping/DAC1: U13.7 (DAC1_OUT)
/Housekeeping/DAC2: U13.8 (DAC2_OUT)
/Housekeeping/DAC3: U13.9 (DAC3_OUT)
/Housekeeping/DAC4: J4.17, U13.22 (DAC4_OUT)
/Housekeeping/DAC5: J4.15, U13.23 (DAC5_OUT)
/Housekeeping/DAC6: J4.13, U13.24 (DAC6_OUT)
/Housekeeping/DAC7: J4.11, U13.25 (DAC7_OUT)
/Housekeeping/EXT_REFIN: J4.19, U13.21 (EXT_REF_IN)
/Housekeeping/GPIO0: J4.9, R42.2, U13.27 (GPIO-0/~ALR0)
/Housekeeping/GPIO1: J4.7, R41.2, U13.28 (GPIO-1/~ALR1)
/Housekeeping/GPIO2: J4.5, R40.2, U13.29 (GPIO-2/~ALR2)
/Housekeeping/GPIO3: J4.3, R39.2, U13.30 (GPIO-3/~ALR3)
/Housekeeping/GPIO5: R37.1, U13.40 (GPIO-5)
/Relay_ResetCoil1: U14.15 (OUT3); also elsewhere on the board
/Relay_ResetCoil2: U14.9 (OUT7); also elsewhere on the board
/Relay_ResetCoil3: U17.15 (OUT3); also elsewhere on the board
/Relay_ResetCoil4: U17.9 (OUT7); also elsewhere on the board
/Relay_ResetCoil5: U14.18 (OUT1); also elsewhere on the board
/Relay_ResetCoil6: U14.12 (OUT5); also elsewhere on the board
/Relay_ResetCoil7: U17.18 (OUT1); also elsewhere on the board
/Relay_ResetCoil8: U17.12 (OUT5); also elsewhere on the board
/Relay_ResetCoil9: U19.15 (OUT3); also elsewhere on the board
/Relay_ResetCoil10: U19.9 (OUT7); also elsewhere on the board
/Relay_ResetCoil11: U21.15 (OUT3); also elsewhere on the board
/Relay_ResetCoil12: U21.9 (OUT7); also elsewhere on the board
/Relay_ResetCoil13: U19.18 (OUT1); also elsewhere on the board
/Relay_ResetCoil14: U19.12 (OUT5); also elsewhere on the board
/Relay_ResetCoil15: U21.18 (OUT1); also elsewhere on the board
/Relay_ResetCoil16: U21.12 (OUT5); also elsewhere on the board
/Relay_ResetCoil17: U15.15 (OUT3); also elsewhere on the board
/Relay_ResetCoil18: U15.9 (OUT7); also elsewhere on the board
/Relay_ResetCoil19: U18.15 (OUT3); also elsewhere on the board
/Relay_ResetCoil20: U18.9 (OUT7); also elsewhere on the board
/Relay_ResetCoil21: U15.18 (OUT1); also elsewhere on the board
/Relay_ResetCoil22: U15.12 (OUT5); also elsewhere on the board
/Relay_ResetCoil23: U18.18 (OUT1); also elsewhere on the board
/Relay_ResetCoil24: U18.12 (OUT5); also elsewhere on the board
/Relay_ResetCoil25: U20.15 (OUT3); also elsewhere on the board
/Relay_ResetCoil26: U20.9 (OUT7); also elsewhere on the board
/Relay_ResetCoil27: U23.15 (OUT3); also elsewhere on the board
/Relay_ResetCoil28: U23.9 (OUT7); also elsewhere on the board
/Relay_ResetCoil29: U20.18 (OUT1); also elsewhere on the board
/Relay_ResetCoil30: U20.12 (OUT5); also elsewhere on the board
/Relay_ResetCoil31: U23.18 (OUT1); also elsewhere on the board
/Relay_ResetCoil32: U23.12 (OUT5); also elsewhere on the board
/Relay_SetCoil1: U14.14 (OUT4); also elsewhere on the board
/Relay_SetCoil2: U14.8 (OUT8); also elsewhere on the board
/Relay_SetCoil3: U17.14 (OUT4); also elsewhere on the board
/Relay_SetCoil4: U17.8 (OUT8); also elsewhere on the board
/Relay_SetCoil5: U14.17 (OUT2); also elsewhere on the board
/Relay_SetCoil6: U14.11 (OUT6); also elsewhere on the board
/Relay_SetCoil7: U17.17 (OUT2); also elsewhere on the board
/Relay_SetCoil8: U17.11 (OUT6); also elsewhere on the board
/Relay_SetCoil9: U19.14 (OUT4); also elsewhere on the board
/Relay_SetCoil10: U19.8 (OUT8); also elsewhere on the board
/Relay_SetCoil11: U21.14 (OUT4); also elsewhere on the board
/Relay_SetCoil12: U21.8 (OUT8); also elsewhere on the board
/Relay_SetCoil13: U19.17 (OUT2); also elsewhere on the board
/Relay_SetCoil14: U19.11 (OUT6); also elsewhere on the board
/Relay_SetCoil15: U21.17 (OUT2); also elsewhere on the board
/Relay_SetCoil16: U21.11 (OUT6); also elsewhere on the board
/Relay_SetCoil17: U15.14 (OUT4); also elsewhere on the board
/Relay_SetCoil18: U15.8 (OUT8); also elsewhere on the board
/Relay_SetCoil19: U18.14 (OUT4); also elsewhere on the board
/Relay_SetCoil20: U18.8 (OUT8); also elsewhere on the board
/Relay_SetCoil21: U15.17 (OUT2); also elsewhere on the board
/Relay_SetCoil22: U15.11 (OUT6); also elsewhere on the board
/Relay_SetCoil23: U18.17 (OUT2); also elsewhere on the board
/Relay_SetCoil24: U18.11 (OUT6); also elsewhere on the board
/Relay_SetCoil25: U20.14 (OUT4); also elsewhere on the board
/Relay_SetCoil26: U20.8 (OUT8); also elsewhere on the board
/Relay_SetCoil27: U23.14 (OUT4); also elsewhere on the board
/Relay_SetCoil28: U23.8 (OUT8); also elsewhere on the board
/Relay_SetCoil29: U20.17 (OUT2); also elsewhere on the board
/Relay_SetCoil30: U20.11 (OUT6); also elsewhere on the board
/Relay_SetCoil31: U23.17 (OUT2); also elsewhere on the board
/Relay_SetCoil32: U23.11 (OUT6); also elsewhere on the board
ADC1_MCLK+: U16.10 (CLK3A); also elsewhere on the board
ADC1_MCLK-: U16.9 (CLK3B); also elsewhere on the board
ADC2_MCLK+: U16.14 (CLK2A); also elsewhere on the board
ADC2_MCLK-: U16.13 (CLK2B); also elsewhere on the board
ADC3_MCLK+: U16.18 (CLK1A); also elsewhere on the board
ADC3_MCLK-: U16.17 (CLK1B); also elsewhere on the board
ADC4_MCLK+: U16.22 (CLK0A); also elsewhere on the board
ADC4_MCLK-: U16.21 (CLK0B); also elsewhere on the board
AMC7823_SPI_MISO: R4.2, U13.34 (MISO), U26.13 (B1)
AMC7823_SPI_MOSI: U13.33 (MOSI), U29.20 (B2)
AMC7823_SPI_SCLK: U13.32 (SCLK), U29.21 (B1)
AMC7823_SPI_SS: U13.35 (~SS), U29.19 (B3)
CAL_EEPROM_SCL: R127.2, U28.6 (SCL); also elsewhere on the board
CAL_EEPROM_SDA: R126.2, U28.5 (SDA); also elsewhere on the board
Earth: H1.1, H2.1, H3.1; also elsewhere on the board
GND: C89.1, C90.1, C94.2, C95.2, C96.1, C97.1, C98.1, C99.1, C100.1, C114.1, C116.2, C117.2, C120.1, C121.2, C122.2, C123.1, C124.1, C126.2, C127.2, C130.1, C131.2, C132.2, C133.1, C135.1, C137.1, C171.1, C172.1, C173.1, J4.2, J4.4, J4.6, J4.8, J4.10, J4.12, J4.14, J4.16, J4.18, J4.20, J5.2 (Ext), J6.2, J7.2, Q1.2 (S), Q2.2 (S), R16.2, R29.2, R31.2, R32.2, R34.2, R48.2, R52.2, R53.2, R87.2, R94.2, R119.2, R124.2, U13.10 (SGND), U13.15 (AGND), U13.38 (DGND), U13.41 (EXP), U14.6 (PDCD), U14.7 (SPLD), U14.10 (PGND), U14.13 (GND), U14.16 (PGND), U14.21 (EP), U15.6 (PDCD), U15.7 (SPLD), U15.10 (PGND), U15.13 (GND), U15.16 (PGND), U15.21 (EP), U16.3 (In3), U16.4 (GND), U16.5 (GND), U16.6 (GND), U16.12 (GND), U16.19 (OEB), U16.23 (GND), U16.25 (GND), U17.6 (PDCD), U17.7 (SPLD), U17.10 (PGND), U17.13 (GND), U17.16 (PGND), U17.21 (EP), U18.6 (PDCD), U18.7 (SPLD), U18.10 (PGND), U18.13 (GND), U18.16 (PGND), U18.21 (EP), U19.6 (PDCD), U19.7 (SPLD), U19.10 (PGND), U19.13 (GND), U19.16 (PGND), U19.21 (EP), U20.6 (PDCD), U20.7 (SPLD), U20.10 (PGND), U20.13 (GND), U20.16 (PGND), U20.21 (EP), U21.6 (PDCD), U21.7 (SPLD), U21.10 (PGND), U21.13 (GND), U21.16 (PGND), U21.21 (EP), U23.6 (PDCD), U23.7 (SPLD), U23.10 (PGND), U23.13 (GND), U23.16 (PGND), U23.21 (EP), U26.2 (1DIR), U26.3 (2DIR), U26.8 (GND), U26.9 (GND), U26.10 (B4), U26.14 (OE), U26.15 (OE), U27.4 (GND), U28.4 (GND), U29.6 (A4), U29.11 (GND), U29.12 (GND), U29.13 (GND), U29.22 (OE), U36.3 (+), U37.2 (GND); also elsewhere on the board
I_MON: R118.1; also elsewhere on the board
MAX4896_SCLK: U14.4 (SCLK), U15.4 (SCLK), U17.4 (SCLK), U18.4 (SCLK), U19.4 (SCLK), U20.4 (SCLK), U21.4 (SCLK), U23.4 (SCLK), U29.17 (B5)
MAX4896_~CS: U14.2 (~CS), U15.2 (~CS), U17.2 (~CS), U18.2 (~CS), U19.2 (~CS), U20.2 (~CS), U21.2 (~CS), U23.2 (~CS), U29.16 (B6)
MAX4896_~Flag: R43.2, U14.20 (~FLAG), U15.20 (~FLAG), U17.20 (~FLAG), U18.20 (~FLAG), U19.20 (~FLAG), U20.20 (~FLAG), U21.20 (~FLAG), U23.20 (~FLAG), U26.12 (B2)
MAX4896_~Reset: U14.1 (~RESET), U15.1 (~RESET), U17.1 (~RESET), U18.1 (~RESET), U19.1 (~RESET), U20.1 (~RESET), U21.1 (~RESET), U23.1 (~RESET), U29.15 (B7)
unnamed: D1.1 (K), R37.2
unnamed: D2.2 (A), R55.1
unnamed: D2.1 (K), Q1.3 (D)
unnamed: D3.2 (A), R58.1
unnamed: D3.1 (K), Q2.3 (D)
unnamed: J4.1, U13.31 (CONVERT)
unnamed: J5.1 (In), R124.1, U37.3 (A)
unnamed: J6.1, R54.2, U27.7 (WP)
unnamed: J7.1, R125.2, U28.7 (WP)
unnamed: R90.2, R94.1, R95.1
unnamed: R32.1, U13.3 (ELDAC)
unnamed: R36.2, U13.4 (ISET_RESISTOR)
unnamed: R33.1, U13.26 (~RESET)
unnamed: U14.5 (DOUT), U17.3 (DIN)
unnamed: U15.3 (DIN), U21.5 (DOUT)
unnamed: U15.5 (DOUT), U18.3 (DIN)
unnamed: C91.1, U16.1 (In1)
unnamed: C92.1, U16.2 (In2)
unnamed: U17.5 (DOUT), U19.3 (DIN)
unnamed: U18.5 (DOUT), U20.3 (DIN)
unnamed: U19.5 (DOUT), U21.3 (DIN)
unnamed: U20.5 (DOUT), U23.3 (DIN)
unnamed: R44.2, U27.1 (A0)
unnamed: R49.2, U27.2 (A1)
unnamed: R51.2, U27.3 (A2)
unnamed: R121.2, U28.1 (A0)
unnamed: R122.2, U28.2 (A1)
unnamed: R123.2, U28.3 (A2)
unnamed: R60.1, U29.2 (DIR)
unnamed: R95.2, R100.1, U36.4 (-)
P1_2P5V: C172.2, C173.2, R23.1, U16.11 (VDDO3), U16.15 (VDDO2); also elsewhere on the board
P1_3P3VAUX: C131.1, R51.1, R54.1, R56.1, R57.1, U27.8 (VCC); also elsewhere on the board
P1_GA0: R49.1; also elsewhere on the board
P1_GA1: R44.1; also elsewhere on the board
P1_PRSNT: R52.1; also elsewhere on the board
P1_SCL: R57.2, U27.6 (SCL); also elsewhere on the board
P1_SDA: R56.2, U27.5 (SDA); also elsewhere on the board
P1_TDI: R45.2; also elsewhere on the board
P1_TDO: R45.1; also elsewhere on the board
P2_2P5V: C100.2, C114.2, C120.2, C123.2, C130.2, C132.1, C135.2, C171.2, R47.1, R60.2, R121.1, R122.1, R123.1, R125.1, R126.1, R127.1, U16.7 (VDD), U16.16 (VDDO1), U16.20 (VDDO0), U16.24 (VDD), U26.1 (VCCA), U28.8 (VCC), U29.1 (VCCA), U37.6 (VCCB); also elsewhere on the board
P2_3P3V: R55.2, R58.2; also elsewhere on the board
P2_AD7768_MCLK+: C91.2, R35.2; also elsewhere on the board
P2_AD7768_MCLK-: C92.2, R35.1; also elsewhere on the board
P2_AMC7823_SPI_MISO: U26.4 (A1); also elsewhere on the board
P2_AMC7823_SPI_MOSI: U29.4 (A2); also elsewhere on the board
P2_AMC7823_SPI_SCLK: U29.3 (A1); also elsewhere on the board
P2_AMC7823_SPI_SS: U29.5 (A3); also elsewhere on the board
P2_MAX4896_SCLK: U29.7 (A5); also elsewhere on the board
P2_MAX4896_~CS: U29.8 (A6); also elsewhere on the board
P2_MAX4896_~Flag: U26.5 (A2); also elsewhere on the board
P2_MAX4896_~Reset: U29.9 (A7); also elsewhere on the board
P2_PG_C2M: Q1.1 (G); also elsewhere on the board
P2_PRSNT: R53.1; also elsewhere on the board
P2_Relay_ShiftData: U29.10 (A8); also elsewhere on the board
P2_Relay_ShiftData_DOUT: U26.6 (A3); also elsewhere on the board
P2_TDI: R46.2; also elsewhere on the board
P2_TDO: R46.1; also elsewhere on the board
P2_Timing_Input: U37.4 (B); also elsewhere on the board
P2_VADJ: Q2.1 (G); also elsewhere on the board
P2_ValidCLK: U16.8 (LOS); also elsewhere on the board
Relay_ShiftData: U14.3 (DIN), U29.14 (B8)
Relay_ShiftData_DOUT: U23.5 (DOUT), U26.11 (B3)
VDD3P3V: C94.1, C95.1, C96.2, C97.2, C98.2, C99.2, C116.1, C117.1, C121.1, C122.1, C126.1, C127.1, C133.2, C137.2, D1.2 (A), R4.1, R28.1, R33.2, R36.1, R39.1, R40.1, R41.1, R42.1, R43.1, U13.16 (AVDD), U13.36 (BVDD), U13.37 (DVDD), U14.19 (Vs), U15.19 (Vs), U17.19 (Vs), U18.19 (Vs), U19.19 (Vs), U20.19 (Vs), U21.19 (Vs), U23.19 (Vs), U26.16 (VCCB), U29.23 (VCCB), U29.24 (VCCB); also elsewhere on the board

Parts of its further copies:
C28, C87: 100nF; C_0402_1005Metric; MPN CL05A104KA5NNNC

Connections of its further copies:
+5V: C28.1; also elsewhere on the board
GND: C28.2, C87.2; also elsewhere on the board
unnamed 577: C87.1; also elsewhere on the board

Notes on the sheet:
PPS Timing Input
Set as B->A
EEPROM
Voltage Monitor
CAL EEPROM
Set as A->B
Relay Drivers
From On-Board IC's
From FPGA
LVDS Clock Splitter
+2.5V
To FPGA
Level Shifters
Management DAQ
To On-Board IC's
Board Present

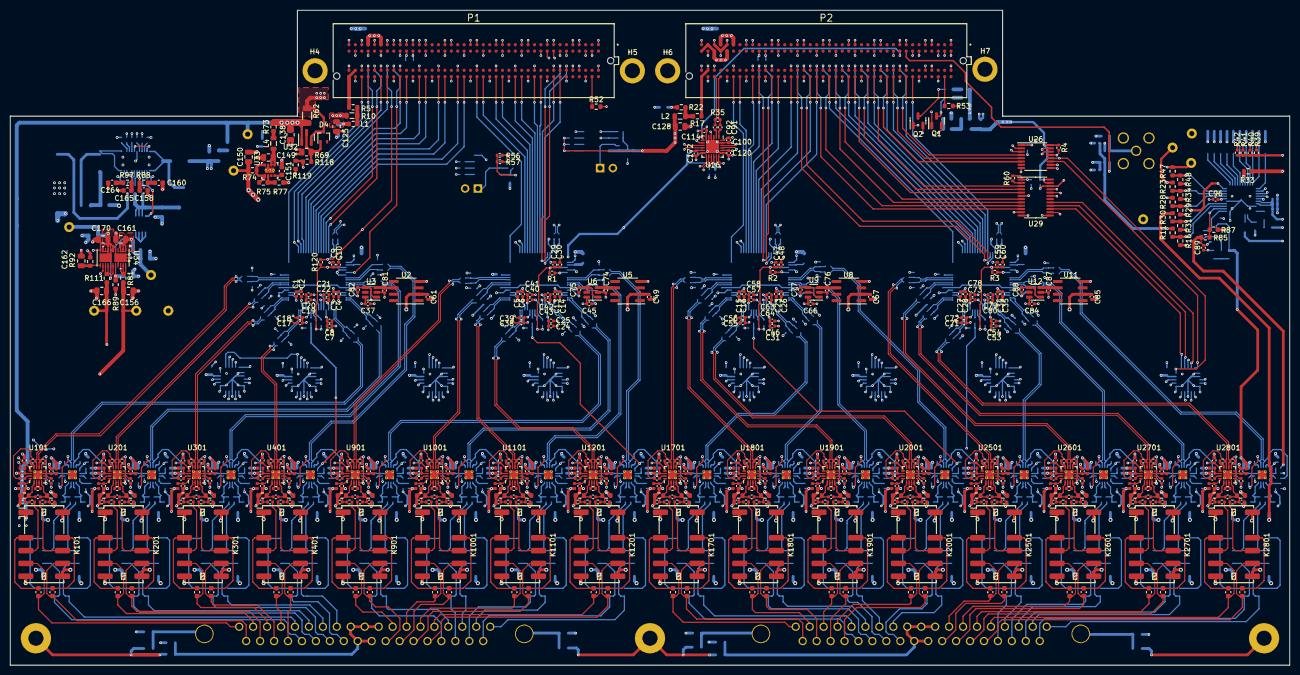
[picture p22: board Quartz.kicad_pcb from above]

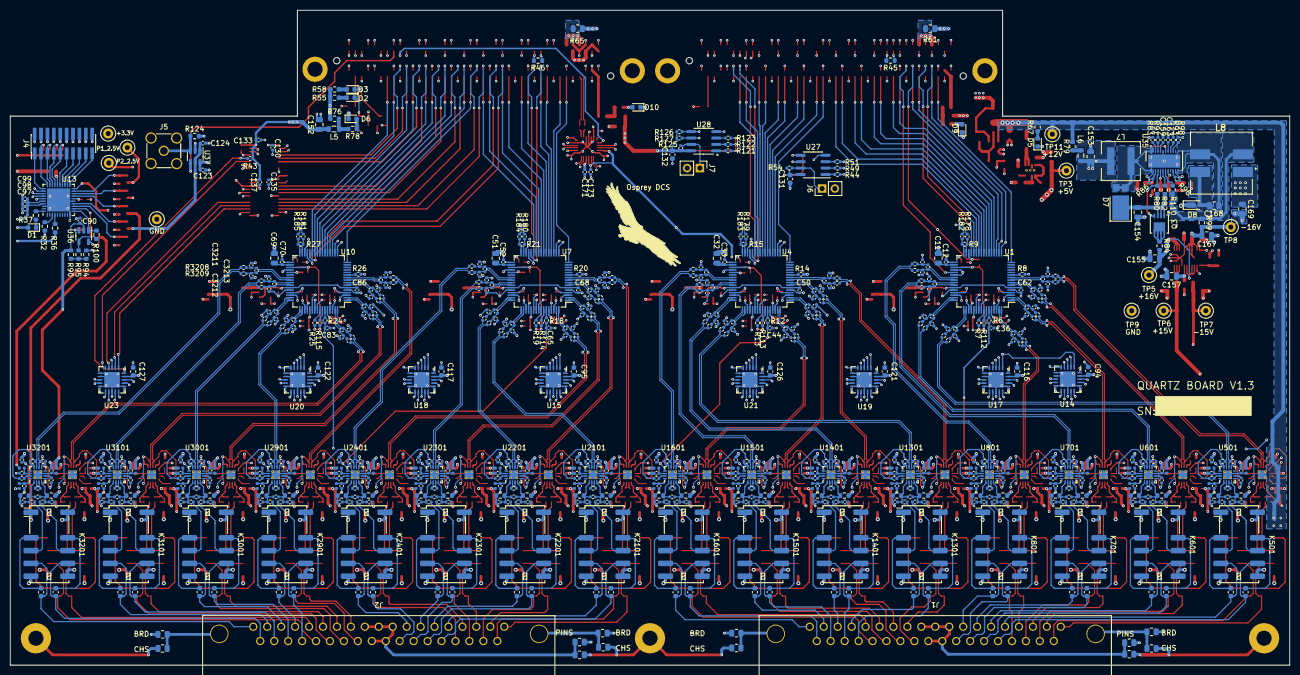
[picture p23: board Quartz.kicad_pcb from below]

Board: 6 copper layers, 254.0 x 130.0 mm, 1244 parts (709 on the bottom side), 998 nets.
