osprey-dcs/Quartz/Documentation/EEPROM/QuartzEEPROM.yml

# IPMI EEPROM

BoardInfo:
  mfg_date_time: '2024-04-25 09:00:00'
  manufacturer: 'Osprey'
  product_name: 'Quartz'
  serial_number: '001'
  part_number: '123'

MultirecordArea:
- type: DCLoad
  output_number: P1_12P0V
  nominal_voltage: 12000
  min_voltage: 11400
  max_voltage: 12600
  max_noise_pk2pk: 0
  min_current_load: 0
  max_current_load: 1500

- type: DCLoad
  output_number: P1_3P3V
  nominal_voltage: 3300
  min_voltage: 3120
  max_voltage: 3460
  max_noise_pk2pk: 0
  min_current_load: 0
  max_current_load: 500

- type: DCLoad
  output_number: P1_VADJ
  nominal_voltage: 1800
  min_voltage: 1710
  max_voltage: 1890
  max_noise_pk2pk: 0
  min_current_load: 0
  max_current_load: 500

- type: FmcMainDefinition
  module_size: double_width
  p1_connector_size: lpc
  p2_connector_size: lpc
  clock_direction: m2c
  p1_a_num_signals: 68
  p1_b_num_signals: 68
  p2_a_num_signals: 0
  p2_b_num_signals: 0
  p1_gbt_num_trcv: 0
  p2_gbt_num_trcv: 0
  tck_max_clock: 0
