osprey-dcs/Quartz/(commit log)

2023-12-28 Inital Commit
    Inital Commit
    [AD7768_Digitizer.kicad_sch, ADC.kicad_sch, Housekeeping.kicad_sch, InputFiltering.kicad_sch, InputFiltering2_sch.kicad_sch, Inputs.kicad_sch, Power.kicad_sch, fmc.kicad_sch]
2024-01-02 Updated Schmatics
    Some outdated schematics were in the init commit. Uploded proper revision with tweaks.
    [AD7768_Digitizer.kicad_sch, ADC2.kicad_sch, Housekeeping.kicad_sch, InputFiltering.kicad_sch, InputFiltering2_sch.kicad_sch, Inputs.kicad_sch, Power.kicad_sch, Quartz_v1p1.kicad_pcb]
2024-01-03 Fixed FMC mapping Issue
    Fixed FMC pin mapping and added FMC pin mapping excel file
    [FMC Pin Mapping.xlsx, Housekeeping.kicad_sch, Quartz_v1p1.kicad_sch, Temp_Bridge.kicad_sch, fmc.kicad_sch]
2024-01-04 Updated Schematics with recent changes
    Made Updates with recent suggestions.
    [ADC.kicad_sch, Housekeeping.kicad_sch, Power.kicad_sch, Quartz_v1p1.kicad_sch, Temp_Bridge.kicad_sch, fmc.kicad_sch, input_filter_channel.kicad_sch]
2024-01-04 Updated Channel 1 and fixes from review
    Updated Channel 1 to use the INA851.
    Fixed the ORNTA part pinout.
    Fixed feedback on LT1763s.
    [ADC.kicad_sch, Power.kicad_sch, Quartz_v1p1.kicad_sch, fmc.kicad_sch, input_filter_channel.kicad_sch, input_filter_channel_INA851.kicad_sch]
2024-01-08 Schmatic Updates
    Updated:
    ADC MCLK signal
    Removed PMOD connectors
    Added Coax input for iRIG signal with 5V buffer
    Moved around FMC pin mapping
    Changed relay driver chip daisy chain order
    Changed all input AFE to new design based around the INA851 chip
    [ADC.kicad_sch, FMC Pin Mapping.xlsx, Housekeeping.kicad_sch, Power.kicad_sch, Quartz_v1p1.kicad_sch, Temp_Bridge.kicad_sch, fmc.kicad_sch, input_filter_channel_INA851.kicad_sch]
2024-01-09 Updated Schematics
    Changes:
    -Moved Input resistors to after Coupling Relay
    -Added diff cap at ADC input
    -Changed the ADC clocking configuration (added quad LVDS driver)
    -Changed some signal names for consistancy
    [ADC.kicad_sch, Housekeeping.kicad_sch, Power.kicad_sch, Quartz_v1p1.kicad_sch, fmc.kicad_sch, input_filter_channel_INA851.kicad_sch]
2024-01-11 Updated Schematics with latest suggestions
    updates:
    -Revised Power supply section
    -Changed clock buffer chip for ADC Clock
    - Added additional no pop & jumper parts for board debugging
    -Other small part changes
    [ADC.kicad_sch, Housekeeping.kicad_sch, Power.kicad_sch, Quartz_v1p1.kicad_sch, fmc.kicad_sch, input_filter_channel_INA851.kicad_sch]
2024-01-12 Schematic Updates
    -Fixed AMC7823 labels
    -Added present detect signals on FMC
    -Added ferrite beads in Power Section and AFE
    -Added 0R in power section
    -Revised EEPROM connections
    -Changed +5V SMPS part to one with an integrated inductor
    -Added more detail on FMC connector
    -Added file showing SMPS calculations
    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
    [ADC.kicad_sch, FMC Pin Mapping.xlsx, Housekeeping.kicad_sch, Power.kicad_sch, Quartz Design.xlsx, Quartz_v1p1.kicad_sch, fmc.kicad_sch, input_filter_channel_INA851.kicad_sch]
2024-01-16 Updated Schematic
    -Changed PPS input signal buffer
    -Made Tweaks to Power Supply section (Many involving the LT3097) as suggested by Trent.
    - general schematic clean up for readability
    [ADC.kicad_sch, Housekeeping.kicad_sch, Power.kicad_sch, Quartz_v1p1.kicad_sch, fmc.kicad_sch, input_filter_channel_INA851.kicad_sch]
2024-01-18 Update to Schematics; initial PCB commit
    -Updated Power, Housekeeping, and ADCs sheets.
    -Remapped FMC pins
    -Initial board layout commit
    [ADC.kicad_sch, Housekeeping.kicad_sch, Power.kicad_sch, Quartz_v1p1.kicad_pcb, Quartz_v1p1.kicad_sch, fmc.kicad_sch, input_filter_channel_INA851.kicad_sch]
2024-01-22 Updated Layout
    -Additional Layout Work
    [ADC.kicad_sch, Housekeeping.kicad_sch, Power.kicad_sch, Quartz_v1p1.kicad_pcb, Quartz_v1p1.kicad_sch, fmc.kicad_sch, input_filter_channel_INA851_flipped.kicad_sch]
2024-01-23 Updated Schematics with all suggestions
    -Added pull up resistors on SDO line to FPGA
    -Fixed some I/O flags to properly indicate direction
    -Added Bulk caps on 15V rails
    -Added series caps to AC couple the LVDS clock lines. See AN408 from the manufacture
    -Add Voltage monitor for 1.8V and 5V
    [ADC.kicad_sch, Housekeeping.kicad_sch, Power.kicad_sch]
2024-01-24 Updated Project
    Schematics:
    -updated level shifting IC's
    -Add notes to level shifters
    -Changed Relay Coil Driver channel mapping
    -Added additional Mounting Hole
    Layout
    -WIP To Complete:
    -Relay Driver ICs
    - Reworking LT8582 area
    - Level Shifters
    - Housekeeping ICs
    -Misc. error cleanup
    - Silkscreen adjust
    - Add Silkscreen SN & logo
    [ADC.kicad_sch, Housekeeping.kicad_sch, Power.kicad_sch, Quartz_v1p1.kicad_pcb, Quartz_v1p1.kicad_sch, fmc.kicad_sch, input_filter_channel_INA851.kicad_sch, input_filter_channel_INA851_flipped.kicad_sch]
2024-01-25 Updated Project with Latest Changes
    Project:
    -Added pdf plots of PCB layout
    -Fixed L8 Pinout
    -Adjusted FMC connections
    -Adjusted level shifter connections
    Layout:
    -Completed AFE/ADC/Power/Relay driver sections
    Layout WIP To Complete:
    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
    [Housekeeping.kicad_sch, Power.kicad_sch, Quartz_v1p1.kicad_pcb, Quartz_v1p1.kicad_sch, fmc.kicad_sch, input_filter_channel_INA851.kicad_sch, input_filter_channel_INA851_flipped.kicad_sch]
2024-01-26 Push Version before ADC change from 1.8V to 2.5V I/O
    [ADC.kicad_sch, Housekeeping.kicad_sch, Power.kicad_sch, Quartz_v1p1.kicad_pcb, Quartz_v1p1.kicad_sch, fmc.kicad_sch, input_filter_channel_INA851.kicad_sch, input_filter_channel_INA851_flipped.kicad_sch]
2024-01-26 Changed ADCs to run on +2.5V VADJ
    Modified schematic to allow the ADCs to be run from the +2.5V VADJ inputs on the FMC connector.
    -All relevant ERC issues ran been looked into.
    -Still working on all Board DRC issues.
    [ADC_P2.kicad_sch, Housekeeping.kicad_sch, Power.kicad_sch, Quartz_v1p1.kicad_pcb, Quartz_v1p1.kicad_sch, input_filter_channel_INA851.kicad_sch, input_filter_channel_INA851_flipped.kicad_sch]
2024-01-29 Completed Schmatic and Layout
    All Schematic and Layout Task are complete with the following exceptions:
    - Adjust Silkscreen Layers
    - Add Osprey Logo and Serial Number
    Note-Removed Files no longer reference in the project
    [ADC.kicad_sch, ADC2.kicad_sch, ADC_P2.kicad_sch, Housekeeping.kicad_sch, Power.kicad_sch, Quartz_v1p1.kicad_pcb, Quartz_v1p1.kicad_sch, fmc.kicad_sch]
2024-01-29 Updated PCB
    Adjusted Silkscreen
    Added Logo and SN location
    [ADC.kicad_sch, Power.kicad_sch, Quartz_v1p1.kicad_pcb, input_filter_channel_INA851.kicad_sch]
2024-01-31 Finalized Design & Board
    Change to design
    -Added resistor options to choose the grounding of input connectors
    -uploaded libraries
    -uploaded generated BOM
    - adjusted mounting holes on front of board by 10mil
    -Changed input AC blocking cap to 10nF from 100nF due to part availability
    [5747847-06-o-3d.stp, 901-144-8RFX.stp, ADC.kicad_sch, ASP-134604-01.stl, ASP-134604-01.stp, Coilcraft-MSD1260-DEFAULT.IGS, Coilcraft-XAL6060.IGS, EE2-12TNU-L.step]
2024-01-31 Updates to Design
    -Flipped D10 to correct side of board
    -Moved and verified mounting hole position
    - Fixed PNs for R1,R2,R3 and LT8582 part
    -added configurable grounding for DB37 center pins
    [Housekeeping.kicad_sch, Power.kicad_sch, Quartz_v1p1.kicad_pcb, Quartz_v1p1.kicad_sch]
2024-02-14 Full upload of project as it was for prototype order
    -Fixed issue with L7 footprint as pointed out by sierra circuits
    -Updated all files with up to date info as it was ordered
    [FMC Pin Mapping.xlsx, Housekeeping.kicad_sch, Power.kicad_sch, Quartz v1p1 BOM Sierra.xlsx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]
2024-02-15 add local FP library and fix some model paths
    [Quartz_v1p1.kicad_pcb]
2024-03-11 Updated with all Quartz v1.2 changes
    -Fixed issue with pinouts on current sense chip and Mosfet on 15V split rail section
    -moved DB37 connectors by 30mil for front panel alignment
    - Added 12V test point
    [ADC.kicad_sch, Housekeeping.kicad_sch, Power.kicad_sch, Quartz v1p1 BOM Sierra.xlsx, Quartz.csv, Quartz_BOM Sierra.xlsx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]
2024-03-28 Updated to version 1.2.1
    This update fixes a few production documentation issues.
    The boards will be functionally identical to v1.2.
    With this update and going forward I moved away from version number as a part of filenames
    Updates:
    BOM ITEM 3 GRT155R61C474KE01D -> CGA2B3X7R1H473K050BB (wrong value)
    BOM ITEM 7 GRM1885C1H101JA01D -> GRM1555C1H101JA01D (wrong size)
    Corrected MPN description on BOM items 1&3 (CL05X105KP5NNNC &CL21A106KOQNNNE)
    Updated Silkscreen with Version Number
    Updated Schematic Title Block with current Date and Version Number
    [ADC.kicad_sch, Housekeeping.kicad_sch, Power.kicad_sch, Quartz BOM Formatted.xlsx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]
2024-05-06 Fix typo in manufacturing date change.
    [QuartzEEPROM.yml]
2024-09-09 Saved project as a Kicad8.0 Project
    Saved project as a Kicad8.0 Project
    [ADC.kicad_sch, Housekeeping.kicad_sch, Power.kicad_sch, Quartz.kicad_pcb, Quartz.kicad_sch, fmc.kicad_sch, input_filter_channel_INA851.kicad_sch]
2025-02-25 fix FMC schematic name
    [FMC.kicad_sch]
2025-02-26 Updating design to cover reworks
    Updating design to cover reworks.
    This should now match what has been delivered to NASA GRE-ATF after the board reworks.
    All outputs have been regenerated
    Changes are:
    1)Changed the clock splitter part to a 2.5V compatible part
    2)Changed some caps on the MCLK lines to 0R resitors
    [ADC.kicad_sch, Housekeeping.kicad_sch, Quartz BOM Formatted.xlsx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]
2025-04-08 Opened & Saved Project in Kicad 9
    - Opened & Saved Project in Kicad 9
    - Added .gitignore from main
    - Added sym-lib-table to link the unchanged symbol libs to the project
    [ADC.kicad_sch, FMC.kicad_sch, Housekeeping.kicad_sch, Power.kicad_sch, Quartz.kicad_pcb, Quartz.kicad_sch, input_filter_channel_INA851.kicad_sch]
2025-04-08 Updated and Condensed Project Symbol Libraries
    - Added Symbols for part used in main(Quartz v2 branch)
    -ADM1185
    -TPS275
    -TPS561208
    - Removed outdated/unused Symbol libraries
    - max4896 (project already copied contents to AD7768_Digitizer_SLib)
    - AD7768_Digitizer_SLibv2 (No links were made to this library under the current project)
    - Fixed Symbol Library Links on
    - U13 (Was pointing to AMC7823 lib; saved copy of part in AD7768_Digitizer_SLib & relinked)
    - U26 (Was pointing to Custom_Zest lib; saved copy of part in AD7768_Digitizer_SLib & relinked)
    - U29 (Was pointing to Custom_Zest lib; saved copy of part in AD7768_Digitizer_SLib & relinked)
    - Relinked P1 & P2
    Somehow this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
    [Housekeeping.kicad_sch]
2025-04-09 Fixed Serveral ERC errors
    Fixed Several ERC errors
    - Ignored off-grid connections errors
    - Updated a number of symbols from the Kicad default library. This should have no visual change
    - Power:Ground
    - Power:Earth
    - Device:LED
    - Relinked some symbols with a new copy in the AD7688_Digitaizer_SLib. This was to fix errors/warnings where local schematic changes were made. This process was opening the local symbol; saving a copy in the AD7688_Digitaizer_SLib; relinking the part to the new part in the AD7688_Digitaizer_SLib. This should have caused no visual change.
    - EC2-12TNU relays parts (K101 etc.)
    - U36 TL071
    - U16 SI5330 (had local edit to add pin25-gnd pad)
    - U32 TXU101
    - C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
    [ADC.kicad_sch, FMC.kicad_sch, Housekeeping.kicad_sch, Power.kicad_sch, Quartz.kicad_sch, input_filter_channel_INA851.kicad_sch]
2025-04-09 Fixed remaining ERC errors and Warnings
    No changes affecting copper were made.
    At the end of this commits changes all changes from this and the previous two commits were pulled into the PCB.
    No changes to the layout occurred and no additional pcb error or warning were made
    Detailed Changes:
    -Saved the Local Symbol to the project symbol lib and relinked for
    - Q1 & Q2 (looks like symbol was removed from std lib)
    - Max4896 IC's (U14..U23)
    - U32 | ZXCT1009F
    - L8 | MDS1260
    - Q3
    - U33
    - U34 to include thermal pad definitions
    - Mounting holes (Caused a footprint linking error as we linked to a custom footprint)
    - L7 (Caused a footprint linking error as we linked to a custom footp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
    [FMC.kicad_sch, Housekeeping.kicad_sch, Power.kicad_sch, Quartz.kicad_pcb, Quartz.kicad_sch, input_filter_channel_INA851.kicad_sch]
2025-04-11 Verified 'Must do changes' implemented all 'should do' changes
    Must do Changes that have been verified:
    -Change the Clock divider chip to the 2,5V part
    -Remove AC coupling caps in clock lines
    Should do changes implmented
    - Add pull up resistor to ADC reset lines
    - Internal termination of PPS (when unused)
    - Add Heat Sinking to inductors by increased traces/planes size (Copied/Based-On from V2 Design)
    - Changed to a 2.048V VREF with accompanying removal of INA851 gain resistor (this will give more dynamic range)
    - Move ground test points further away from power rails
    Also Included Some Improvments to the power rails seen in V2 when in comes to:
    -12V rail into the power section and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
    [ADC.kicad_sch, Housekeeping.kicad_sch, Quartz.kicad_pcb, Quartz.kicad_sch, input_filter_channel_INA851.kicad_sch]
2025-04-17 Improved grounding of Relay ICs
    -Added GND Via for Relay IC's and removed conflicting 3.3V rail
    - This has been replaced with a zone
    - Adjusted Zone around one of the inductors to avoid a copper sliver
    [Quartz.kicad_pcb]
2025-04-17 Added Calibration EEPROM
    -Added Calibration EEPROM
    -Changed WP headers to 100mil spaced part
    [FMC.kicad_sch, Housekeeping.kicad_sch, Quartz.kicad_pcb]
2025-04-17 Fixed Grounding under Clk divider
    Added Ground Vias Under the Si5330 Chip
    [Quartz.kicad_pcb]
2025-04-17 Changed Cal EEPROM to run off 2.5V
    Changed Cal EEPROM to run off 2.5V
    [FMC.kicad_sch, Housekeeping.kicad_sch, Quartz.kicad_pcb]
2025-04-18 Create output job, a couple of fixes
    - Created a output job file.
    - This will generate all the output products in a consistant way
    - This was tested OK agianst maunally creating the output objects
    - Removed Output Objects for version control
    - Removed a Power ERC net object from the CAL EEPROM to fix an ERC error
    - Added Explict Manufacturer for the test points for ordering clarity
    [ADC.kicad_sch, FMC.kicad_sch, Housekeeping.kicad_sch, Power.kicad_sch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]
2025-04-18 Moved EEPROM WP connectors to correct side
    -Moved EEPROM WP connectors to correct side
    [Quartz.kicad_pcb]
2025-04-18 Small Layout Tweaks before ordering
    -Added Gnd Via on P2 pads C36 & D37
    -Moved ground Vias to under pad on U35 (like Version2)
    -Cleaned up traces around U33 and removed faulty pour
    -Add ground vias under U13
    -Verified Q3 pin 1 marker is in the correct location (pin '3' as built in the layout is pin one of the package)
    [Quartz.kicad_pcb]
2025-04-18 Update Quartz-OutputJob for proper csv delimiting
    - fixed BOM export to use standard csv delimiting
